mklod/silvia-lever/_status.md

# Status

## Current milestone
**Beta — daily-driver.** `redesign-precision` was **merged to `master` 2026-07-06**; all work now lands on `master`. Live UI = "Precision Instrument" (`main_precision.qml` + `precision/` lib). In and working: Boiler Stage 9 (staged dual-heat, arbitration, OPV tuned), functional **shot replay**, **Settings** (dose/scale-cal/autotune), 10 Hz scale pipeline, pump quiet cap (50%) + pot-zero deadband. Pump = FG304: MG304 4 mm gear head + Fluid-o-Tech/Crouzet 24 V BLDC, 0–5 V speed control, TACHO out available (32 pulses/rev, unwired). Thermoblock PID: 46.94/0.516/3155.89 (TL).
**Pending:** hardware test of functional replay (pull a replayed shot); brew-temp stability/accuracy experiment (HEATING.md §8, the open "!!!"); resonance damping hunt (~650–1000 Hz, user); level probe (Silvia Pro) for auto-fill/dry-fire; optional tacho wiring → volumetric metering.

## Session 2026-08-18 (21:29) — Pump noise diagnosed (gear mesh + resonance), quiet cap, pot-zero fix
- **Pump noise root-caused with data, motor swap ruled out.** FFT/order analysis of a recorded pot sweep (100→66→33→0%): gear-mesh orders (7–16× shaft) dominate by 6–11 dB over BLDC commutation (24×) at every speed. A **structural resonance at ~650–1000 Hz** amplifies whichever order lands in it (same 982 Hz peak at different speeds/orders). So an FOC-servo/motor swap ≈ 1 dB — not worth touching the sole pump. Measured true max ~4200 rpm (not 5000).
- **PUMP_PWM_QUIET**: new cap for the open-loop full-speed states (FLUSH + both PRIME fills); 65% killed the scream + OPV chirp, then dropped to **50% (127)** to put fill/flush mesh below the resonance band. User: "dull hum, acceptable." Next lever if wanted: tap-test the bracket/panels/lines for the 650–1000 Hz ring and damp it (butyl/mass) — user investigating.
- **Manual-mode pot-zero bug fixed**: pump kept running at 0% — (a) EXTRACT pwm = pot + handoverOffset so residual takeover offset kept pumping; (b) small pot/ADC offset put 0.2–0.3 V on SPEED_IN where the driver runs its 300 rpm floor. `POT_ZERO_DEADBAND` (10 counts) forces PWM 0 at/below, all three manual-drive sites. Flashed.
- **Pump identity + specs nailed down** (memory + docs): FG304 = MG304 4 mm head (0.3 ml/rev) + Fluid-o-Tech/Crouzet 24 V BLDC w/ integrated 6-step driver. Manual: 0.3–5 V → 300–5000 rpm; **yellow wire = TACHO OUT, 32 pulses/rev (~9.4 µl/pulse)** → future volumetric metering (needs 5 V→3.3 V divider to a free pin, e.g. D2; declined for now). 4 mm gear set confirmed correct (13 bar headroom, finest low-flow control); 9 mm only viable with a stronger motor and would halve rpm.
- Earlier this session (2026-07-22): scale-latency fully fixed — firmware rolling trimmed-mean @80 SPS, UI Repeater churn removed, ChartCard glow via layered strokes + threaded raster (shadowBlur was janking the GUI thread to ~1 Hz during brews only).

## Session 2026-07-06 — Doc audit + stale-reference cleanup
- **Pump docs corrected everywhere.** `PLUMBING_NOTES.md` mislabelled the pump "Ulka-style vibratory" (topology diagram + a debug note referencing a "pump solenoid" / "cutting AC"). It is a **Fluid-o-Tech FG300 24 V BLDC gear pump**; 24 V is motor supply only, speed control is a separate 0–5 V input (pot → Teensy PWM → 1k/470 nF RC filter, so a 10 V cap on that filter is fine). Fixed. Remaining `solenoid` refs are the real 3-way **valves** (V1/V2); `vibration` refs are lever/load-cell mechanical noise — both legitimate.
- **Repo hygiene:** deleted stray `NDH6SA~M` ping-output junk files; gitignored `archive/` (**8.1 GB** of deprecated OS images that were untracked).
- **Untracked reference material still undecided:** `UI.UX/` (redesign design handoff/spec), `profiles/` (profiling research PDFs/imgs), `RC FILTER … .jpg` (PCB photo). Kept out of git pending a decision to track them or not.
- **CHANGELOG was ~1 month behind** (last build entry 2026-06-02); the entire redesign/replay/settings era wasn't logged. Catching it up.

## Session 2026-06-16 (18:50) — "Precision Instrument" UI redesign LIVE + heaters-off default
- **Heaters OFF by default.** Firmware `heatersEnabled` default → false; UI also pushes `SET_HEATERS_ENABLE 0` on connect (Teensy keeps state across Pi reboots, so the UI must disable each startup). User taps HEAT to enable. Verified `OK:HEATERS_DISABLED` on boot.
- **Full UI redesign implemented and switched live** (branch `redesign-precision`). New root `main_precision.qml` + `precision/` component library (Theme singleton, Overline, PButton, StatusBar, ColumnMeter, ChartCard, StatItem, InstrumentCol, Sparkline, PhaseChart, BackChip), reusing the existing CoffeeController backend. True-black monochrome + single red accent; Archivo + JetBrains Mono bundled (`ui/source/fonts/`, FontLoader). Glow via Canvas `shadowBlur` (renders software + GPU). Five screens: Home, Set-temp modal, Brew (live white-mass/red-pressure charts), Profile picker (firmware-accurate phase data in `precision/profiledata.js` + PhaseChart + table), Shot history/replay.
- **Wiring:** profile-row tap → `controller.setProfile()`; brand "SILVIA·LEVER" tap → history; new backend `requestShots()` + `shotsChanged` reads `brew_logs/` into the history list; REPLAY animates the stored curves (ChartCard `clipT`). Old `main.qml` kept intact as fallback.
- **Live-flip:** `run_silvia.py` + `main.py` now load `main_precision.qml`. Deployed + rebooted; grim grab of the real panel confirms it renders correctly (HEAT OFF, SET 250°/203°, PRIMED, real pot/pump values).
- **Known follow-ups:** brew_recorder doesn't store the active profile name (history shows "—"); replay is visual-only (no physical re-run); could promote a dedicated history entry affordance; merge `redesign-precision` → master after live use. Old screenshot harness `_render_screens.py` (old UI) still present.

## Session 2026-06-16 (13:48) — Default steam temp → 250 °F + startup setpoint restore
- **Default steam boiler temp is now 250 °F (121.11 °C)** (was 130 °C / 266 °F). Changed in `firmware/config.h` `DEFAULT_STEAM_TEMP`, `settings_manager.py` default, `main.qml` initial `steamTargetTemp`, and the live Pi `settings.json` (steam_temp 130→121.11, other keys preserved). Firmware recompiled clean (not reflashed — see below).
- **New: setpoints are pushed to the firmware on startup.** Added `_restore_temperatures()` (mirrors the existing scale-cal / PID restore) sending `SET_TEMP BREW/STEAM` on connect (singleShot 500 ms). Previously temps were the *only* persisted setting NOT restored to the firmware on boot, so the firmware used its own config.h defaults until the user opened the setpoint popup — a latent divergence (UI showed brew 95 °C but firmware brewed at its 93 °C default). Now the UI's saved setpoints are authoritative on every boot, so this change took effect **without a firmware reflash**. Verified on reboot: log shows `Restored setpoints: BREW 95.0 STEAM 121.11` → `OK:STEAM_TEMP_SET`.
- Routed voice-to-code item (id 4e1b9ef5). Deployed + rebooted; UI validated headless.

## Session 2026-06-10 (22:40) — Brew stop hardening: double-tap + timer-reset bug
- **Incident diagnosed (from Pi logs `silvia_20260610_205506.log`):** a ~2 min manual brew "stopped at 46 s on its own." Root cause was NOT a timeout — the brew screen's giant central `MouseArea` (covers most of the screen) calls `stopBrew()` on **any single tap** while BREWING, with no button/label/confirmation. A stray capacitive ghost tap (hand near the screen during the long brew) ended the shot. Confirmed: a lone UI-originated `CMD_SENT: STOP` at 46 s, no auto-stop in code (`max_brew_time`=300 s; comm watchdog fed by 5 s PING/PONG). **A 2-min brew is safe** — the only cap is the 5-min safety timeout.
- **Fix 1 — stop = single tap on the timer clock.** (Double-tap was tried first but felt unreliable on the touchscreen — reverted.) The big central area is now **start-only and disabled while BREWING**, so a stray tap anywhere can't end a shot. Stopping is a single tap on a focused `brewStopArea` MouseArea over the clock (enabled only while BREWING). The clock glows amber while brewing to signal it's the stop target; hint reads "tap clock to stop" / "tap to start".
- **Fix 2 — brew-timer reset / double-log bug.** `stopBrew()` left `_brew_start_time` set ("keep time displayed"), so logged durations grew cumulatively (the log showed 46 s **then** 54 s for one shot) and every back-arrow re-logged a bogus `BREW_COMPLETE`. Added a `_brewing` flag (True only between `beginBrew`→`stopBrew`); duration is logged only when a brew was actually running. STOP is still always sent to firmware (safe/idempotent). Displayed time still freezes at final (intended).
- Deployed to Pi 1 (md5 match), Python+QML validated headless, rebooted → UI relaunched clean. **Needs a hot re-test** (see checklist below).

## Session 2026-06-02 (13:35) — Gauge setpoint tick + overshoot indication
- **Setpoint tick mark on both gauges.** Added `tickValue`/`tickColor`/`tickWidth`/`tickOverhang` properties to `CircularSlider.qml`; draws a radial white dash across the track at the setpoint, positioned with the same orbit transform as the handle so it lands exactly on the arc.
- **Arc leaves overshoot headroom.** Gauge `maxValue` changed from `max(actual, target, 1)` to `target * 1.2`, so at setpoint the fill stops at the tick (~83 % of the arc) and overshoot visibly pushes the arc past the tick. `value` clamped to `maxValue` so a large overshoot pins at the scale top instead of overrunning the track.
- **Overshoot number: orange + pulsing (not red).** When actual > target the gauge number turns **orange #ff9500** and pulses opacity 1.0↔0.35 (450 ms, infinite) — the same "vibratey" nag style as the PRIME glow. Resets to solid white when back at/under setpoint.
- Deployed to Pi 1 (md5 match local), QML validated headless (offscreen+mock, no parse errors), Pi rebooted → UI relaunched clean.

## Session 2026-06-02 (13:14) — UX pass: °F units, cyan/purple gauges, auto-mode + auto-heat defaults
- Steam confirmed working end-to-end by user. Five changes (all on boiler-stage9):
  1. **Temp units °C → °F** — UI displays °F everywhere (gauges, brew-screen readout, steam screen, setpoint popup). Firmware stays °C; UI converts via cToF/fToC helpers; setpoint popup steps in 1 °F and clamps in °F (brew 140–230, steam 230–302), converts back to °C for SET_TEMP. (settingsScreen still °C but is currently unreachable — convert when a re-entry gesture is wired; see TODO.)
  2. **Gauge colors** — thermoblock now **cyan #00bcd4**, boiler **purple #9b59b6** (was blue/orange). Setpoint popup + PRIME button recolored to match.
  3. **Brew mode default AUTO** — firmware `autoBrewMode` defaults true; added as telemetry field 17 so the UI's BREW: AUTO/MAN button reflects firmware on boot (backend parses field 16).
  4. **Removed SCALE cell** from the debug row (weight still on the brew screen). Row now: heat, brew mode, profile, pressure, pump.
  5. **Auto-heat from cold boot without manual prime** — firmware `boilerPrimed` now defaults **true** (was false). Heating proceeds from boot (staged boiler-first preheat) with no PRIME step. Accepted dry-fire risk (user, minimal w/ conscientious use). PRIME button still fills manually. Backstops retained: MAX_STEAM_TEMP + thermal fuse + watchdog; level probe is the real fix.
- Telemetry now 17 fields (added autoBrewMode). Flashed (verified primed=1, auto=1), UI deployed (md5 match), QML validated headless.

## Session 2026-06-01 (14:16) — Steam works: OPV tuned, staged dual-heat verified on hardware
- **OPV adjustment solved the 99 °C dump.** Virgin steam-boiler OPV was set too low (relieved at ~0 bar → boiled off at 99 °C, never made steam). Torqued the OPV screw down to hold steam pressure → **zero steam / zero spitting on the boiler OPV water-return hose**, boiler climbed cleanly to **140 °C**, then the thermoblock reached its setpoint shortly after. Confirms the OPV setpoint caps boiler temp (saturation) per OG_SILVIA_OPERATION.md §5b.
- **Cold-start staging verified:** boiler heats first (thermoblock inhibited) to its target, emits `BOILER_READY`, then the thermoblock is released and reaches setpoint. No 16.6 A parallel warmup.
- **Steam-SSR fix confirmed working:** boiler SSR fires (digitalWrite on pin 16; analogWrite was a silent no-op — pin 16 isn't PWM on Teensy 4.0). Thermoblock stayed cold during boiler preheat.
- **Heater arbitration clarified/validated:** tapping BREW does NOT cut the boiler — it keeps maintaining in the background, throttled by the 1-tick mutex while the thermoblock is busy (coasts a few °C, covered by the +5 °C overshoot, recovers after the shot). STEAM is the only hard-cut: thermoblock → 0, boiler → full duty. Boiler is only fully off when unprimed / heatersEnabled off / over MAX_STEAM_TEMP. (Full state table added to HEATING.md §5.)
- **STEAM button role:** purely a heater-arbitration mode switch — no valve action (steam is the manual wand). It cuts the thermoblock and hands the boiler the full element for strong steam; without it the tick-mutex would split power → weaker steam.
- Still pending hardware: the Silvia Pro **level probe** (part 10701803, 3/8 BSP) for auto-fill + dry-fire safety (LEVEL_SENSING.md). Boiler is steam-only (not refilled by brewing) so this is the one genuine gap vs an OG Silvia.

## Session 2026-05-29 (01:26) — Stage 9 boiler implemented (branch boiler-stage9, pre-hot-test)
- **Fallback locked first:** tag `brew-only-stable` (master HEAD) + fallback hex saved locally and on Pi 1 at `/home/gram/silvia_fw_BREWONLY_FALLBACK.hex`. Boiler work is on branch `boiler-stage9`; master stays brew-only for morning coffee. To restore brew-only: `git checkout brew-only-stable`, or reflash the fallback hex.
- **Boiler enabled, task-switch model (brew XOR steam), firmware only — no current-monitor hardware** (user deferred the CT-clamp idea indefinitely).
  - Dry-fire prime gate: `boilerPrimed` (RAM). `arbitrateHeaters()` blocks all heating until primed. Prime = cold-fill (PRIME_BOILER → overflow → PRIME_DONE).
  - `arbitrateHeaters()`: steaming → thermoblock HARD CUT, boiler active; cold-start → boiler first, thermoblock inhibited until boiler at target; brew/idle → thermoblock active, boiler maintenance only on ticks thermoblock didn't fire (1-tick mutex → ≤8.3 A always).
  - Steam target = steamTemp + 5 °C overshoot. Telemetry +2 fields (boilerPrimed, boilerPreheatComplete). New PRIME_BOILER cmd; BEGIN_STEAM requires primed.
- **UI home reorg:** removed logo + CONNECTED text; two gauges side by side (THERMOBLOCK left w/ BREW+FLUSH, STEAM BOILER right w/ STEAM+PRIME); PRIME glows amber until primed; STEAM disabled until primed.
- **Validated:** firmware compiles (52504 B, hex at L:/tmp-pi-flash/build-boiler/); QML loads headless offscreen+mock, no parse errors, braces balanced.
- **NOT done:** hot test, Teensy flash, Pi deploy — all deferred to a supervised session so morning-coffee fallback stays intact. Next: flash boiler-stage9 + deploy UI + supervised hot test (prime → preheat → steam → brew, clamp-meter ≤8.3 A).

## Session 2026-05-22 (13:19) — light-roast profiles + debug-row cleanup
- Added 3 profiles (5 total): Blooming Allongé (4-seg: fill→bloom→percolate→declining taper — the fruity-light-roast profile), Blooming Espresso (3-seg), Allongé (2-seg). All from PROFILES.md §3.3/§3.4. Compiled, flashed, GET_PROFILES confirms all 5.
- Debug row: removed V1/V2 valve cells (water flow + valves verified working). Row now: heat, brew mode, profile, scale, pressure, pump.
- Gentle & Sweet first brew-test (build 0139): profile engine works — dead-flat 6 bar hold 49 s, zero overshoot. Shot ran slow (~0.59 g/s) — grind too fine for a 6-bar profile (lower pressure needs coarser grind), NOT a profile fault. Channeling visibly improved on bottomless PF.
- Portafilter debug: headspace/channeling root cause = Ascaso group is an E61-*variant*; Silvia PF is Rancilio-pattern → seats wrong. User ordered a couple aftermarket PFs to test. Gasket confirmed preinstalled (non-issue).
- Flash gotcha recurred: backgrounded teensy_loader_cli got SIGHUP'd when the SSH session closed → Teensy left in HalfKay. Re-ran loader directly (already in bootloader) → flashed. Going forward: nohup the loader, or run it foreground.
- Next: brew-test the new profiles, especially Blooming Allongé on a very light roast.

## Session 2026-05-22 (01:39) — Stage 1: brew profile engine + Gentle & Sweet
- Built the segment-table profile engine (PROFILES.md §3.2). A profile = ordered list of `(targetBar, slewRate, gains, exit)` segments; `runBrewSegmentEngine()` plays them through the Stage-0 slew-rate controller. The hardcoded preinfuse/ramp/hold state machine is gone.
- Two profiles: Profile 0 "Standard 9-bar" (faithful Stage-0 re-expression, regression baseline), Profile 1 "Gentle & Sweet" (light-roast starter — flat 6 bar hold).
- `SET_PROFILE`/`GET_PROFILES` serial commands. UI `PROF:` button in the debug row cycles profiles; qml_backend learns the list from firmware (no hardcoded names).
- Compiled clean, flashed, GET_PROFILES verified. **Not yet brew-tested** — Profile 0 regression + Profile 1 6-bar hold need a real shot.
- Flash gotcha: Teensy re-enumeration browned out Pi 1 mid-flash (it had prior "Undervoltage detected!" in dmesg). Power-cycle + re-flash recovered. Pi PSU is marginal — recommend a beefier 5V supply.
- Next light-roast profiles per §3.4: Blooming Allongé, Blooming Espresso, Allongé/Turbo, Adaptive Bloom.

## Session 2026-05-22 (00:36) — Stage 0 brew control finalized (slew-rate), manual takeover, AUTO/MAN toggle
- Brew-overshoot fight resolved. Three control designs tried on the real machine with a fine restrictive grind:
  1. Open-loop PWM ramp → 14 bar.
  2. Closed-loop linear RAMP-sweep + separate HOLD → ~11.5 bar overshoot at RAMP→HOLD boundary. Bumpless transfer / integrator reset / D-term all failed — root cause is pump→pressure transport lag (~200 ms), not tuning.
  3. **Final, working:** single PI(D) loop, one gain set, setpoint *slews* 1.0→9.0 bar at 0.8 bar/sec. Controller always keeps up, integrator self-adapts to puck. Verified zero overshoot, rock-steady 8.9 bar HOLD.
- RAMP + HOLD are now one loop (phase label telemetry-only). Removed `RAMP_MS`, `HOLD_MS`, per-phase `RAMP_*`/`HOLD_*` macros, and `rebaseIntegratorForTransition()`.
- Manual takeover: rotate pot >10% during RAMP/HOLD → bumpless handoff to pot (`handoverOffset` captured, no pressure step).
- AUTO/MANUAL: `autoBrewMode` firmware flag + `SET_AUTO_MODE` serial command + `BREW: AUTO/MAN` UI button (debug row, green/grey). Firmware defaults MANUAL.
- PREINFUSE retuned: 1.0 bar target, exit on 1 g OR 10 s hard cap (`PREINFUSE_MAX_MS`).
- Chart big-numbers freeze on brew stop (final weight/pressure readable after the shot).
- Firmware build/flash workflow established: arduino-cli (bundled w/ Arduino IDE 2.x) → pscp .hex to Pi 1 → teensy_loader_cli + 134-baud reboot. Gotcha: if 134-baud races an in-progress flash, Teensy sticks in HalfKay — just re-run the loader.
- All committed; docs (PROFILES.md §0/§1, CHANGELOG, this file) updated.
- **User flagged more changes coming next.**

## Session 2026-04-24 (20:17) — Pi 2 brought to parity; HDMI artifact narrowed to Silvia hardware

- Pi 2 setup needed several fixes that exposed gaps in `setup_rpi.sh` for Pi OS Lite:
  1. **labwc + kanshi + wlr-randr + seatd not installed by default on Lite** (they ship with the labwc-pi metapackage on Pi OS Full). Added to setup_rpi.sh package list.
  2. **bash_profile `exec /usr/bin/labwc`** caused getty start-rate-limit loop on headless boot (no display → labwc fails → bash exits → getty restarts → fail). Dropped the `exec` so bash falls through to interactive shell when no display is present. With display attached, labwc never returns until shutdown.
  3. **`pscp -r` from Windows strips +x bit** on `run_silvia.sh` and `run_silvia.py` → labwc autostart silently fails. Added defensive `chmod +x` early in setup_rpi.sh.
  4. **`quiet splash plymouth.ignore-serial-consoles` not in Pi OS Lite cmdline.txt** (Pi OS Full had them by default). Without `splash`, plymouth-start runs but draws nothing → kernel/systemd messages flood tty1 visibly. Added to cmdline patch loop.
  5. **`~/.config/kanshi/config` only auto-created by labwc-pi wrapper** (Pi OS Full). On Lite using plain labwc, no kanshi config = panel renders landscape instead of portrait. Bake the rotation profile into setup_rpi.sh.
  6. **`~/.config/labwc/rc.xml` not present on Pi OS Lite** (no labwc-pi installation). Without rc.xml's `<touch deviceName=... mapToOutput=...>`, touch coordinates stay in raw (un-rotated) space while display is rotated 90° → touch appears mirrored. Added `ui/rpi/labwc-rc.xml` to the repo and setup_rpi.sh installs it.
- Pi 2 now boots cleanly to either silvia kiosk (default) or pcmanfm desktop (debug mode), with touch correctly rotated and labwc + kanshi + silvia all autostarting.

### HDMI cold-boot artifact diagnostic

Pi 2 was used as an A/B reference for the pre-firmware HDMI panel artifact that the Silvia hardware shows on cold boot (bright/jarring "garbage" before kernel KMS comes up).

| Setup | Touch FW | Artifact |
|---|---|---|
| Silvia panel + Silvia driver board | yes | **YES** |
| Bench panel + bench driver board | yes (working) | **NO** |

So the artifact is NOT a generic "any touch firmware" issue — both setups have working touch FW now. **Variable causing the artifact is specific to the Silvia hardware combination** (panel, driver board, or board FW version).

Next decisive tests (require physical swap):
- Connect **Silvia panel** to **bench driver board**: if artifact disappears, the driver board is the cause. If it persists, panel is.
- Connect **Silvia driver board** to **bench panel**: if artifact appears there, board is cause. If not, panel is.

Either swap isolates root cause. Until done, GPIO/MOSFET hardware delay fix is on hold — the cause may be firmware-side on the driver board, in which case a FW config bit (e.g. "show test pattern on boot" debug flag) might be the entire fix with no electronics added.

## Session 2026-04-24 (15:55) — Stage 0 brew control, chart freeze, Pi 2 ready, Teensy flashed
- First hot test brew log analysed: PREINFUSE worked (2.53 bar at exit), but open-loop RAMP slammed fine grind to 13.97 bar peak; HOLD's P-only couldn't recover in 3 s; pot-controlled EXTRACT was too weak. Root cause: only PREINFUSE was closed-loop on pressure.
- **Stage 0 firmware shipped**: shared `pumpClosedLoop()` PI helper with anti-windup. RAMP rewritten as closed-loop pressure-target sweep (2.5→9.0 bar over RAMP_MS, no more PWM blast). HOLD made indefinite (removed HOLD_MS gate; user STOPs the brew). EXTRACT now manual-override only. I-term added everywhere.
- **Compiled** with arduino-cli (bundled with Arduino IDE 2.x at C:\Users\mklod\AppData\Local\Programs\Arduino IDE\resources\app\lib\backend\resources\arduino-cli.exe), `--fqbn teensy:avr:teensy40`. Output to L:\tmp-pi-flash\build\silvia_lever_main.ino.hex (191 KB).
- **Flashed** via `teensy_loader_cli` on Pi 1 (already installed). Soft-reboot trick: `python3 -c "import serial; serial.Serial('/dev/ttyACM0', 134); ..."` — Teensy USB Serial special baud 134 enters bootloader without physical button press. Booting confirmed.
- **UI freeze**: main.qml chart big-numbers freeze on BREWING→IDLE transition, clear on next BREWING. Live debug row keeps flowing. Pushed to Pi 1, rebooted, verified.
- **Pi 2 (silvia-pi-2 / 192.168.1.30)** is a complete drop-in replacement card. Setup via WSL-less workflow: dd-stream xz decompression → \\.\PhysicalDrive raw write via PowerShell-launched dd-for-Windows, cloud-init for first boot. Latest local working tree pscp'd, setup_rpi.sh ran clean. bash_profile updated to drop `exec` on labwc so headless boot doesn't trigger getty rate-limit loop. Boot 10.7 s headless. Will run full kiosk with HDMI + Teensy attached.
- Workflow established: edit firmware locally → arduino-cli compile → pscp .hex to Pi 1 → teensy_loader_cli + 134-baud reboot → flash. End-to-end ~30 sec from edit to running on the espresso machine.
- Next: brew test the new firmware. RAMP should sweep cleanly with no overshoot. If still high, drop RAMP_KP / RAMP_BASE_PWM. Then move to Stage 1 (named profile menu).

## Session 2026-04-24 (03:13) — plymouth black splash + invisible cursor, 8.04 s boot
- Plymouth re-enabled with custom all-black theme. Covers ~one of the two terminal text flashes during boot. Attempted to stretch coverage by masking plymouth-quit.service, but that deadlocks boot (plymouth-quit-wait blocks multi-user.target). Reverted. One residual flash remains in the plymouth-quit → getty → labwc window.
- Invisible cursor: `XCURSOR_THEME=empty` pointing at a user-local theme where every cursor file is a 1×1 transparent PNG (xcursorgen from python-generated PNG). Wired via `~/.config/labwc/environment`. Touch+mouseEmulation still works from labwc rc.xml.
- Pre-firmware display artifact is hardware-only: HDMI OLED panel powered off USB 5V which is live from moment-zero. Pi 4B can't cut USB power in software (VL805 hub). Discussed A/B/C options; user considering Pi 5 (2 GB is plenty for this workload — current usage is ~450 MiB on 4 GB Pi 4B).
- Boot best: 8.04 s (2.44 kernel + 5.61 userspace). 1× labwc, 1× kanshi, 1× silvia. Pending visual confirmation of cursor + flash-count from user.
- Next potential work if user cares enough: convert labwc startup from getty/bash_profile path to a systemd service so `plymouth-quit.service` can be ordered `After=labwc.service` — would close the last flash.

## Session 2026-04-24 (02:46) — kill desktop flash (labwc --config-dir isolation)
- Desktop/wallpaper/panel briefly visible before silvia = labwc-pi running `/etc/xdg/labwc/autostart` (pcmanfm-pi + wf-panel-pi + lxsession-xdg-autostart) unconditionally. A user-level `~/.config/labwc/autostart` did NOT override it — both ran, producing duplicate kanshi + duplicate silvia instances.
- Fix: skip `labwc-pi` wrapper entirely, bash_profile now `exec /usr/bin/labwc --config-dir ~/.config/labwc -m`. `--config-dir` pins labwc to one config dir — system autostart is never read.
- Post-reboot: 1× labwc, 1× kanshi, 1× silvia. No pcmanfm-pi, no wf-panel-pi, no lxsession-xdg-autostart. Duplicate silvia eliminated. Boot 9.22 s (2.50 kernel + 6.71 userspace).
- Baked into `setup_rpi.sh`. Pi env still inherited via `. /usr/bin/setup_env` (labwc-pi sourced it too).
- Two terminal flashes may still remain — plymouth black splash is the final option if user wants to fully eliminate them (~0.5 s cost).

## Session 2026-04-24 (02:36) — kill boot terminal flashes
- Cold boot still flashed a couple of terminal-text screens between firmware and labwc. Root cause: kernel + systemd + getty were spraying text onto tty1 — the same VT labwc takes over.
- Three-part fix:
  1. `console=tty1` → `console=tty3` in `/boot/firmware/cmdline.txt` (kernel/systemd output → invisible VT)
  2. agetty `--noissue --nohostname` + `TTYVTDisallocate=no` on the override (kills banner, smoother VT handoff)
  3. `~/.hushlogin` (silences pam_motd + last-login message during autologin)
- Boot 9.94 s (similar to 8.8 s, within noise). labwc + silvia confirmed autostarting via SSH — visual confirmation pending user cold-boot test.
- All baked into `setup_rpi.sh`. Pi backup at `/boot/firmware/cmdline.txt.pre-tty3-bak`.

## Session 2026-04-24 (02:28) — getty autologin race fixed (Type=idle), 8.8 s boot
- First reboot after the L2→L1 revert landed at the bare login prompt: agetty stuck in `(agetty)` state, autologin never fired, labwc/silvia never launched. `After=systemd-user-sessions.service` alone was not sufficient to beat the pam_nologin race.
- Added `Type=idle` to `/etc/systemd/system/getty@tty1.service.d/autologin.conf`. `Type=idle` holds the unit until systemd reports no other units are starting — enough extra slack for pam to clear pam_nologin consistently.
- Next reboot: labwc (pid 735) + silvia (pid 858) both came up automatically. Also boot time dropped: **10.6 s → 8.8 s** (systemd-analyze: 2.856 s kernel + 5.967 s userspace). Total reduction from baseline: 26.3 → 8.8 s (67%).
- Baked into `setup_rpi.sh` so fresh deploys get it. Comment block updated to explain the two-part fix (After= **and** Type=idle — neither alone is reliable).

## Session 2026-04-24 (02:10) — L2 reverted to L1, KIOSK.md created
- L2 (cage) tried — boot was 10.0 s but broke touch (libinput matrix not auto-rotated), showed persistent mouse cursor, and added two extra boot-screen flashes. Reverted to L1 (labwc-pi via getty autologin), boot now 10.6 s — within noise of L2.
- L2 leftover packages (cage, wlr-randr) kept installed; harmless when bash_profile points at labwc-pi.
- All other L2-era changes are orthogonal and stayed: NM→networkd swap, `systemd-networkd-wait-online` disable, static /etc/resolv.conf, getty autologin with `After=systemd-user-sessions`.
- New `KIOSK.md` at project root: boot-time journey (26.3 → 10.6 s, 60% reduction), things-tried-that-didn't-help log, L3 (Qt eglfs) and L4 (Alpine / Buildroot / Yocto / no-systemd) options with realistic estimates, deep dives on Buildroot + Yocto, honest "stop here" recommendation.
- `setup_rpi.sh` updated to write the L1 bash_profile (was L2 cage version) so a fresh deploy reproduces the working end state.

## Session 2026-04-24 (01:53) — L2 kiosk via cage (boot 11.7 s → 10.0 s)
- Replaced lightdm + labwc + pcmanfm-pi + wf-panel-pi with `cage -s -- silvia` directly. tty1 autologin fires `~/.bash_profile` which exec's cage. cage spawns wlr-randr (rotation fix for the portrait-native 1080×1920 panel) then silvia.
- Boot history: **26.3 → 10.0 s** total wall-clock from baseline (62% reduction). Multi-user.target at 6.59 s userspace.
- Two boot-race / DNS gotchas fixed and baked into `setup_rpi.sh`:
  - `getty@tty1.service` needs `After=systemd-user-sessions.service` or pam_nologin rejects the autologin
  - `/etc/resolv.conf` goes blank when NM is disabled (no auto-regen by networkd unless systemd-resolved is running) → write static fallback
- L1 (just removing lightdm) was a near-no-op (~0.3 s). L2 (skip the whole desktop stack) was the real win — pcmanfm-pi + wf-panel-pi spawning was the actual cost.
- Snapshots pre+post-L2: `silvia-rpi-snapshot-2026-04-24-0130.tar.gz` (L1) and `silvia-rpi-snapshot-2026-04-24-0153.tar.gz` (L2 current).
- Rollback: `cp ~/.bash_profile.l1.bak ~/.bash_profile && sudo reboot` reverts to L1 in 30 sec.

## Session 2026-04-24 (01:18) — NM → systemd-networkd swap (boot 15 s → 11.7 s)
- Swapped NetworkManager for `systemd-networkd` + `wpa_supplicant@wlan0`. WiFi association moved off the boot critical path. **graphical.target now at 7.45 s userspace** (was 11.07), total cold-boot to interactive ≈ 11.7 s (was 15.0).
- Done under `silvia-deadman` protection (10-min auto-revert). Confirmed clean within 30 s of reboot.
- NM kept on disk for one-command rollback (see `RPI_RESTORE.md`).
- `setup_rpi.sh` made idempotent for the swap (only fires if `wpa_supplicant-wlan0.conf` exists; protects WiFi creds from being baked into repo).
- Snapshots taken pre+post: `silvia-rpi-snapshot-2026-04-24-0041.tar.gz` (NM) and `silvia-rpi-snapshot-2026-04-24-0118.tar.gz` (networkd).

## Session 2026-04-24 (00:40) — Pi backup/restore + deadman + boot-trim post-mortem
- **Pi state snapshot**: `tools/rpi_snapshot.sh` tarballs every changed config + audit lists. First baseline saved to NAS.
- **`silvia-deadman` installed** on Pi (`/usr/local/bin/`). Generic auto-rollback timer for risky changes — arms a `systemd-run --on-active=Nm` transient that runs a revert command if user can't `confirm` in time. Smoke-tested arm/confirm cycle clean.
- **`RPI_RESTORE.md`** captures: snapshot contents + Path A (from tarball) and Path B (from scratch) restore recipes, per-change reversion commands, deadman usage with NM-swap example.
- **Boot-time post-mortem**: pushed from 26 → 15 s. Hit a structural floor at 15 s; documented in `setup_rpi.sh` header what was tried and abandoned (fastboot, IPv6 disable, BT disable, drop-in After/Before= resets, direct unit edits) so we don't re-explore. Real next steps for sub-15: A2 SD card (drop-in), systemd-networkd swap (config rewrite + deadman armed), USB SSD (hardware).

## Session 2026-04-23 (23:28) — HOLD phase + RPi boot trim + UI autostart
- **HOLD phase added** between RAMP and EXTRACT — closed-loop 9 bar for 3 s lets pump speed settle before user takes manual control. brewPhase enum now 0-3, backend + PROFILES.md updated.
- **RPi boot-time wins**: disabled `NetworkManager-wait-online` (5.9 s), masked entire `cloud-init` chain (~13 s), disabled `cups`/`bluetooth`/`ModemManager`/`rpi-eeprom-update`/`rpi-resize-swap`. Baseline 26 s → expected 13-15 s post-reboot.
- **UI autostart on boot**: `setup_rpi.sh` installs `~/.config/autostart/silvia.desktop`. Exec points to `run_silvia.sh` which always reads live `ui/source/` files, so scp'd updates take effect on next boot with no rebuild step.

## Session 2026-04-23 (21:09) — Auto preinfuse + brew recorder + PROFILES.md
- **Auto preinfuse landed** (firmware sub-state machine in STATE_BREWING): closed-loop P at 2.5 bar until 5 g in cup → 4 s linear PWM ramp to full → manual pot control. Tunables in `config.h`.
- **Per-brew JSON recorder** (`ui/source/brew_recorder.py`): every shot dumps to `brew_logs/brew_YYYY-MM-DD_HH-MM-SS.json` with metadata + 10 Hz samples. Substrate for Stage 8 profile derivation.
- **DATA telemetry** now 14 fields (added `brewPhase`).
- **`PROFILES.md`** created: documents current preinfuse + brew JSON schema + sketches Stage 8 named-profile system (schema, control modes, player loop, profile derivation from recordings).

## Session 2026-04-24 (02:24) — Thermoblock cold-start ramp measured
- **~58 s at 8.3 A continuous** to climb 25 °C → 88 °C (bang-bang handoff to PID). Captured via WiFi plug CSV (85 samples).
- Refines Stage 9 cold-start budget: boiler 6 min sequential + thermoblock ~1 min concurrent with boiler maintenance = **~7 min total cold → ready-to-brew + steam-available**.
- HEATING.md §1 / §5 updated with measurement + budget table; workplan S9.7c marked done.

## Session 2026-04-23 (17:19) — First successful PID autotune
- **Autotune ran end-to-end on hot thermoblock**: `Ku=142.9, Tu=139 s, a=1.14 °C → TL Kp=46.94, Ki=0.516, Kd=3155.89`. Auto-applied; persisted in `settings.json`; backend re-sends on every reconnect.
- **Three autotune bugs fixed:**
  - Asymmetric-period bug — was summing only heating halves ×2, so Tu underestimated ~3× → Kd came out wrong. Now sums every half-period.
  - Sanity bounds mismatch between autotune and `SET_PID` — autotune accepted new Kd, then restore rejected it. Bounds now identical (Kp<500, Ki<50, Kd<5000).
  - Hysteresis + timeout too tight — widened 0.5 → 1.0 °C, 10 → 25 min timeout.
- **Derivative-on-measurement + first-order low-pass filter** (`PID_D_FILTER_TAU = 2 s`) added to PID. Needed because TL's `Ku·Tu/6.3` = 3156 would noise-amplify raw PT1000 jitter. Filter lets real thermal slopes through, kills sensor noise.
- **`HEATING.md` updated** with asymmetric-period handling, widened bounds, derivative filter math, first-autotune result in revision log.

## Session 2026-04-23 (02:34) — PID autotune + bang-bang warmup + HEATING.md
- **Layered thermoblock control**: bang-bang full duty when `error > 5 °C`, PID when within band. Fixes first-hot-test overshoot.
- **Relay-feedback autotune** (`AUTOTUNE_START/STOP`) lands in firmware. UI Settings → PID → AUTOTUNE opens a live-log modal. Auto-applies Tyreus-Luyben gains on success; Python persists to `settings.json` + re-sends `SET_PID` on every reconnect.
- **Runtime PID gains** — `sys.kp/ki/kd` now mutable, seeded from `config.h`. New `SET_PID` command.
- **Test-mode config**: `heatersEnabled` default TRUE, boiler `controlSteamHeater()` calls removed. Flip both back before shipping.
- **New `HEATING.md`** — dedicated reference doc for thermal control, PID tuning procedure, Stage 9 dual-heater staggering design, SSR wiring notes.
- SSR wiring confirmed: L → SSR T1 → T2 → thermal fuse → element → N (SSR on hot side so element is isolated when off).

## Session 2026-04-22 (13:35) — Heater master switch + priming popup rewire

## Session 2026-04-22 (13:35) — Heater master switch + priming popup rewire
- **Firmware**: added `SystemData.heatersEnabled` (default OFF) gating both SSRs; `SET_HEATERS_ENABLE <0|1>` command; 13th field `heatersEnabled` in DATA packet. Compile-verified on Teensy 4.0.
- **Backend**: parses new field, `heatersEnabledChanged` signal + `setHeatersEnabled(bool)` slot. Removed the `_auto_primed_brew` auto-skip.
- **QML**: tap-to-toggle `HEAT: ON/OFF` cell in the persistent debug row (red bold when ON). Priming overlays rewired — window-level `brewPrimingOpen` / `steamPrimingOpen` properties decouple overlay visibility from firmware state; single START/STOP toggle (green↔red, based on `currentState == "PRIMING_*"`); `×` dismisses with optional abort; overlay auto-dismisses on STOP.
- **Flash pending**: user runs `tools/flash_and_run.ps1` when ready. RPi unreachable at push time (192.168.1.33 host unreachable), so QML/backend not yet copied to Pi.

## Session 2026-04-17 (00:52) — Tap-to-launch + disconnected navigation

## Session 2026-04-17 (01:00) — Tap-exit, Teensy hotplug hardening, pcmanfm UX
- **Exit tap zone** (`main.qml`): invisible 144×144 top-right MouseArea fires `Qt.quit()` — mirror of bottom-right E-stop. Lets the user leave fullscreen on the RPi without a keyboard.
- **pcmanfm `quick_exec=1`**: added to `~/.config/libfm/libfm.conf` so tapping a `.desktop` icon executes directly instead of popping the "Execute / Execute in Terminal" dialog. Together with `single_click=1` → true one-tap launch.
- **Teensy udev rule** (`ui/rpi/99-teensy.rules` → `/etc/udev/rules.d/`): `SUBSYSTEM=="tty", ATTRS{idVendor}=="16c0", ENV{ID_MM_DEVICE_IGNORE}="1", GROUP="dialout", MODE="0660"`. Prevents ModemManager from AT-probing the Teensy for ~5 s on hotplug (would block first UI connection). Also pins group/perms.
- **`setup_rpi.sh`** now idempotently: upserts libfm `[config]` keys, installs the udev rule + reloads, renders + trusts the desktop shortcut, runs `gdk-pixbuf-query-loaders --update-cache`.
- Verified: after all fixes, tapping the shortcut single-tap launches fullscreen with 0 dialogs.

## Session 2026-04-17 (00:52) — Tap-to-launch + disconnected navigation
- **UI runs cleanly without Teensy** — `safety_manager.py` now arm-on-first-telemetry (flag stays False until first packet), so no "EMERGENCY STOP: Communication timeout" spam when no hardware connected. Fires exactly once per disconnect event when previously armed.
- **Fixed `--mock` bug**: `qml_backend.py` now picks Mock vs Real SerialManager inside `__init__` via `_get_serial_manager_class()` helper. Previously bound at module load before CLI args parsed.
- **pcmanfm single-click**: `~/.config/libfm/libfm.conf` `single_click=1`. Touchscreen tap now launches instead of selecting/renaming.
- **Verified**: home screen rendered cleanly with RANCILIO logo visible, 0 error dialogs over 15s.

## Session 2026-04-17 (00:43) — Desktop shortcut on RPi
- Added `ui/rpi/silvia.desktop.in` template; `setup_rpi.sh` renders it to `~/Desktop/silvia.desktop` with correct paths, chmods +x, marks trusted via `gio`.
- Installed `qt6-svg-plugins` + `librsvg2-common` + ran `gdk-pixbuf-query-loaders --update-cache` → fixes both Qt's QML SVG rendering (for logo inside the app) AND pcmanfm's desktop-icon SVG rendering. Added to `setup_rpi.sh`.
- Desktop now shows "Silvia Lever" icon with logo; `dex` test confirmed shortcut launches the UI.

## Session 2026-04-17 (00:20) — RPi live deployment
- **Deployed to RPi 4B at 192.168.1.33** (user `gram`, Pi OS Bookworm, aarch64, labwc/Wayland).
- `scp`'d `ui/source/` and `ui/rpi/` to `/home/gram/silvia-lever/ui/`, ran `setup_rpi.sh`.
- **Additional packages discovered needed** (added to `setup_rpi.sh`): `qt6-wayland`, `libxcb-cursor0`, `libqt6svg6`, and the full set of `qml6-module-qtquick-*` runtime modules. `python3-pyqt6` alone is insufficient on Bookworm.
- `run_silvia.sh` updated to export Wayland env vars (XDG_RUNTIME_DIR, WAYLAND_DISPLAY, QT_QPA_PLATFORM) with fallbacks so SSH launches work.
- **Verified fullscreen 1080p rendering**: screenshot via `grim` shows BREW/STEAM/FLUSH buttons, 25°C gauge arc, DISCONNECTED indicator top-right, full debug row (SCALE/PRESS/PUMP/V1/V2) at bottom — all at correct 2× font scale. Platform shim reports `raspberry-pi`, scale 2.0, fullscreen True.
- **Pre-existing bug surfaced**: `--mock` flag ineffective because `qml_backend.py` imports `SerialManager` at module load before argparse runs. Not blocking real deployment (Teensy will be plugged in). Fix deferred.
- **SVG logo**: `libqt6svg6` installed but main.qml:339 still logs "Unsupported image format" on `logo.svg` — deferred (cosmetic only).

## Session 2026-04-16 (late) — RPi port via platform shim
- **Shared source tree**: `ui/windows/source/` → `ui/source/`. Same Python/QML runs on Windows dev and RPi.
- **`platform_shim.py`**: detects RPi via `/proc/device-tree/model`, sets `QT_SCALE_FACTOR=2.00` (1080p target = 2× the 960×540 Windows dev layout) and enables fullscreen by default. Qt renders natively at scaled size so fonts stay crisp — no QML edits required.
- **Wired into both entry points**: `main.py` (flash-and-run) and `run_silvia.py` (CLI with `--mock`/`--port`/`--fullscreen`). `apply_qt_env()` runs before `QGuiApplication` is constructed.
- **RPi launchers**: `ui/rpi/setup_rpi.sh` (apt deps, dialout group) + `ui/rpi/run_silvia.sh`.
- **Serial already cross-platform**: `serialcom/real_serial_manager.py` uses Teensy VID (0x16C0) via `pyserial`; auto-detects `COM*` on Win, `/dev/ttyACM*` on Linux. Zero code change.
- **Stale tree removed**: `ui/rpi/pyqt6/` (diverged pre-alpha), plus old `.txt`/`.rar` build notes.
- **Tooling**: `tools/flash_and_run.ps1` paths updated to `ui/source/`; `.gitignore` updated.
- **Docs**: workplan Stage 7 → DONE (80% total); key file table updated; CHANGELOG entry.
- **Verified on Windows**: `python main.py` loads QML, backend imports, Teensy auto-connects on COM9 — confirmed rename + shim didn't break anything.

## Last session (2026-04-16)
- **Scale subsystem solved end-to-end**:
  - Old load cell had silently failed (replaced with new mechanical assembly)
  - Switched to `getWeight(true, 32)` for 32-sample averaging → ±0.1g stability with cal factor 2050.65
  - Cal factor persists in `settings.json`; restored automatically on UI startup
  - Tare must still be done after each session (not persisted in firmware)
  - Scale stats writeup: `SCALE DRIFT, REPEATABILITY, UNCERTAINTY CALCULATIONS.md`
- **Plumbing finalized**:
  - Inverted V1 polarity so de-energised default = pump→thermoblock (heaviest duty)
  - V2 wiring: portafilter manifold on V2 IN; OUT2=drain (de-energised default → instant pressure relief)
  - Flush state corrected: V2 ON during flush (water through portafilter); V2 OFF on stop (drains pressure)
  - Plumbing notes + safety analysis: `PLUMBING_NOTES.md`
- **UI overhaul**:
  - Black background, white text, white-outline buttons throughout
  - Auto-save settings on each ±°C tap (no SAVE button)
  - Persistent debug row (SCALE / PRESS / PUMP / V1 / V2) at bottom of all screens with monospace, fixed-width values
  - Cal dialog: single modal, auto-tares on open, 1-second cal averaging (was 6.4 s at low SPS)
  - Brew screen: tap-anywhere-in-middle to start/stop brew, no play/pause buttons
  - Flush + Steam buttons converted to single-toggle with active "depressed" state
  - E-stop: invisible 144×144 bottom-right tap area, fires ABORT + red toast banner
- **Firmware cleanup**:
  - SPI hard-reset at top of `setup()` (Teensy 4.0 LPSPI4 stale-state fix)
  - Pump ENA on D3 (optoisolator gate, prevents boot glitch)
  - PUMP_PWM_FULL = 254 (255 outputs constant HIGH on Teensy 4.0)
  - NAU7802 init order: I2C → ADS1115 → pressure cal → PT1000 SPI → NAU7802 last
- **Tooling**:
  - `tools/flash_and_run.ps1` — one-shot compile/upload/launch via arduino-cli with `-NoCompile -NoUpload` flags for UI-only iteration
- **Doc cleanup**: removed stray `.txt` duplicates and root `settings.json`; `.gitignore` updated for `logs/`

## Next immediate task
- Plug Teensy into RPi → verify `/dev/ttyACM0` enumerates, UI flips to CONNECTED, telemetry streams
- Extended brew + steam + flush sessions on real hardware; collect logs for drift / regressions
- Tune PID after warming the thermoblock to setpoint a few times
- Autostart silvia on RPi boot (labwc-pi autostart entry or systemd --user unit)
- Decide on profile system (Stage 8) after a few weeks of real-world use

## Blockers
- None

## Key decisions
- SPI hard-reset at top of `setup()` is mandatory for SPI+I2C on Teensy 4.0
- NAU7802 init must include `setSampleRate` + `calibrateAFE`; init last in setup()
- Use `getWeight(true, 32)` for the scale read — single-call averaging gives ±0.1 g
- Both 3-way valves wired so the de-energised default is the most-used state (saves coil power and heat)
- V2 IN = portafilter manifold (NOT thermoblock outlet) — puts pressure sensor and relief path on the same physical port
- Cal factor lives in UI `settings.json` (not EEPROM); restored via SET_SCALE_CAL on connect
- Zero offset is firmware-RAM only; user re-tares each session (deliberate, simple)
- Pump ENA gate on D3 + PUMP_PWM_FULL = 254 are both required for the FG300 motor driver
- RPi port uses single shared `ui/source/` tree + `platform_shim.py` (not a separate RPi fork). Qt's native `QT_SCALE_FACTOR=2` handles 1080p scaling — no per-widget font edits needed.
- RPi Teensy access: udev rule `/etc/udev/rules.d/99-teensy.rules` is mandatory on Bookworm to stop ModemManager from hijacking the port on hotplug.
- Safety manager watchdog is arm-on-first-telemetry: never fires until a real packet has been received, so navigation-without-hardware is silent.
