mklod/silvia-lever/silvia lever PCB 2026-01.png

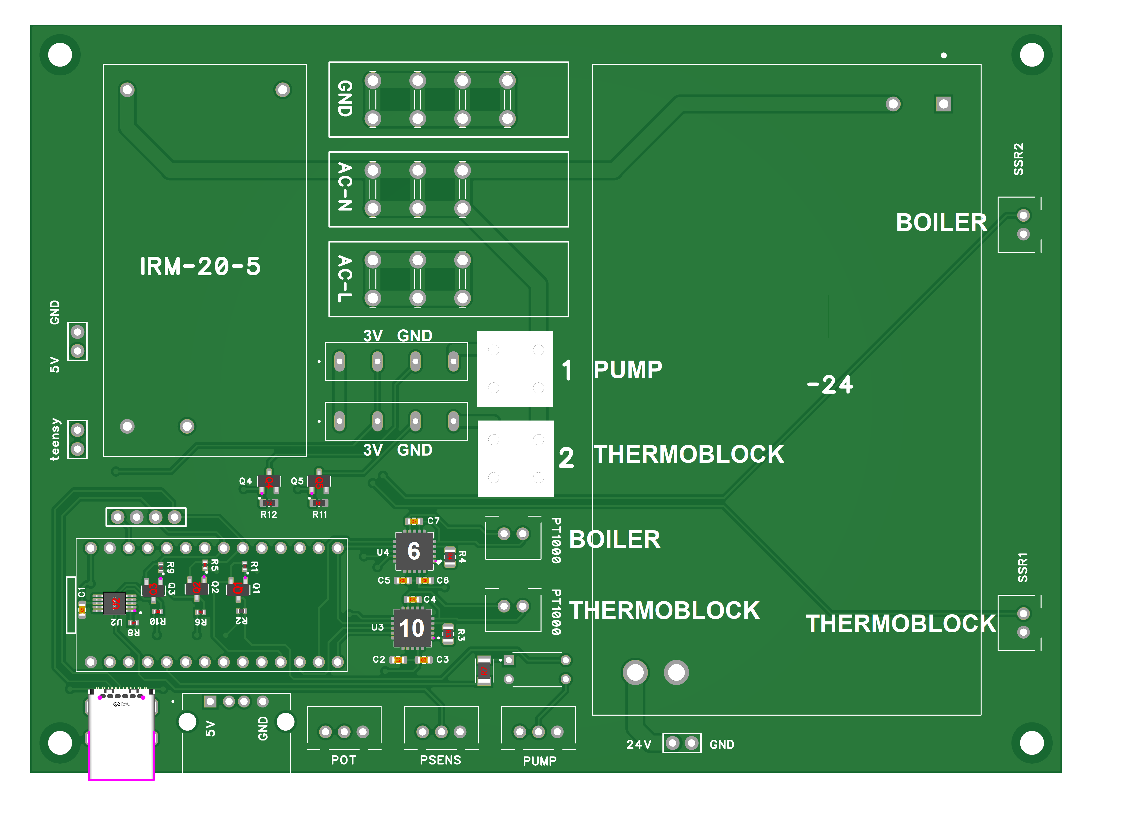
silvia lever PCB 2026-01.png
