mklod/silvia-lever/steam boiler amps.png

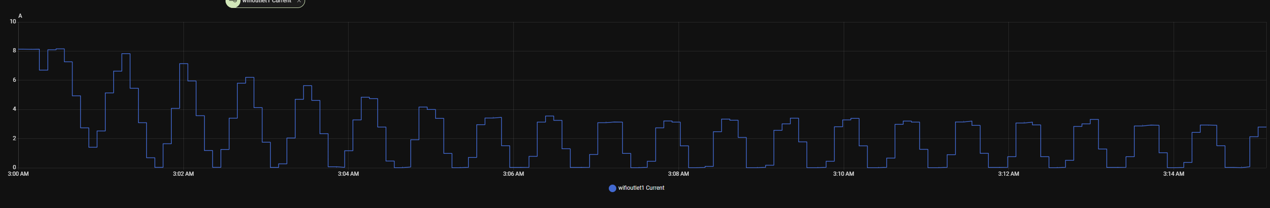
steam boiler amps.png
