mklod/silvia-lever/ui/screens_precision/01_home.png

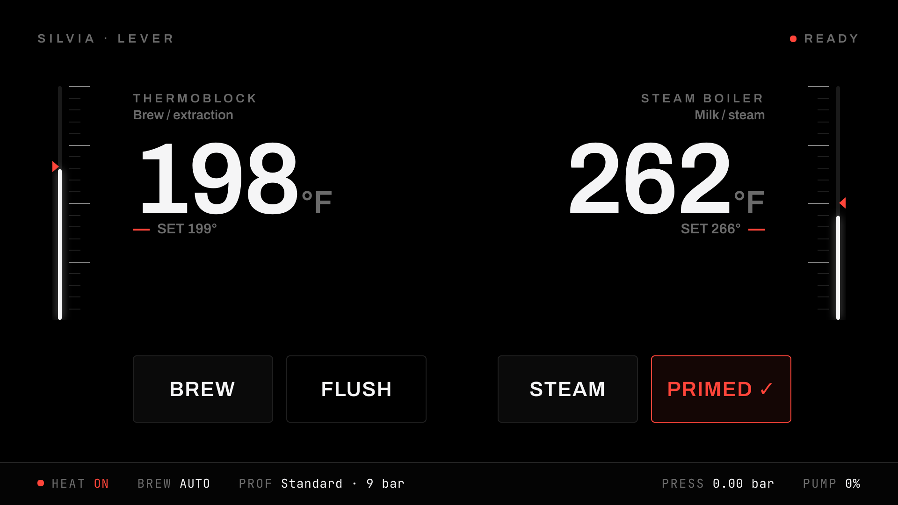
ui/screens_precision/01_home.png
