mklod/silvia-lever/ui/screens_precision/02_settemp.png

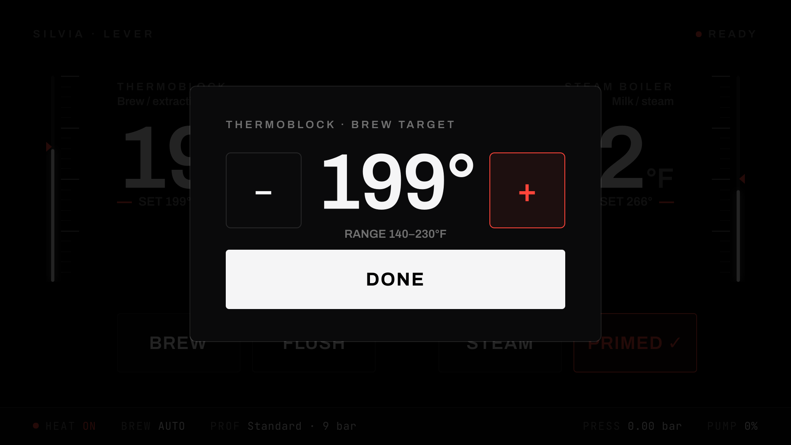
ui/screens_precision/02_settemp.png
