mklod/silvia-lever/ui/screens_precision/03_brew.png

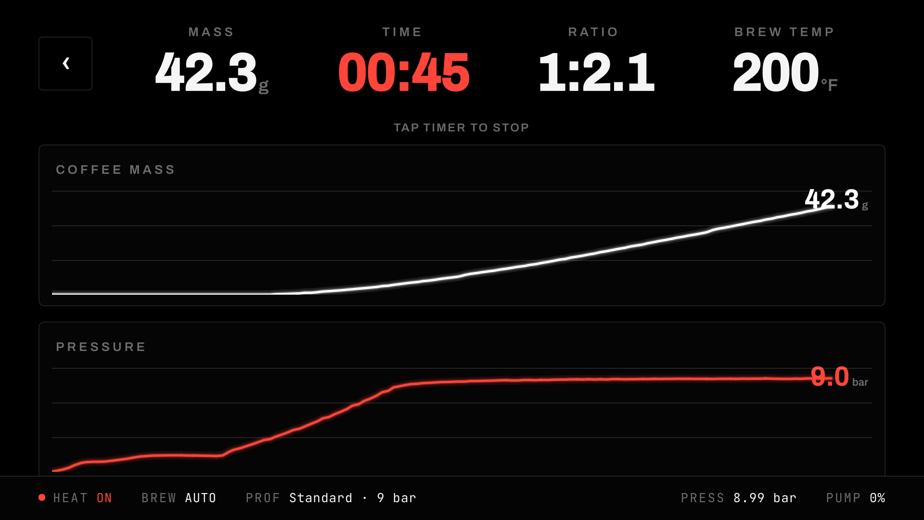
ui/screens_precision/03_brew.png
