mklod/silvia-lever/ui/screens_precision/04_profiles.png

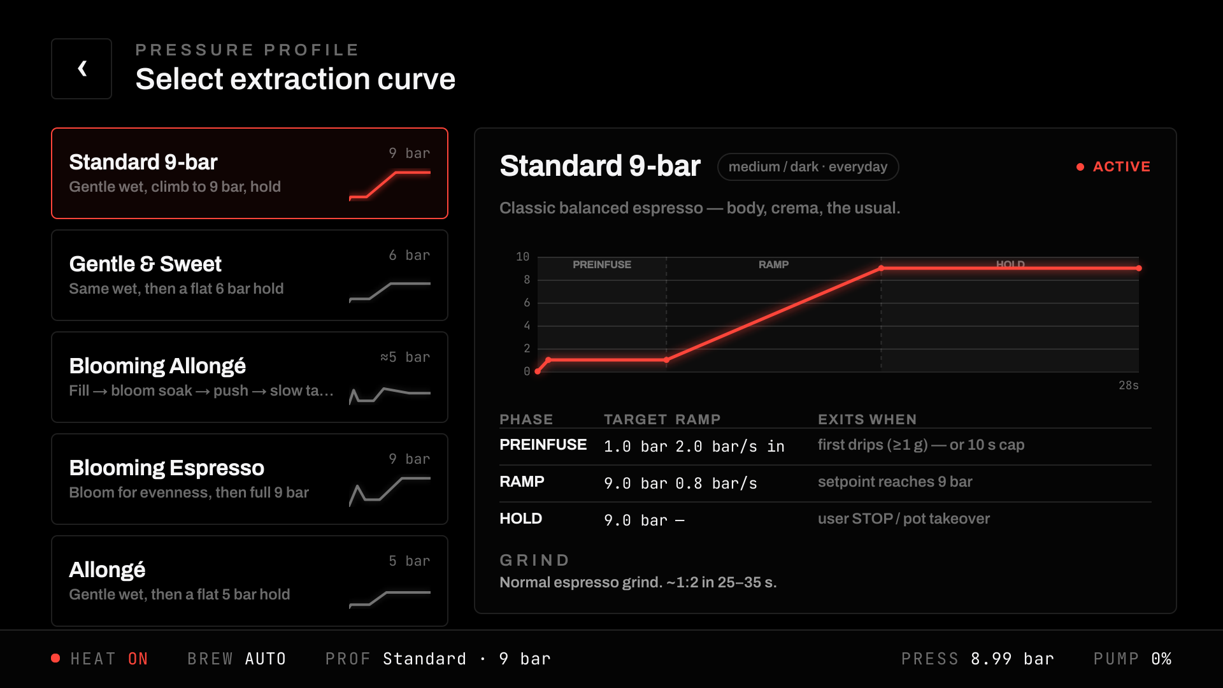
ui/screens_precision/04_profiles.png
