mklod/silvia-lever/ui/screens_precision/06_settings.png

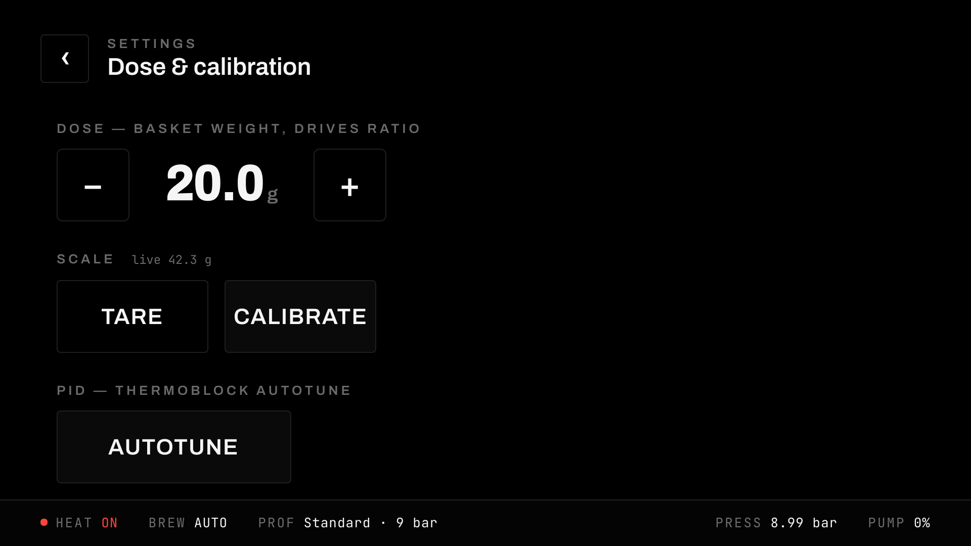
ui/screens_precision/06_settings.png
