mklod/silvia-lever/ui/screenshots/01_home_idle.png

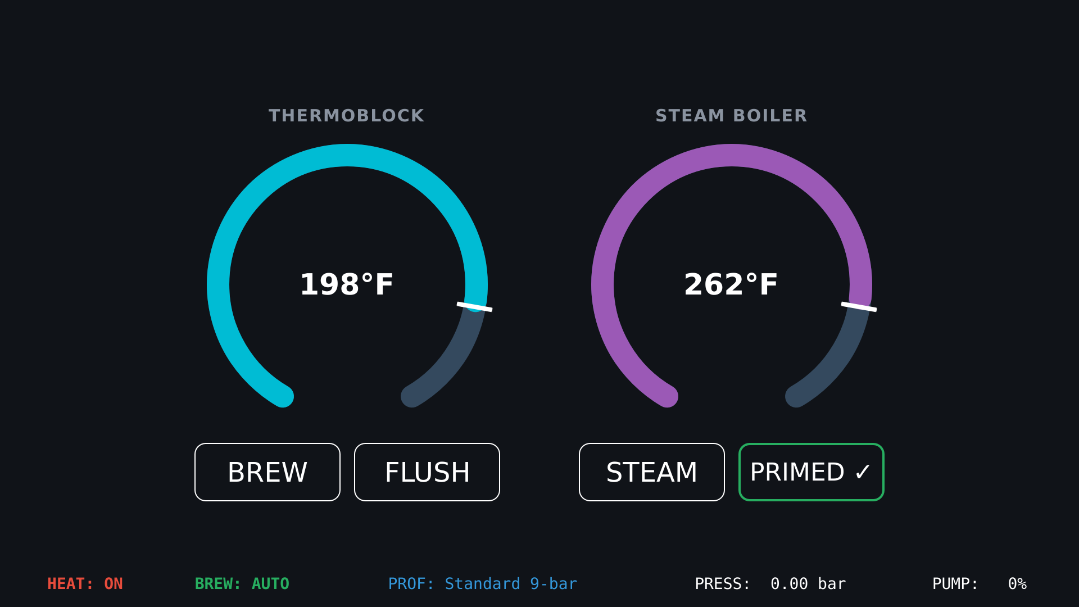
ui/screenshots/01_home_idle.png
