mklod/silvia-lever/ui/screenshots/02_home_setpoint_brew.png

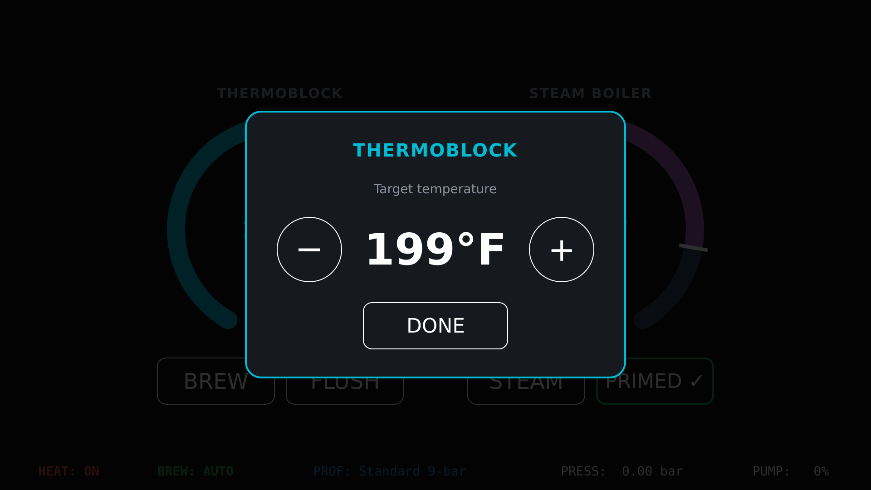
ui/screenshots/02_home_setpoint_brew.png
