mklod/silvia-lever/ui/screenshots/05_brew_ready.png

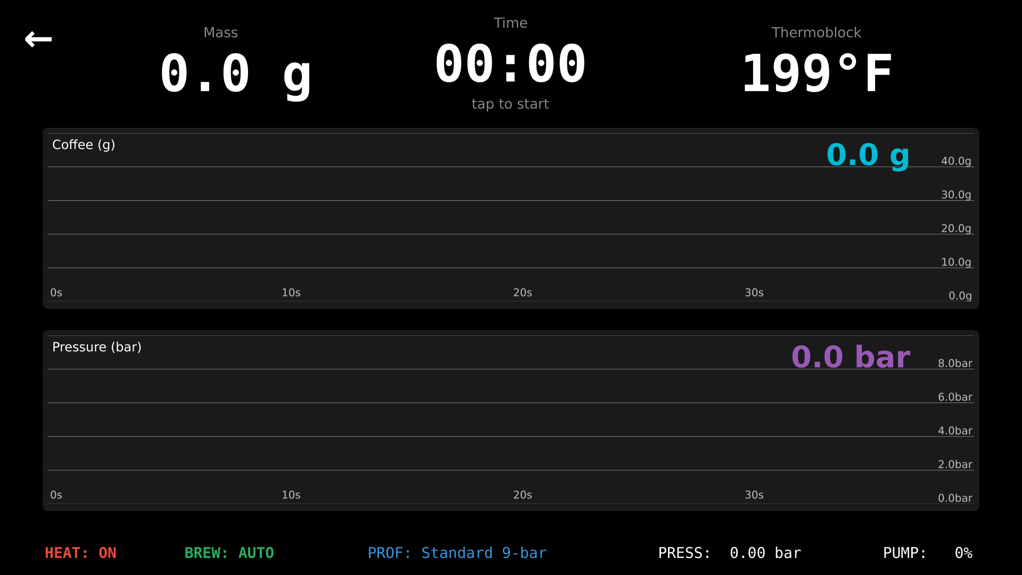
ui/screenshots/05_brew_ready.png
