mklod/silvia-lever/ui/screenshots/06_brew_brewing.png

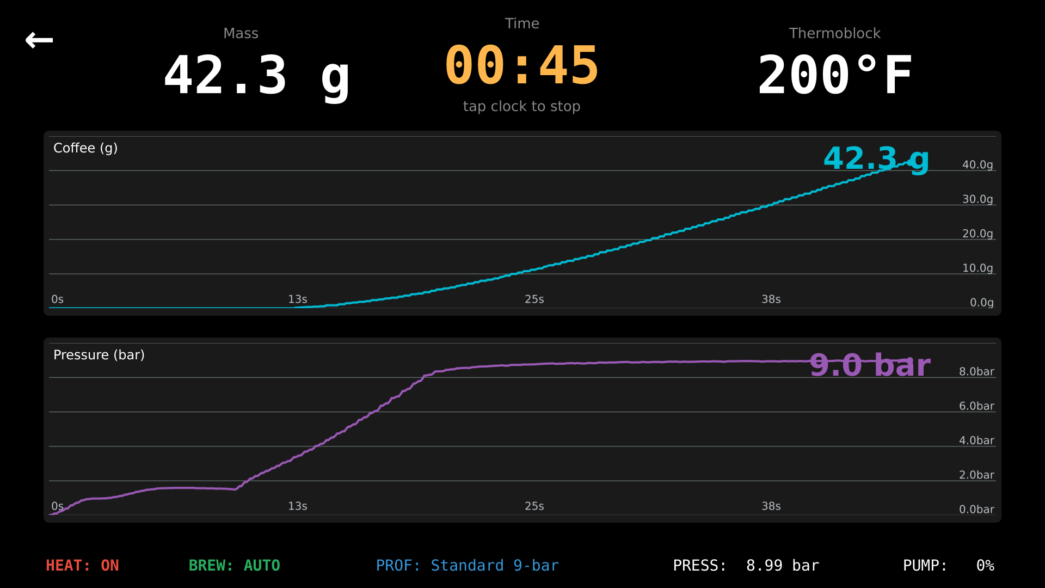
ui/screenshots/06_brew_brewing.png
