mklod/silvia-lever/OG_SILVIA_OPERATION.md

# OG Rancilio Silvia — boiler operation reference

How the **original single-boiler Rancilio Silvia** (with or without PID — PID
changes only temperature *control*, never the plumbing) manages its boiler:
fill, steam, water level, the OPV/expansion valve, reservoir return, and the
classic dry-fire failure. Captured here because our dual-heater build's steam
boiler raises exactly these questions, and the Silvia is the canonical "dumb,
sensorless, three-switch" reference.

Last updated: 2026-05-29. Sources at the end.

---

## 1. The boiler

- Single ~300 ml brass boiler. One chamber, one heating element.
- Ports: **water inlet** (from pump, low), **group-head outlet** (brew path,
  low/side, via the 3-way solenoid), **steam/hot-water takeoff** (top, to the
  wand). Element heats the body.
- **No fill probe, no level sensor, no auto-fill.** Level is managed entirely
  by plumbing physics + user behaviour. (The conductivity **fill probe** people
  mention is on the **Silvia Pro / Pro X** — those are *dual-boiler*. Not the OG.)

## 2. Normal fill — flow-through during brew

The boiler is kept full **by the act of brewing**:

```
reservoir → pump → [OPV tee] → boiler (bottom) → group head → portafilter
```

Cold water pushes in the bottom, hot water leaves the top through the group.
Every shot refreshes and refills the boiler. At idle it simply sits full at
brew temp (~100 °C). There is no separate "fill" step — brewing *is* the fill.

## 3. Steam — the steam space forms itself; you don't have to purge

Water is incompressible, so a 100 %-full boiler can't pressurise as steam until
a vapour space exists. On the Silvia that space **forms on its own**:

- Flip steam → the steam thermostat (or PID steam setpoint) drives the element
  to ~140–150 °C.
- As the water heats and begins to flash, steam collects at the **top** of the
  boiler. The rising pressure pushes the now-excess liquid **back down the inlet
  line → OPV → reservoir**.
- The boiler **self-regulates to a steam headspace**; the displaced water
  returns *quietly to the tank*. This is why, in normal use, you see **no
  gushing dump** and you are **not required to purge the wand** to get steam.

**Purging the wand** (open the steam knob ~5 s, wait for the element, purge
again) is the *official* procedure and it helps — it clears condensate and
speeds steam-space formation — but it is supplementary, not mandatory. The
expansion-return-to-tank happens regardless.

**Steam is a consumable.** While steaming, the water level **drops** (water →
steam → out the wand) and nothing refills it. You get ~30–60 s of steam before
it's getting low.

## 4. Water level + OPV/expansion valve + reservoir return

- **Level:** full after brewing; self-regulates to a steam space when hot;
  drops while steaming. No gauge, no probe — physics + the user.
- **OPV (a.k.a. Expansion / Over-Pressure Valve):** teed on the pump output.
  **Two hoses** — pump-pressurised **in**, overflow **back to the reservoir**
  (the return line literally just sits in the tank). It does *two* jobs:
  1. **Brew over-pressure relief** (~9–10 bar; excess pump pressure → tank).
  2. **Thermal-expansion / steam-space relief** as the boiler heats (excess
     water → tank, leaving the steam headspace).
- So the **return-to-reservoir port is the overfill management.** The boiler
  does *not* stay 100 % full once hot — it sheds the overfill to the tank.
- Note: "a lot of water returning to the tank" is mostly normal, but an
  *excessive* return can also indicate a **worn OPV plunger/spring** letting too
  much through — a known Silvia fault to rule out if it seems extreme.

## 5. The dry-fire failure mode

The classic Silvia kill:

- **Steam too long → boiler empties → element exposed → overheats.**
- Last-resort protection is a **one-shot thermal fuse** taped to the boiler
  under the insulation (small white/clear cylinder, ~1–2"). When it cooks it
  **permanently cuts the heater circuit** — machine won't heat until the fuse is
  replaced (one of the most common Silvia repairs). There's also a high-limit
  safety thermostat.
- **Neither prevents dry-fire** — they only save the element *after* it's gone
  too far. Prevention is entirely on the user: **refill after steaming** (run
  water through, i.e. brew), don't over-steam, and "leave on ≤ 45 min" guidance.

---

## 5b. OPV pressure ↔ steam temp, and headspace sizing (our tuning)

### The OPV setpoint caps the boiler temperature
The boiler can only reach the **saturation temperature of the OPV's relief
pressure**. Set the OPV too low and the boiler boils off through it at ~100 °C
and never makes real steam (exactly the virgin-OPV behavior we saw — dumps at
99 °C). Saturated steam, gauge pressure ↔ temp:

| Boiler temp | OPV must hold ≥ |
|---|---|
| 110 °C | 0.43 bar |
| 120 °C | 1.0 bar |
| **130 °C** | **1.7 bar** |
| 135 °C | 2.1 bar |
| 140 °C | 2.6 bar |

**Tune the OPV to hold the pressure for your target steam temp** (set the relief
a bit above target so it acts as safety, not a routine vent). **Firmware
coupling:** `DEFAULT_STEAM_TEMP` (130 °C) + `STEAM_PREHEAT_OVERSHOOT` (5) = 135 °C
target → needs the OPV to hold ~2.1 bar. If the OPV is tuned lower, lower the
firmware steam setpoint to match its saturation temp — **otherwise the element
runs forever trying to reach a temp the OPV bleeds off.** OPV pressure and steam
setpoint must agree. (A fresh OPV comes mis-set — same tuning the thermoblock
OPV needed, just at lower working pressure.)

### How much headspace a small steam boiler needs — not much
Headspace is **vapour–liquid separation + pressure buffer, not steam storage.**
At ~1.7 bar/130 °C steam density is ~1.5 g/L, so a 75 mL (25 %) headspace holds
only **~0.11 g of steam** — vs ~20–25 g condensed into the milk per latte. All
the steam is made **on demand by boiling**; the headspace just keeps the steam
dry (droplets fall back) and smooths pressure.

For a 0.3 L boiler:

| Headspace | Volume | Verdict |
|---|---|---|
| 25 % (75 % full) | 75 mL | Industry norm (autofill target). Dry steam. |
| 15 % (85 % full) | 45 mL | Fine. |
| 10 % (90 % full) | 30 mL | Workable minimum if the takeoff is well placed. |
| 5 % (95 % full) | 15 mL | Too tight — water carryover/spitting, droopy pressure. |

Our side-port sits **very near the top → ~5–10 % headspace** — borderline but
probably functional for small milk volumes; expect wetter steam / bigger
pressure dip than a 25 % boiler. If steam is spitty, drop the water line a touch.

What sets what: **element power → steam rate; headspace + takeoff → steam
dryness; usable water above the element → drinks per fill.** A 0.3 L boiler with
~⅓ usable ≈ **~100 g steam ≈ 4–5 lattes per fill** before a refill — so
occasional top-ups, not per-drink.

---

## 5c. Vacuum breaker (anti-vacuum valve)

The Silvia **Pro** steam boiler has *two* valves: a **safety valve / OPV
(~2 bar)** and a separate **anti-vacuum valve (vacuum breaker)**. The classic OG
Silvia has **no** vacuum breaker — which is *why* you manually purge the wand.
The vacuum breaker is a one-way valve that **opens to admit air when boiler
pressure falls below atmospheric, and seals once steam pressure builds.** Two
jobs from that one behavior:

1. **Cool-down — prevents vacuum & suck-back.** Off/cooling, the boiler is full
   of steam; condensing steam is a ~1600:1 volume collapse → pressure craters
   *below atmospheric* → vacuum. The breaker admits air to equalize, preventing
   suck-back and seal/boiler stress.
2. **Heat-up — auto-purges air for dry steam.** Cold, the valve is open; as the
   boiler warms, trapped headspace air vents out; once steam pressure builds it
   seals. So the headspace fills with *clean steam*, not a steam/air mix — **the
   automatic version of the manual ~1 s wand purge.**

### For our build
- **Suck-back of reservoir water is largely blocked by our 3-way valves.** V1
  gates the pump→boiler path; de-energised (idle/cool-down) the boiler is valved
  off from the reservoir, so a cool-down vacuum can't siphon tank water back in
  the way an OG Silvia's single-pump/open path could — *unless a valve is left
  in the wrong state.* So suck-back is a lesser concern for us than on a stock
  Silvia.
- **What the vacuum breaker still buys us:** (a) prevents the sealed-boiler
  **vacuum itself** on cool-down (repeated vacuum cycling stresses seals / can
  draw air past gaskets / pull the OPV-return water back), and (b) **automatic
  dry steam** — no manual wand-purge ritual. So it's worth adding even with our
  valves: more a **seal-stress safety + QoL** item than a suck-back fix.
- Priority: the **fill probe** is a nice-to-have future add; the **vacuum
  breaker** is the more clearly-warranted addition for seal longevity + steam
  quality.

## 5d. Steam-boiler safety review (current state)

Ranked, for a custom build with a hot pressurized steam vessel.

**First, the pressure-vessel reality check (this is NOT a "bomb" scenario).**
The boiler is a **repurposed OG Silvia boiler, which routinely sees 9–12 bar on
the brew side** — so its body and seals are validated *far* above any steam
pressure we run (2–3 bar). At these pressures, brass is nowhere near yield;
failure modes are **slow weeps at a seal/joint**, not instantaneous rupture. The
hazard from a failure is a **scald** (hot water/steam leak you'd notice), not an
explosion. So OPV *precision* is not a safety necessity here: a **rough field
adjustment** that gives good steam without needless blow-off at working temp is
fine — no gauge, no one-off plumbing required. (Setting an OPV precisely would
mean teeing in a gauge then removing it, which doesn't fit the assembly — not
worth it for a relief whose exact crack pressure isn't safety-critical given the
9-bar-rated vessel + the firmware/fuse temp caps.) Good practice is only that
the OPV still **relieves** if pushed (isn't torqued fully shut) — and even a
shut OPV wouldn't be catastrophic here, because `MAX_STEAM_TEMP` (160 °C) and the
thermal fuse cap temperature, and the vessel holds 9 bar regardless.

Real residual risks, ranked:

1. **Dry-fire / element burnout — the actual #1.** Steam-only boiler isn't
   refilled by brewing → can run dry → element burnout (a dry glowing element is
   also a fire risk the thermal fuse only *partially* catches — it watches body
   temp, lags the element). Neither fuse nor PT1000 prevents the burnout itself.
   Mitigated today by careful use + watching the level; the **level probe** is
   the real fix (§ LEVEL_SENSING.md). This — not over-pressure — is the genuine
   hazard of the current state.
2. **Firmware hang → runaway heat.** If the Teensy hung with the steam SSR on,
   previously only the mechanical OPV + thermal fuse stopped it. **CLOSED
   2026-06-01:** a hardware watchdog (Teensy 4.0 WDT, 2 s, fed every `loop()`)
   hard-resets the MCU on a hang → SSR pins LOW, `boilerPrimed` clears (no heat
   until re-prime).
3. **Scald / hot-water routing.** Route the OPV/expansion dump safely (not at
   the user). Returning ~100 °C water to a **plastic reservoir** can warp it —
   use a heat-tolerant return or let it cool in the line.
4. **Vacuum on cool-down** — seal stress; addressed by the vacuum breaker (5c).
   (Suck-back largely blocked by our 3-way valves — see 5c.)
5. **Electrical.** Mains element in a water boiler — solid earth bond,
   element-seal integrity, ideally a **GFCI/RCD** on the supply. The boiler body
   is also the conductivity-probe ground when fitted — bond it well.

Backstops in place: rough-set OPV (mechanical relief, relieves if pushed),
hardware thermal fuse (fire), firmware `MAX_STEAM_TEMP` 160 °C cut, **hardware
watchdog** (hang). The one real gap left to close: **level sensing** (#1) to
prevent dry-fire element burnout. Over-pressure is well-covered by the 9-bar
vessel + temp caps; precise OPV setting is unnecessary.

---

## 6. Our build — repurposed OG Silvia boiler, steam-only

**Our steam boiler IS an OG Silvia boiler**, reused, repurposed for steam only.
The OPV sits in the same position as on the OG. So §1–4 above apply *directly*:
the overfill self-management (heat → steam space forms → excess returns to
reservoir via the OPV) is the same mechanism. The bench "massive hot-water dump
at ~99 °C" is most likely that normal expansion/steam-space shedding — **assuming
our OPV return is actually plumbed to the reservoir** (verify; if it dumps to
the tray instead, re-plumb it to the tank like the OG). The abort at 99 °C was
probably premature — it was forming the steam space.

**The one thing that's different and dangerous:** on the OG, the boiler is
**refilled by brewing**. Ours is **steam-only — nothing refills it.** Every
steam depletes it and nothing tops it up. So the dry-fire risk is *higher* than
a stock Silvia, not lower.

### Critical: neither the thermal fuse NOR the thermocouple prevents element burnout

This is the crux, and it's why dry-fire is the real hazard here:

- **Thermal fuse (we have one):** it senses the **boiler body** temp and is
  slow. When the boiler runs dry, the **element surface** temp spikes far faster
  than the body the fuse is taped to. By the time the body heats enough to blow
  the fuse, **the element is often already burned out.** The fuse is a
  *fire/catastrophe backstop, not element protection.* (This is a well-known OG
  Silvia weakness — people burn out elements *with* the fuse intact.)
- **Thermocouple / PT1000 + firmware `MAX_STEAM_TEMP` cut:** same failure. The
  PT1000 reads **body/water** temp, not element-surface temp. Dry, the
  element→body heat transfer collapses, so the PT1000 **lags badly or reads
  plausibly low while the element cooks.** By the time it hits 160 °C the
  element may already be gone. The firmware temp cut is *also* a backstop, not
  burnout prevention.

**Conclusion: the only thing that actually prevents element burnout is not
letting the boiler run dry — i.e., active water-level management.** Temperature
sensing (fuse or PT1000) is structurally too slow/indirect because it watches
the wrong thing (body temp) with the wrong timing (after the element is already
overheating).

> Context: the donor machine *did* burn out an element years ago — almost
> certainly long successive steams with no pump refill (the classic dry-fire).
> It's a characterized, understood risk, not a present blocker: every bench test
> starts with a **full** boiler and we watch the level. The proper fix (a level
> probe) is queued, not gating.

### The fix — water level sensing (full design in `LEVEL_SENSING.md`)

The real solution is a **conductivity level probe** + a hard element interlock
("element only fires when water is confirmed above the probe; dry → cut +
pump-refill"). This is what the Silvia **Pro** added to this same boiler
lineage. Options, circuit, parts list, and the firmware-hook plan live in
**`LEVEL_SENSING.md`**.

**Sensorless interim** (until a probe is fitted): because the OPV returns
overfill to the reservoir, **you can't overfill by pumping** — so proactively
pulse the pump to top up (keyed to steam usage), **err full**, and let the OPV
shed the excess. Trade-off: cold top-ups drop boiler temp (reheat wait). Always
err full — overfill is self-correcting and harmless; underfill burns the
element. Keep `MAX_STEAM_TEMP` + the thermal fuse as backstops, knowing they
won't save the element on their own.

---

## Sources
- Espresso Parts — Silvia Expansion/OPV (two-hose, reservoir overflow):
  <https://www.espressoparts.com/products/rancilio-silvia-expansion-over-pressure-valve-opv-complete>
- Home-Barista — Silvia steam and (a lot of) water returning to tank:
  <https://www.home-barista.com/repairs/rancilio-silvia-steam-and-lot-water-returning-to-water-tank-t86476.html>
- CoffeeSnobs — Silvia steam returned via hose to tank:
  <https://coffeesnobs.com.au/forum/equipment/brewing-equipment-midrange-500-1500/47777-rancilio-silvia-steam-is-returned-via-hose-back-to-tank>
- Clive Coffee — Silvia user manual (steam: purge to make room for steam):
  <https://support.clivecoffee.com/en/rancilio-silvia-user-manual>
- Whole Latte Love — Silvia not heating (thermal fuse / dry-fire):
  <https://support.wholelattelove.com/hc/en-us/articles/4403765105427-Rancilio-Silvia-Not-Heating-or-Powering-On>
- Espresso Planet — reset Silvia thermal fuse:
  <https://www.espressoplanet.com/blogs/articles/how-to-reset-rancilio-silvia-thermal-fuse>
- Clive Coffee — Silvia **Pro X** fill probe (dual-boiler only, for contrast):
  <https://support.clivecoffee.com/en/rancilio-silvia-pro-x-cleaning-the-fill-probe>
