mklod/silvia-lever/silvia cold test.png

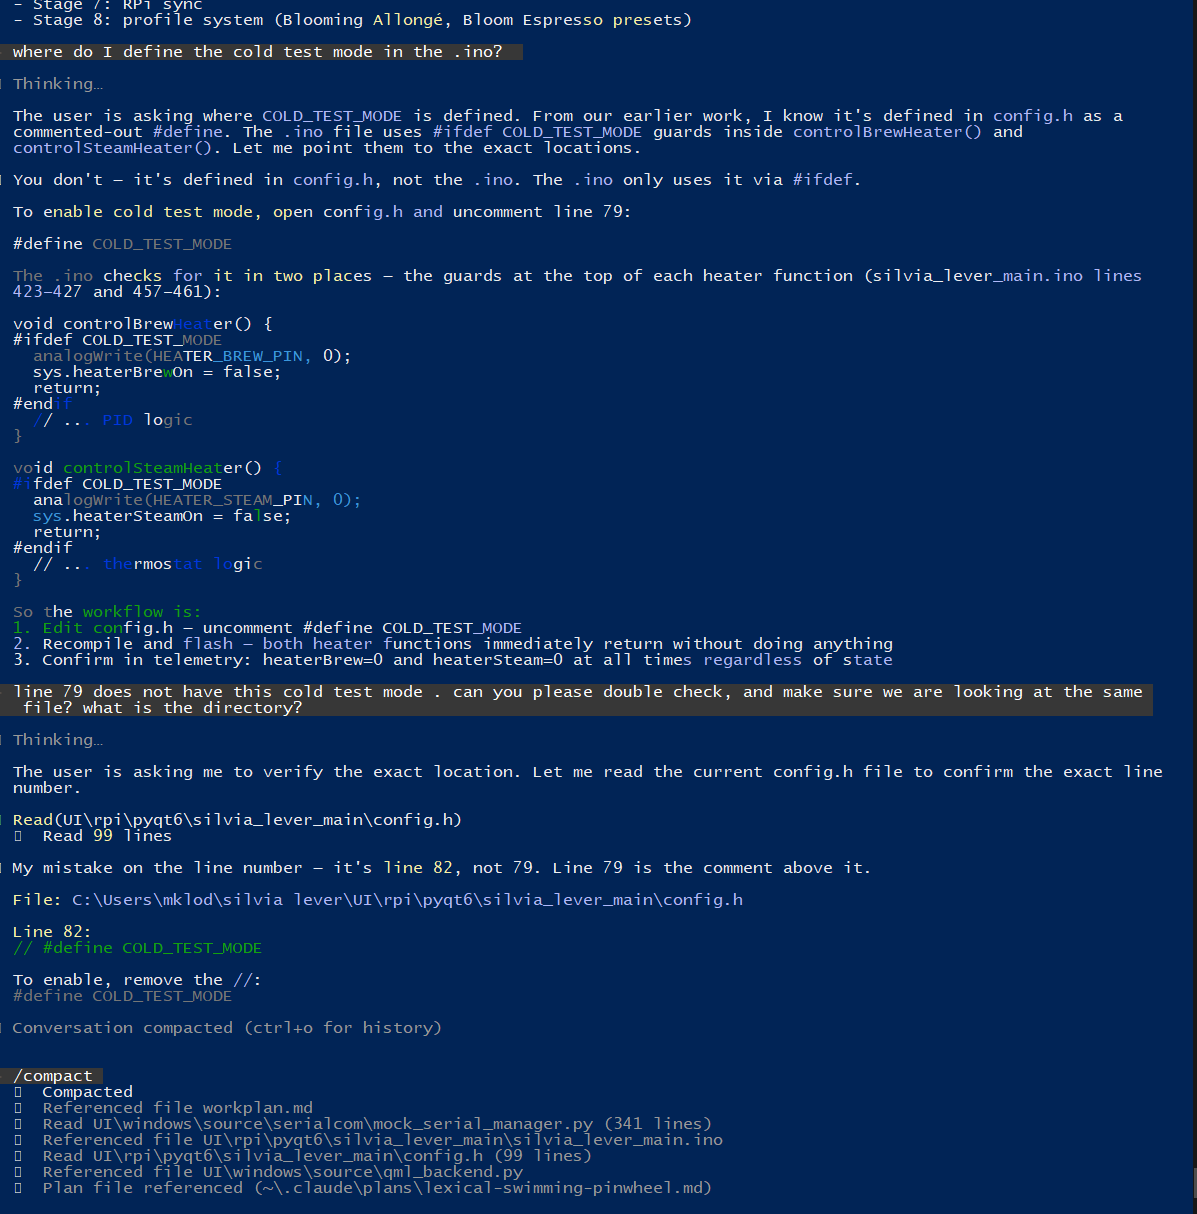
silvia cold test.png
