mklod/silvia-lever/ui/screens_precision/05_history.png

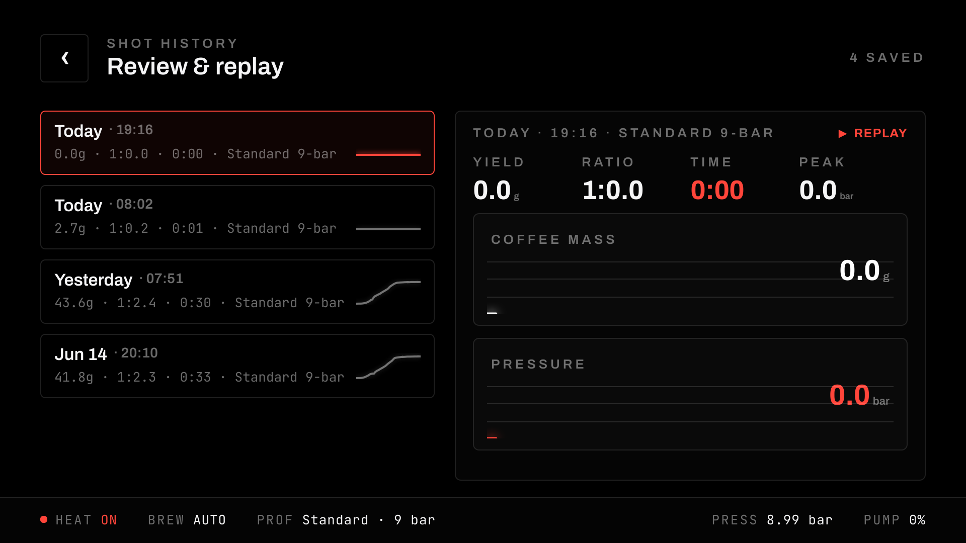
ui/screens_precision/05_history.png
