mklod/silvia-lever/firmware/silvia_lever_main/config.h

#define CONFIG_H
#define POT_PIN         A0   // Potentiometer for manual pump speed control
#define PUMP_PWM_PIN     9   // PWM output to pump motor driver
#define PUMP_ENA_PIN     3   // Optoisolator enable — HIGH to pass PWM to motor driver
#define HEATER_BREW_PIN  15  // Thermoblock SSR (brew / PID) — pin 15 IS PWM-capable
#define HEATER_STEAM_PIN 16  // Steam boiler SSR (on/off thermostat). NOTE: Teensy
#define VALVE_PUMP_PIN         21  // VALVE1 — routes pump to thermoblock (LOW) vs boiler (HIGH)
#define VALVE_THERMOBLOCK_PIN  20  // VALVE2 — routes thermoblock outlet to drain (LOW) vs portafilter (HIGH)
#define PT1000_MOSI     11
#define PT1000_MISO     12
#define PT1000_CLK      13
#define PT1000_BREW_CS  10   // Thermoblock PT1000 chip-select
#define PT1000_STEAM_CS  6   // Steam boiler PT1000 chip-select
#define RREF     4300.0   // Reference resistor (Ω) — adjust to your board
#define RNOMINAL 1000.0   // PT1000 nominal resistance at 0°C
#define I2C_SDA         18
#define I2C_SCL         19
#define ADS1115_ADDRESS 0x48
#define V_ZERO  0.0    // Zero-pressure voltage — overwritten during setup()
#define V_MAX   4.5    // Full-scale voltage (V)
#define P_MIN   0.0    // Minimum pressure (bar)
#define P_MAX   16.0   // Maximum pressure (bar)
#define NAU7802_ADDRESS 0x2A   // Fixed I2C address of NAU7802
#define SCALE_CALIB     420.0  // Placeholder; update after calibration
#define DEFAULT_BREW_TEMP   93.0   // Thermoblock target (°C)
#define DEFAULT_STEAM_TEMP 121.11  // Steam boiler target (°C) = 250 °F
#define PID_KP   8.0   // Proportional gain
#define PID_KI   0.5   // Integral gain
#define PID_KD   5.0   // Derivative gain
#define STEAM_HYSTERESIS  2.0   // Switch off when within 2°C of target; on when 2°C below
#define STEAM_PREHEAT_OVERSHOOT 5.0
#define PRIME_SAFETY_TIMEOUT_MS  120000   // 2 minutes hard abort
#define HEATER_PWM_FULL  255
#define PUMP_PWM_FULL  254
#define PUMP_PWM_QUIET 127
#define POT_ZERO_DEADBAND 10
#define PREINFUSE_TARGET_BAR     1.0f   // bar setpoint — gentle wetting
#define PREINFUSE_END_WEIGHT_G   1.0f   // exit when scale ≥ this (first drips), OR
#define PREINFUSE_MAX_MS         10000  // hard ceiling on PREINFUSE duration. Prevents
#define PREINFUSE_BASE_PWM       60     // feed-forward — ~minimum to start flow
#define PREINFUSE_KP             30.0f
#define PREINFUSE_KI             5.0f
#define PREINFUSE_KD             0.0f
#define PREINFUSE_MIN_PWM        30
#define PREINFUSE_MAX_PWM        180
#define BREW_TARGET_BAR          9.0f   // final OPV-limited line pressure
#define BREW_SLEW_RATE           0.8f   // bar/sec — 1.0→9.0 in ~10 s. Lower
#define MANUAL_TAKEOVER_DELTA    25
#define BREW_BASE_PWM            80     // small feed-forward; integrator does the work
#define BREW_KP                  20.0f
#define BREW_KI                  6.0f
#define BREW_KD                  10.0f  // small D-term — slow setpoint, modest dP/dt
#define BREW_MIN_PWM             30
#define BREW_MAX_PWM             254
#define PUMP_D_FILTER_TAU        0.2f
#define PUMP_PI_INTEGRAL_MAX     50.0f
#define TEMP_READ_INTERVAL      500   // Both PT1000s read every 500 ms
#define PRESSURE_READ_INTERVAL  130   // ADS1115 pressure read interval
#define TELEMETRY_INTERVAL      100   // DATA: packet send interval
#define SERIAL_BAUD 115200
#define MAX_BREW_TEMP   105.0   // Firmware hard-limit for thermoblock
#define MAX_STEAM_TEMP  160.0   // Firmware hard-limit for steam boiler
#define MIN_TEMP         10.0   // Minimum plausible temperature (fault detect)
