mklod/silvia-lever/firmware/silvia_lever_main/silvia_lever_main.ino

// Last modified: 2026-06-01--1730
/*
 * Silvia Lever Coffee Machine Controller
 * Hardware revision: dual PT1000 (MAX31865), dual SSR heaters,
 * dual 3-way valves, NAU7802 scale, ADS1115 pressure sensor, single pump.
 *
 * Serial telemetry (every TELEMETRY_INTERVAL ms):
 *   DATA:state,brewTemp,steamTemp,pressure,weight,pump%,valveThermoblock,valvePump,heaterBrew,heaterSteam,brewTimer,scalesTared,heatersEnabled,brewPhase,boilerPrimed,boilerPreheatComplete,autoBrewMode
 *
 * Commands accepted from PC:
 *   SET_TEMP BREW <°C>     SET_TEMP STEAM <°C>
 *   START_BREW             START_STEAM     START_FLUSH
 *   BEGIN_BREW / BREW_NOW  BEGIN_STEAM
 *   STOP                   ABORT
 *   TARE_SCALES            CAL_SCALE <grams>    SET_SCALE_CAL <factor>
 *   GET_STATUS             PING
 */

#include <SPI.h>
#include <Adafruit_MAX31865.h>
#include <ADS1115_WE.h>
#include <Wire.h>
#include <SparkFun_Qwiic_Scale_NAU7802_Arduino_Library.h>
#include <Watchdog_t4.h>   // tonton81 WDT_T4 — github.com/tonton81/WDT_T4
                           // (install into Arduino/libraries/; not in registry)
#include "config.h"

// Hardware watchdog (Teensy 4.0 WDT). Fed every loop(); if the main loop ever
// stalls (hang, lockup) longer than WDT_TIMEOUT_S it hard-resets the MCU. On
// reset the SSR pins go high-impedance then setup() drives them LOW, and
// boilerPrimed (RAM) clears → no heating resumes until re-primed. This is the
// last-line firmware safety against a runaway-heat hang with the steam SSR on
// (mechanical OPV + thermal fuse remain the non-firmware backstops). See
// OG_SILVIA_OPERATION.md §5d.
WDT_T4<WDT1> wdt;
const uint8_t WDT_TIMEOUT_S = 2;   // generous vs the ms-scale main loop

// ─── Hardware objects ─────────────────────────────────────────────────────────
// Two MAX31865 on shared SPI bus, each with its own CS pin
Adafruit_MAX31865 thermoBrew  = Adafruit_MAX31865(PT1000_BREW_CS);
Adafruit_MAX31865 thermoSteam = Adafruit_MAX31865(PT1000_STEAM_CS);

ADS1115_WE adc = ADS1115_WE(ADS1115_ADDRESS);
NAU7802 scale;

// ─── System state ─────────────────────────────────────────────────────────────
enum SystemState {
  STATE_IDLE,
  STATE_PRIMING_BREW,     // Filling thermoblock before heating
  STATE_HEATING_BREW,
  STATE_PRIMING_STEAM,    // Filling boiler before heating
  STATE_HEATING_STEAM,
  STATE_BREWING,
  STATE_STEAMING,
  STATE_FLUSHING
};

// Telemetry sub-state inside STATE_BREWING. With the profile engine these
// are derived from the active segment (see runBrewSegmentEngine): segment 0
// reports PREINFUSE, a slewing setpoint reports RAMP, a settled setpoint
// reports HOLD, manual pot control reports EXTRACT.
enum BrewPhase {
  BREW_PHASE_PREINFUSE = 0,
  BREW_PHASE_RAMP      = 1,
  BREW_PHASE_HOLD      = 2,
  BREW_PHASE_EXTRACT   = 3     // pot-controlled manual (auto-off, or takeover)
};

// ─── Brew profile engine (Stage 1) ────────────────────────────────────────────
// A profile is an ordered list of segments. Each segment slews the pressure
// setpoint toward targetBar at slewRate, runs the shared PI(D) controller with
// its gain set, and advances to the next segment when any non-zero exit
// criterion fires (first to trigger wins). The final segment ignores its exit
// criteria and runs until the user STOPs. See PROFILES.md §3.
enum PumpGains { GAINS_PREINFUSE = 0, GAINS_BREW = 1 };

struct BrewSegment {
  float     targetBar;        // pressure setpoint this segment slews toward
  float     slewRate;         // bar/sec (magnitude; direction is auto)
  PumpGains gains;            // which PI(D) gain set pumpClosedLoop uses
  float     exitWeightG;      // advance when sys.weight   >= this  (0 = ignore)
  uint32_t  exitDurationMs;   // advance when seg elapsed  >= this  (0 = ignore)
  float     exitPressureBar;  // advance when sys.pressure >= this  (0 = ignore)
};

struct BrewProfile {
  const char*        name;
  uint8_t            nSegments;
  const BrewSegment* segments;
};

// Profile 0 — Standard 9-bar. Faithful re-expression of the Stage-0 auto
// sequence: gentle 1 bar preinfuse (exit on 1 g OR 10 s), then slew to 9 bar
// and hold until STOP.
const BrewSegment SEG_STANDARD[] = {
  { PREINFUSE_TARGET_BAR, 2.0f, GAINS_PREINFUSE,
    PREINFUSE_END_WEIGHT_G, PREINFUSE_MAX_MS, 0.0f },
  { BREW_TARGET_BAR, BREW_SLEW_RATE, GAINS_BREW, 0.0f, 0, 0.0f },
};

// Profile 1 — Gentle & Sweet. Light-roast starter (PROFILES.md §3.4): same
// gentle preinfuse, then a flat 6 bar hold. Lower pressure = less channeling
// on light roasts, which have weaker puck integrity.
const BrewSegment SEG_GENTLE_SWEET[] = {
  { PREINFUSE_TARGET_BAR, 2.0f, GAINS_PREINFUSE,
    PREINFUSE_END_WEIGHT_G, PREINFUSE_MAX_MS, 0.0f },
  { 6.0f, BREW_SLEW_RATE, GAINS_BREW, 0.0f, 0, 0.0f },
};

// Profile 2 — Blooming Allongé (PROFILES.md §3.3). For ultra-light / nordic
// filter roasts — max flavour clarity, surfaces fruit/floral notes. Fast
// fill → bloom (soak at 1 bar) → percolate to 6 bar → slow declining taper
// (mimics the natural taper of a flow-controlled shot on our pressure rig).
// Fields: { targetBar, slewRate, gains, exitWeightG, exitDurationMs, exitPressureBar }
const BrewSegment SEG_BLOOMING_ALLONGE[] = {
  { 4.5f, 2.0f,  GAINS_BREW,      0.0f, 4000,  4.0f },  // FILL
  { 1.0f, 1.5f,  GAINS_PREINFUSE, 4.0f, 10000, 0.0f },  // BLOOM / soak
  { 6.0f, 0.8f,  GAINS_BREW,      0.0f, 5000,  5.5f },  // PERCOLATE
  { 3.5f, 0.12f, GAINS_BREW,      0.0f, 0,     0.0f },  // DECLINE → STOP
};

// Profile 3 — Blooming Espresso (PROFILES.md §3.4). Light-to-medium: fill,
// bloom-drop to 2 bar, ramp to 9 bar and hold. More body/blending than the
// allongé while keeping a bloom for clarity.
const BrewSegment SEG_BLOOMING_ESPRESSO[] = {
  { 6.5f, 2.0f, GAINS_BREW,      0.0f, 4000, 6.0f },    // FILL
  { 2.0f, 1.5f, GAINS_PREINFUSE, 4.0f, 8000, 0.0f },    // BLOOM
  { 9.0f, BREW_SLEW_RATE, GAINS_BREW, 0.0f, 0, 0.0f },  // RAMP → 9 → hold
};

// Profile 4 — Allongé (PROFILES.md §3.4). Simple light-roast profile: gentle
// preinfuse then a flat ~5 bar hold. Coarser grind, longer ratio (1:3-1:5),
// high clarity. The fallback when blooming profiles channel.
const BrewSegment SEG_ALLONGE[] = {
  { PREINFUSE_TARGET_BAR, 2.0f, GAINS_PREINFUSE,
    PREINFUSE_END_WEIGHT_G, PREINFUSE_MAX_MS, 0.0f },
  { 5.0f, BREW_SLEW_RATE, GAINS_BREW, 0.0f, 0, 0.0f },
};

const BrewProfile BREW_PROFILES[] = {
  { "Standard 9-bar",    2, SEG_STANDARD },
  { "Gentle & Sweet",    2, SEG_GENTLE_SWEET },
  { "Blooming Allonge",  4, SEG_BLOOMING_ALLONGE },
  { "Blooming Espresso", 3, SEG_BLOOMING_ESPRESSO },
  { "Allonge",           2, SEG_ALLONGE },
};
const uint8_t N_BREW_PROFILES = sizeof(BREW_PROFILES) / sizeof(BREW_PROFILES[0]);

struct SystemData {
  SystemState state = STATE_IDLE;

  // Setpoints
  float brewTemp  = DEFAULT_BREW_TEMP;
  float steamTemp = DEFAULT_STEAM_TEMP;

  // Actual sensor readings
  float brewTempActual  = 0.0;
  float steamTempActual = 0.0;
  float pressure        = 0.0;
  float weight          = 0.0;

  // Actuator state
  int  pumpPower           = 0;
  bool valveThermoblockOpen = false;  // VALVE2: thermoblock outlet → group head when true
  bool valvePumpOpen        = false;  // VALVE1: pump → thermoblock when true, → boiler when false
  bool heaterBrewOn         = false;
  bool heaterSteamOn        = false;
  // Runtime master switch for both SSRs. Default OFF so power-on never
  // starts heating; UI explicitly enables it before a hot test.
  bool heatersEnabled       = true;   // default ON — machine heats on boot; HEAT toggle kills it
  // Boiler prime flag + Stage-9 staging (HEATING.md §5). preheatComplete
  // latches once the boiler first reaches its target, releasing the
  // thermoblock from cold-start inhibition.
  //
  // 2026-06-01: boilerPrimed now defaults TRUE — auto-heat from cold boot
  // without the manual PRIME step (user request; accepted dry-fire risk —
  // minimal with a conscientious user keeping the boiler watered, normal
  // single-shot/single-steam workflow). The PRIME button still works to fill
  // the boiler manually. Remaining dry-fire backstops: MAX_STEAM_TEMP cut +
  // thermal fuse + watchdog. Real fix pending: level probe (LEVEL_SENSING.md).
  bool boilerPrimed         = true;
  bool boilerPreheatComplete = false;

  // Brew timer (millis() timestamp of brew start; 0 = not brewing)
  unsigned long brewTimer = 0;

  // Auto pre-infuse sub-state
  BrewPhase    brewPhase     = BREW_PHASE_EXTRACT;  // default = pure manual when not actively in a managed brew
  // Stage 0: single PI(D) loop runs the entire post-preinfuse brew. Setpoint
  // slowly slews from PREINFUSE_TARGET_BAR up to BREW_TARGET_BAR at
  // BREW_SLEW_RATE, then holds. Integrator carries from PREINFUSE through
  // the whole brew — naturally adapts to whatever PWM the puck needs.
  float        brewSetpoint  = PREINFUSE_TARGET_BAR;  // current slewed target
  unsigned long brewSlewLastMs = 0;
  // PI controller state — shared by PREINFUSE and the post-preinfuse loop.
  float        pumpIntegral  = 0.0f;
  unsigned long pumpPiLastMs = 0;
  int          lastPumpPwm   = 0;   // last commanded PWM (telemetry / debug)
  // D-term state — derivative-on-measurement of pressure, low-pass filtered.
  float        pumpDLastMeas = 0.0f;
  float        pumpDFiltered = 0.0f;
  // Manual-takeover bumpless handoff: pot value at brew start (defines the
  // "rest" position) and the PWM offset captured at the moment of takeover.
  // In EXTRACT phase, PWM = constrain(potValue + handoverOffset, 0, FULL).
  int          potAtBrewStart = 0;
  int          handoverOffset = 0;
  // Auto vs manual brew mode. true = run the active profile (segment engine)
  // with manual-takeover by pot rotation. false = brew enters EXTRACT
  // immediately, pot drives PWM directly from t=0. Toggled via SET_AUTO_MODE.
  bool         autoBrewMode  = true;    // default AUTO (run active profile) — see SET_AUTO_MODE
  // Brew profile engine state.
  uint8_t       activeProfile  = 0;   // index into BREW_PROFILES[]
  uint8_t       segmentIndex   = 0;   // current segment within the profile
  unsigned long segmentStartMs = 0;   // millis() at current segment entry

  // Scale state
  bool scalesTared = false;

  // PID state for thermoblock heater
  float pidIntegral  = 0.0;
  float pidLastError = 0.0;                // retained for logging; derivative uses measurement now
  float pidLastMeasurement = 0.0;          // previous sensor reading (for derivative-on-measurement)
  float pidDerivativeFiltered = 0.0;       // low-pass filtered dM/dt
  unsigned long pidLastTime = 0;

  // Runtime-mutable PID gains (seeded from config.h #defines). Autotune writes
  // these on completion; UI can override via SET_PID <kp> <ki> <kd>.
  float kp = PID_KP;
  float ki = PID_KI;
  float kd = PID_KD;
} sys;

// PID derivative low-pass filter time constant (seconds). Limits noise
// amplification when Kd is large — τ_f should be several seconds for a thermal
// plant with multi-minute periods. Typical rule: τ_f = Kd / (Kp · N) with N=5-10;
// with Kp~47, Kd~3000, N=10 → ~6 s. 2 s is more responsive but still filters
// out the ±0.1 °C PT1000 jitter that would otherwise dominate the derivative.
const float PID_D_FILTER_TAU = 2.0;

// ─── Timing ───────────────────────────────────────────────────────────────────
unsigned long lastBrewTempRead  = 0;
unsigned long lastSteamTempRead = 0;
unsigned long lastPressureRead  = 0;
unsigned long lastSerialSend    = 0;

// Scale: non-blocking 8-sample accumulator for trimmed-mean averaging.
// At NAU7802_SPS_80 each conversion lands every 12.5 ms, so an 8-sample window
// spans exactly 100 ms = 6 cycles of 60 Hz / 5 cycles of 50 Hz. Mains hum is
// therefore still cancelled by the WINDOW (not by a single conversion's sinc),
// while a fresh weight is published every 100 ms instead of every 300 ms —
// matching TELEMETRY_INTERVAL so mid-brew mass no longer steps in big jumps.
// We drop the high+low of each window and average the remaining 6 to reject
// outliers (relay clicks, motor spikes).
const uint8_t SCALE_BUF_SIZE = 8;
long scaleBuf[SCALE_BUF_SIZE];   // ring buffer of the last N raw readings
uint8_t scaleBufN = 0;           // filled count (caps at SCALE_BUF_SIZE)
uint8_t scaleBufHead = 0;        // ring write index

// ─── Autotune (relay-feedback, Åström-Hägglund) ──────────────────────────────
// Pressing AUTOTUNE in settings runs this in place of the PID. Thermoblock
// swings around setpoint under bang-bang control; we measure period Tu and
// oscillation amplitude a, compute Ku = 4h/(π·a), then emit Ziegler-Nichols
// and Tyreus-Luyben gain suggestions. Target setpoint = sys.brewTemp.
struct Autotune {
  bool active        = false;
  bool relayHigh     = true;   // current output state
  uint8_t cycle      = 0;      // completed full cycles (high→low transitions)
  unsigned long phaseStart   = 0;  // wall time of last relay flip
  unsigned long autotuneStart = 0; // hard safety timeout anchor
  float tempPeak     = -1000;  // max during high half-cycle
  float tempTrough   =  1000;  // min during low half-cycle
  float sumPeak      = 0, sumTrough = 0;  // across measured cycles
  float sumPeriod    = 0;                 // ms; sum of EVERY half-period after warmup
  uint8_t nHalfPeriods = 0;               // number of halfPeriod additions to sumPeriod
  uint8_t nMeasured  = 0;                 // full cycles (peaks) counted in peak/trough averages
  unsigned long lastLog = 0;              // serial progress throttle
} autotune;

// Tuned 2026-04-23: with 0.5 °C hysteresis the thermoblock's thermal period
// was ~2.5 min/cycle → 7 cycles couldn't fit in 10 min. Widened the band to
// 1.0 °C to roughly halve the period (faster climb back across), and bumped
// the timeout to 25 min for headroom. Amplitude measurement is still fine at
// ±1 °C — process oscillation is typically several °C wider than hysteresis.
const float AUTOTUNE_HYST     = 1.0;     // ±°C hysteresis around setpoint
const uint8_t AUTOTUNE_CYCLES = 5;       // full cycles to sample (skip first 2 as warmup)
const uint8_t AUTOTUNE_WARMUP = 2;
const unsigned long AUTOTUNE_TIMEOUT_MS = 1500000UL;  // 25 min hard cap

// Auto-prime timing
unsigned long primeStartTime    = 0;

// Communication watchdog
unsigned long lastCommandTime   = 0;
const unsigned long COMM_TIMEOUT_MS = 10000;

// Pressure zero voltage (auto-calibrated in setup)
float calibratedVZero = V_ZERO;

// ── Shot replay ──────────────────────────────────────────────────────────────
// A recorded shot's pressure-vs-time curve, uploaded by the UI. When a brew is
// started via BEGIN_REPLAY, the pump follows this curve as its setpoint instead
// of a built-in profile — so a saved "god shot" can be repeated. Points are
// [t seconds, bar], strictly increasing in t.
const int   REPLAY_MAX = 64;
float       gReplayT[REPLAY_MAX];
float       gReplayBar[REPLAY_MAX];
int         gReplayN    = 0;       // loaded point count
bool        gReplayMode = false;   // true while a replay brew is running

// Linear-interpolate the replay setpoint at elapsed time t (clamped 0..11 bar).
float interpReplay(float t) {
  if (gReplayN <= 0) return 0.0f;
  if (t <= gReplayT[0]) return gReplayBar[0];
  for (int i = 1; i < gReplayN; i++) {
    if (t <= gReplayT[i]) {
      float t0 = gReplayT[i - 1], t1 = gReplayT[i];
      float b0 = gReplayBar[i - 1], b1 = gReplayBar[i];
      float f = (t1 > t0) ? (t - t0) / (t1 - t0) : 0.0f;
      return constrain(b0 + (b1 - b0) * f, 0.0f, 11.0f);
    }
  }
  return gReplayBar[gReplayN - 1];
}

// ─────────────────────────────────────────────────────────────────────────────
void setup() {
  // ── Hard-reset SPI peripheral before anything else ─────────────────
  // The SPI peripheral retains stale state across reflashing. When I2C
  // libraries initialise alongside SPI, the MAX31865 can read garbage
  // (brew 363°C) unless the bus is explicitly cleaned first.
  // ── Step 0: Hard-reset SPI peripheral (matches working v2 test) ────
  pinMode(PT1000_BREW_CS, OUTPUT);  digitalWrite(PT1000_BREW_CS, HIGH);
  pinMode(PT1000_STEAM_CS, OUTPUT); digitalWrite(PT1000_STEAM_CS, HIGH);
  pinMode(PT1000_MOSI, OUTPUT);     digitalWrite(PT1000_MOSI, LOW);
  pinMode(PT1000_MISO, INPUT);
  pinMode(PT1000_CLK, OUTPUT);      digitalWrite(PT1000_CLK, LOW);
  delay(100);
  SPI.end();
  delay(50);

  // Safe state for actuators
  pinMode(PUMP_ENA_PIN,          OUTPUT); digitalWrite(PUMP_ENA_PIN, LOW);   // Pump gated OFF at boot
  pinMode(PUMP_PWM_PIN,          OUTPUT); analogWrite(PUMP_PWM_PIN, 0);
  pinMode(HEATER_BREW_PIN,       OUTPUT); analogWrite(HEATER_BREW_PIN, 0);
  pinMode(HEATER_STEAM_PIN,      OUTPUT); digitalWrite(HEATER_STEAM_PIN, LOW);
  pinMode(VALVE_PUMP_PIN,        OUTPUT); digitalWrite(VALVE_PUMP_PIN, LOW);
  pinMode(VALVE_THERMOBLOCK_PIN, OUTPUT); digitalWrite(VALVE_THERMOBLOCK_PIN, LOW);
  sys.state = STATE_IDLE;

  Serial.begin(SERIAL_BAUD);

  // ── Step 1: I2C bus ─────────────────────────────────────────────────
  Wire.setSDA(I2C_SDA);
  Wire.setSCL(I2C_SCL);
  Wire.begin();
  Wire.setClock(400000);
  delay(200);

  #ifndef SCALE_ONLY_DEBUG
  // ADS1115 pressure sensor
  if (!adc.init()) {
    Serial.println("ERROR:ADS1115_INIT_FAILED");
  } else {
    adc.setVoltageRange_mV(ADS1115_RANGE_4096);
    adc.setCompareChannels(ADS1115_COMP_0_GND);
    adc.setMeasureMode(ADS1115_SINGLE);
  }

  // ── Pressure zero calibration ────────────────────────────────────────────
  Serial.println("Calibrating pressure zero... keep sensor at rest.");
  float sumV = 0.0;
  for (int i = 0; i < 50; i++) {
    adc.startSingleMeasurement();
    while (adc.isBusy()) { delay(1); }
    sumV += adc.getResult_V();
    delay(50);
  }
  calibratedVZero = sumV / 50.0;
  Serial.print("Pressure zero voltage: ");
  Serial.println(calibratedVZero, 3);
  #endif

  #ifndef SCALE_ONLY_DEBUG
  // ── Step 2: PT1000 sensors (SPI) ─────────────────────────────────────
  thermoBrew.begin(MAX31865_2WIRE);
  delay(200);
  thermoBrew.clearFault();

  thermoSteam.begin(MAX31865_2WIRE);
  delay(200);
  thermoSteam.clearFault();
  #endif

  // ── Step 3: NAU7802 scale — match standalone test init exactly ─────
  if (!scale.begin()) {
    Serial.println("ERROR:NAU7802_INIT_FAILED");
  } else {
    scale.setSampleRate(NAU7802_SPS_80);  // 12.5 ms/conv; 8-sample window = 100 ms
                                          // = 6 cycles 60 Hz (mains-aligned window)
    scale.calibrateAFE();
    Serial.println("NAU7802 OK");
  }

  // Hardware watchdog — start LAST so the (blocking) sensor/bus init above
  // can't trip it. From here, loop() must feed it within WDT_TIMEOUT_S or the
  // MCU hard-resets into the safe boot state (SSRs LOW, boiler unprimed).
  WDT_timings_t wdtCfg;
  wdtCfg.timeout = WDT_TIMEOUT_S;
  wdt.begin(wdtCfg);

  Serial.println("READY");
}

// ─────────────────────────────────────────────────────────────────────────────
void loop() {
  wdt.feed();                 // pet the watchdog every iteration
  processSerialCommands();
  updateSensors();
  updateSystemLogic();
  sendTelemetry();
}

// ─────────────────────────────────────────────────────────────────────────────
// Serial command handler
// ─────────────────────────────────────────────────────────────────────────────
void processSerialCommands() {
  if (!Serial.available()) return;

  lastCommandTime = millis();
  String cmd = Serial.readStringUntil('\n');
  cmd.trim();

  if (cmd.startsWith("SET_TEMP BREW ")) {
    float t = cmd.substring(14).toFloat();
    if (t >= MIN_TEMP && t <= MAX_BREW_TEMP) {
      sys.brewTemp = t;
      Serial.println("OK:BREW_TEMP_SET");
    } else {
      Serial.println("ERROR:BREW_TEMP_OUT_OF_RANGE");
    }
  }
  else if (cmd.startsWith("SET_TEMP STEAM ")) {
    float t = cmd.substring(15).toFloat();
    if (t >= MIN_TEMP && t <= MAX_STEAM_TEMP) {
      sys.steamTemp = t;
      Serial.println("OK:STEAM_TEMP_SET");
    } else {
      Serial.println("ERROR:STEAM_TEMP_OUT_OF_RANGE");
    }
  }
  else if (cmd == "START_BREW") {
    if (sys.state == STATE_IDLE || sys.state == STATE_HEATING_BREW || sys.state == STATE_PRIMING_BREW) {
      startPrimingBrew();
      Serial.println("OK:PRIMING_BREW");
    } else {
      Serial.println("ERROR:NOT_IDLE");
    }
  }
  else if (cmd == "START_STEAM" || cmd == "PRIME_BOILER") {
    // Boiler prime: fill the tank cold (pump → boiler → overflow). Best done
    // at cold startup — cold-fill = filled, no steam purge needed. Sets
    // boilerPrimed on PRIME_DONE, which unlocks all heating.
    if (sys.state == STATE_IDLE) {
      startPrimingSteam();
      Serial.println("OK:PRIMING_STEAM");
    } else {
      Serial.println("ERROR:NOT_IDLE");
    }
  }
  else if (cmd == "START_FLUSH") {
    if (sys.state == STATE_IDLE) {
      sys.state = STATE_FLUSHING;
      setValve(VALVE_PUMP_PIN, false);         // V1 LOW = pump → thermoblock
      setValve(VALVE_THERMOBLOCK_PIN, false);  // V2 LOW = thermoblock → drain
      Serial.println("OK:FLUSH_STARTED");
    } else {
      Serial.println("ERROR:NOT_IDLE");
    }
  }
  else if (cmd == "PRIME_DONE") {
    // User confirmed overflow — stop pump, advance to heating
    digitalWrite(PUMP_ENA_PIN, LOW);
    analogWrite(PUMP_PWM_PIN, 0);
    if (sys.state == STATE_PRIMING_BREW) {
      // V1 stays LOW (pump→thermoblock default) — nothing to change
      sys.state = STATE_HEATING_BREW;
      Serial.println("OK:BREW_PRIMED_HEATING");
    } else if (sys.state == STATE_PRIMING_STEAM) {
      // Boiler tank confirmed full → unlock heating. Return to IDLE; the
      // boiler then auto-preheats in the background via arbitrateHeaters
      // (cold-start staging: boiler first, thermoblock inhibited until the
      // boiler reaches its target). V1 drops LOW (pump idle routing).
      setValve(VALVE_PUMP_PIN, false);
      sys.boilerPrimed = true;
      sys.state = STATE_IDLE;
      Serial.println("OK:BOILER_PRIMED");
    } else {
      Serial.println("ERROR:NOT_PRIMING");
    }
  }
  else if (cmd == "BEGIN_BREW" || cmd == "BREW_NOW") {
    if (sys.state == STATE_HEATING_BREW) {
      sys.state = STATE_BREWING;
      tareScales();
      sys.brewTimer = millis();
      sys.pidIntegral   = 0.0;
      sys.pidLastError  = 0.0;
      sys.pidLastTime   = millis();
      // Reset pump pressure controller state for a fresh brew.
      sys.pumpIntegral   = 0.0f;
      sys.pumpPiLastMs   = millis();
      sys.pumpDLastMeas  = 0.0f;
      sys.pumpDFiltered  = 0.0f;
      sys.brewSetpoint   = 0.0f;           // segment 0 slews it up from 0
      sys.brewSlewLastMs = millis();
      // Profile engine: start at segment 0 of the active profile.
      sys.segmentIndex   = 0;
      sys.segmentStartMs = millis();
      // Snapshot pot position so manual takeover detection can compare
      // against it. handoverOffset stays at 0 until takeover fires.
      sys.potAtBrewStart = sys.pumpPower;
      sys.handoverOffset = 0;
      setValve(VALVE_PUMP_PIN, false);        // V1 LOW = pump → thermoblock
      setValve(VALVE_THERMOBLOCK_PIN, true);  // V2 HIGH = thermoblock → portafilter (pressure builds)
      // autoBrewMode true → run the active profile via the segment engine
      // (PROFILES.md §3). false → enter EXTRACT immediately = full manual
      // pot control from t=0. Manual pot-rotation takeover works mid-brew.
      sys.brewPhase = sys.autoBrewMode ? BREW_PHASE_PREINFUSE
                                        : BREW_PHASE_EXTRACT;
      Serial.println("OK:BREWING_STARTED");
    } else {
      Serial.println("ERROR:INVALID_STATE_FOR_BREW_NOW");
    }
  }
  else if (cmd.startsWith("REPLAY_LOAD")) {
    // Begin loading a replay curve. Clears any prior curve. Points follow as
    // REPLAY_PT commands. (Argument, if any, is an expected-count hint.)
    gReplayN = 0;
    gReplayMode = false;
    Serial.println("OK:REPLAY_CLEARED");
  }
  else if (cmd.startsWith("REPLAY_PT ")) {
    // REPLAY_PT <t_seconds> <bar> — append one curve vertex (silent ack to
    // avoid flooding the link while ~50 points stream in).
    String rest = cmd.substring(10); rest.trim();
    int sp = rest.indexOf(' ');
    if (sp > 0 && gReplayN < REPLAY_MAX) {
      float t = rest.substring(0, sp).toFloat();
      float b = rest.substring(sp + 1).toFloat();
      gReplayT[gReplayN]   = t;
      gReplayBar[gReplayN] = b;
      gReplayN++;
    }
  }
  else if (cmd == "BEGIN_REPLAY") {
    // Start a brew that follows the loaded replay curve (god-shot repeat).
    if (sys.state == STATE_HEATING_BREW && gReplayN >= 2) {
      sys.state = STATE_BREWING;
      tareScales();
      sys.brewTimer      = millis();
      sys.pidIntegral    = 0.0;  sys.pidLastError = 0.0;  sys.pidLastTime = millis();
      sys.pumpIntegral   = 0.0f; sys.pumpPiLastMs = millis();
      sys.pumpDLastMeas  = 0.0f; sys.pumpDFiltered = 0.0f;
      sys.brewSetpoint   = 0.0f; sys.brewSlewLastMs = millis();
      sys.segmentIndex   = 0;    sys.segmentStartMs = millis();
      sys.potAtBrewStart = sys.pumpPower;
      sys.handoverOffset = 0;
      setValve(VALVE_PUMP_PIN, false);
      setValve(VALVE_THERMOBLOCK_PIN, true);
      gReplayMode        = true;
      sys.brewPhase      = BREW_PHASE_HOLD;
      Serial.println("OK:REPLAY_STARTED");
    } else {
      Serial.println("ERROR:REPLAY_NOT_READY");
    }
  }
  else if (cmd == "BEGIN_STEAM") {
    // Enter active steaming from idle/heating. Boiler must be primed (dry-fire
    // guard). Boiler has been preheating in the background; STEAMING gives it
    // the full circuit and hard-cuts the thermoblock (arbitrateHeaters).
    if (!sys.boilerPrimed) {
      Serial.println("ERROR:BOILER_NOT_PRIMED");
    } else if (sys.state == STATE_IDLE || sys.state == STATE_HEATING_STEAM
               || sys.state == STATE_HEATING_BREW) {
      sys.state = STATE_STEAMING;
      Serial.println("OK:STEAMING_STARTED");
    } else {
      Serial.println("ERROR:INVALID_STATE_FOR_BEGIN_STEAM");
    }
  }
  else if (cmd.startsWith("SET_PID ")) {
    // SET_PID <kp> <ki> <kd> — overwrite runtime PID gains. Backend calls this
    // after autotune to persist gains, and on reconnect to restore saved gains.
    // Space-delimited manual parse to avoid pulling sscanf's float formatter
    // (≈20 KB) into flash.
    String rest = cmd.substring(8);
    rest.trim();
    int sp1 = rest.indexOf(' ');
    int sp2 = sp1 > 0 ? rest.indexOf(' ', sp1 + 1) : -1;
    float kp = (sp1 > 0) ? rest.substring(0, sp1).toFloat() : 0;
    float ki = (sp2 > 0) ? rest.substring(sp1 + 1, sp2).toFloat() : 0;
    float kd = (sp2 > 0) ? rest.substring(sp2 + 1).toFloat() : 0;
    // Bounds match the autotune sanity ranges — thermal plants with long Tu
    // legitimately produce large Kd via TL's Ku·Tu/6.3. Reject only garbage.
    bool sane = (sp2 > 0 && kp > 0 && kp < 500 && ki >= 0 && ki < 50 && kd >= 0 && kd < 5000);
    if (sane) {
      sys.kp = kp;
      sys.ki = ki;
      sys.kd = kd;
      sys.pidIntegral  = 0;
      sys.pidLastError = 0;
      Serial.print("OK:PID_SET:"); Serial.print(kp, 3);
      Serial.print(","); Serial.print(ki, 3);
      Serial.print(","); Serial.println(kd, 3);
    } else {
      Serial.println("ERROR:PID_GAINS_OUT_OF_RANGE");
    }
  }
  else if (cmd == "AUTOTUNE_START") {
    // Reset autotune state and kick relay cycling.
    autotune = Autotune{};  // reset to defaults
    autotune.active = true;
    autotune.autotuneStart = millis();
    autotune.phaseStart = millis();
    autotune.relayHigh = (sys.brewTempActual < sys.brewTemp);
    autotune.lastLog = 0;
    Serial.println("AUTOTUNE:STARTED");
  }
  else if (cmd == "AUTOTUNE_STOP") {
    if (autotune.active) {
      autotune.active = false;
      analogWrite(HEATER_BREW_PIN, 0);
      sys.heaterBrewOn = false;
      Serial.println("AUTOTUNE:CANCELLED");
    }
  }
  else if (cmd == "HEAT_BREW") {
    // Enter thermoblock heating without pumping water. UI calls this when the
    // user opens the brew screen; priming is optional (pump → START in overlay).
    if (sys.state == STATE_IDLE || sys.state == STATE_HEATING_BREW
        || sys.state == STATE_PRIMING_BREW) {
      sys.state = STATE_HEATING_BREW;
      Serial.println("OK:HEATING_BREW");
    } else {
      Serial.println("ERROR:BAD_STATE_FOR_HEAT_BREW");
    }
  }
  else if (cmd == "HEAT_STEAM") {
    // Enter boiler heating without pumping water.
    if (sys.state == STATE_IDLE || sys.state == STATE_HEATING_STEAM
        || sys.state == STATE_PRIMING_STEAM) {
      sys.state = STATE_HEATING_STEAM;
      Serial.println("OK:HEATING_STEAM");
    } else {
      Serial.println("ERROR:BAD_STATE_FOR_HEAT_STEAM");
    }
  }
  else if (cmd == "STOP" || cmd == "ABORT") {
    stopCurrentOperation();
    Serial.println("OK:STOPPED");
  }
  else if (cmd == "TARE_SCALES") {
    tareScales();
    Serial.println("OK:SCALES_TARED");
  }
  else if (cmd.startsWith("CAL_SCALE ")) {
    float knownWeight = cmd.substring(10).toFloat();
    if (knownWeight > 0) {
      calibrateScale(knownWeight);
      Serial.println("OK:SCALES_CALIBRATED");
    } else {
      Serial.println("ERROR:INVALID_WEIGHT");
    }
  }
  else if (cmd.startsWith("SET_SCALE_CAL ")) {
    float cal = cmd.substring(14).toFloat();
    if (cal != 0.0) {
      scale.setCalibrationFactor(cal);
      Serial.println("OK:SCALE_CAL_SET");
    } else {
      Serial.println("ERROR:INVALID_CAL_FORMAT");
    }
  }
  else if (cmd == "GET_STATUS") {
    sendStatus();
  }
  else if (cmd == "PING") {
    Serial.println("PONG");
  }
  else if (cmd.startsWith("SET_HEATERS_ENABLE ")) {
    int v = cmd.substring(19).toInt();
    sys.heatersEnabled = (v != 0);
    if (!sys.heatersEnabled) {
      // Kill both SSRs immediately — don't wait for next PID tick
      analogWrite(HEATER_BREW_PIN,  0);
      digitalWrite(HEATER_STEAM_PIN, LOW);
      sys.heaterBrewOn  = false;
      sys.heaterSteamOn = false;
    }
    Serial.print("OK:HEATERS_"); Serial.println(sys.heatersEnabled ? "ENABLED" : "DISABLED");
  }
  else if (cmd.startsWith("SET_AUTO_MODE ")) {
    // SET_AUTO_MODE 1 = run the active profile (segment engine) on next
    // BEGIN_BREW. SET_AUTO_MODE 0 = brew enters EXTRACT immediately (full
    // manual / pot). Takes effect on the NEXT brew.
    int v = cmd.substring(14).toInt();
    sys.autoBrewMode = (v != 0);
    Serial.print("OK:AUTO_MODE_"); Serial.println(sys.autoBrewMode ? "ON" : "OFF");
  }
  else if (cmd.startsWith("SET_PROFILE ")) {
    // SET_PROFILE <n> — select the active brew profile by index. Takes
    // effect on the next BEGIN_BREW. Reply carries the name so the UI can
    // display it without hardcoding the profile list.
    int n = cmd.substring(12).toInt();
    if (n >= 0 && n < N_BREW_PROFILES) {
      sys.activeProfile = (uint8_t)n;
      Serial.print("OK:PROFILE:"); Serial.print(n);
      Serial.print(":"); Serial.println(BREW_PROFILES[n].name);
    } else {
      Serial.println("ERROR:BAD_PROFILE_INDEX");
    }
  }
  else if (cmd == "GET_PROFILES") {
    // List all profiles so the UI can build its picker. One line per profile.
    for (uint8_t i = 0; i < N_BREW_PROFILES; i++) {
      Serial.print("PROFILE:"); Serial.print(i);
      Serial.print(":"); Serial.println(BREW_PROFILES[i].name);
    }
    Serial.print("OK:PROFILE_COUNT:"); Serial.println(N_BREW_PROFILES);
  }
  else if (cmd.length() > 0) {
    Serial.print("ERROR:UNKNOWN_COMMAND:\"");
    Serial.print(cmd);
    Serial.println("\"");
  }
}

// ─────────────────────────────────────────────────────────────────────────────
// Sensor reads (non-blocking)
// ─────────────────────────────────────────────────────────────────────────────
void updateSensors() {
  unsigned long now = millis();

  // ── SCALE_ONLY_DEBUG ─ all other sensors disabled to isolate scale noise
  #ifndef SCALE_ONLY_DEBUG
  // ── Thermoblock PT1000 ───────────────────────────────────────────────────
  if (now - lastBrewTempRead >= TEMP_READ_INTERVAL) {
    sys.brewTempActual = thermoBrew.temperature(RNOMINAL, RREF);
    uint8_t fault = thermoBrew.readFault();
    if (fault) {
      Serial.print("ERROR:PT1000_BREW_FAULT:0x"); Serial.println(fault, HEX);
      thermoBrew.clearFault();
    }
    lastBrewTempRead = millis();
  }

  // ── Steam boiler PT1000 ──────────────────────────────────────────────────
  now = millis();
  if (now - lastSteamTempRead >= TEMP_READ_INTERVAL) {
    sys.steamTempActual = thermoSteam.temperature(RNOMINAL, RREF);
    uint8_t fault = thermoSteam.readFault();
    if (fault) {
      Serial.print("ERROR:PT1000_STEAM_FAULT:0x"); Serial.println(fault, HEX);
      thermoSteam.clearFault();
    }
    lastSteamTempRead = millis();
  }

  // ── Pressure (ADS1115) ───────────────────────────────────────────────────
  now = millis();
  if (now - lastPressureRead >= PRESSURE_READ_INTERVAL) {
    adc.startSingleMeasurement();
    while (adc.isBusy()) {}
    float v = adc.getResult_V();
    sys.pressure = mapPressure(v);
    lastPressureRead = millis();
  }
  #endif

  // ── Scale (NAU7802) ─────────────────────────────────────────────────────
  // Non-blocking trimmed-mean: pull a raw reading whenever the chip flags one
  // ready, accumulate 8, then drop high+low and average the middle 6. With
  // SPS=80 each output is a fresh 8×12.5 ms = 100 ms window — mains-aligned
  // (6 cycles of 60 Hz) and outlier-trimmed, published at the telemetry rate.
  // Empty-tray deadband suppresses last-digit twitch.
  if (scale.available()) {
    // Push into the ring buffer, then recompute the trimmed mean on EVERY new
    // sample — so sys.weight refreshes at the sample/loop rate, not once per
    // full 8-sample window. (The old "fill 8 then emit" made weight update only
    // ~2–5 Hz because the loop pulls one sample per iteration.)
    scaleBuf[scaleBufHead] = scale.getReading();
    scaleBufHead = (scaleBufHead + 1) % SCALE_BUF_SIZE;
    if (scaleBufN < SCALE_BUF_SIZE) scaleBufN++;

    if (scaleBufN >= 3) {
      long tmp[SCALE_BUF_SIZE];
      for (uint8_t i = 0; i < scaleBufN; i++) tmp[i] = scaleBuf[i];
      // insertion sort tmp[0..scaleBufN-1]
      for (uint8_t i = 1; i < scaleBufN; i++) {
        long key = tmp[i];
        int8_t j = i - 1;
        while (j >= 0 && tmp[j] > key) { tmp[j + 1] = tmp[j]; j--; }
        tmp[j + 1] = key;
      }
      long sum = 0;
      for (uint8_t i = 1; i < scaleBufN - 1; i++) sum += tmp[i];   // drop hi + lo
      long avg = sum / (scaleBufN - 2);
      float w = (float)(avg - scale.getZeroOffset()) / scale.getCalibrationFactor();
      if (fabsf(w) < 0.15f) w = 0.0f;
      sys.weight = w;
    }
  }

  #ifndef SCALE_ONLY_DEBUG
  // ── Potentiometer for manual pump speed ─────────────────────────────────
  int potValue = analogRead(POT_PIN);
  sys.pumpPower = potValue / 4;  // 0–1023 → 0–255
  #endif
}

// ─────────────────────────────────────────────────────────────────────────────
// System logic (state machine)
// ─────────────────────────────────────────────────────────────────────────────
void updateSystemLogic() {
  // Hold everything off until PC connects
  if (lastCommandTime == 0) {
    safeOff();
    return;
  }
  // Communication watchdog
  if (millis() - lastCommandTime > COMM_TIMEOUT_MS) {
    stopCurrentOperation();
    return;
  }

  switch (sys.state) {

    case STATE_PRIMING_BREW:
      // V1 LOW (de-energised default) → pump → thermoblock
      // V2 LOW → thermoblock → drain
      // Water flows pump→thermoblock→drain; user watches for overflow, sends PRIME_DONE.
      setValve(VALVE_PUMP_PIN, false);
      setValve(VALVE_THERMOBLOCK_PIN, false);
      digitalWrite(PUMP_ENA_PIN, HIGH);
      analogWrite(PUMP_PWM_PIN, PUMP_PWM_QUIET);   // 65% — noise cap
      // Safety watchdog: abort if confirmation never arrives
      if (millis() - primeStartTime >= PRIME_SAFETY_TIMEOUT_MS) {
        digitalWrite(PUMP_ENA_PIN, LOW);
        analogWrite(PUMP_PWM_PIN, 0);
        sys.state = STATE_IDLE;
        Serial.println("ERROR:PRIME_BREW_TIMEOUT");
      }
      break;

    case STATE_PRIMING_STEAM:
      // V1 HIGH (energised) → pump → boiler
      // Water flows pump→boiler; user watches for overflow at boiler OPV, then PRIME_DONE.
      setValve(VALVE_PUMP_PIN, true);
      setValve(VALVE_THERMOBLOCK_PIN, false);
      digitalWrite(PUMP_ENA_PIN, HIGH);
      analogWrite(PUMP_PWM_PIN, PUMP_PWM_QUIET);   // 65% — noise cap
      // Safety watchdog
      if (millis() - primeStartTime >= PRIME_SAFETY_TIMEOUT_MS) {
        digitalWrite(PUMP_ENA_PIN, LOW);
        analogWrite(PUMP_PWM_PIN, 0);
        setValve(VALVE_PUMP_PIN, false);
        sys.state = STATE_IDLE;
        Serial.println("ERROR:PRIME_STEAM_TIMEOUT");
      }
      break;

    case STATE_HEATING_BREW:
      // Heater handled continuously below; this case just parks the pump.
      digitalWrite(PUMP_ENA_PIN, LOW);
      analogWrite(PUMP_PWM_PIN, 0);
      break;

    case STATE_HEATING_STEAM:
      // Boiler heating handled by arbitrateHeaters() below. Pump parked.
      digitalWrite(PUMP_ENA_PIN, LOW);
      analogWrite(PUMP_PWM_PIN, 0);
      break;

    case STATE_BREWING:
      // Stage 1: the brew profile engine. autoBrewMode runs the active
      // profile's segment list (runBrewSegmentEngine). EXTRACT = manual pot
      // control — entered at brew start when autoBrewMode is off, or via a
      // mid-brew pot-rotation takeover. See PROFILES.md §3.
      digitalWrite(PUMP_ENA_PIN, HIGH);
      if (sys.brewPhase == BREW_PHASE_EXTRACT) {
        // Manual: pot drives PWM with the bumpless offset captured at takeover
        // (0 if the brew started in manual). pot down → PWM down (taper).
        // Pot at/near zero = user wants OFF: force 0, overriding the offset
        // (and staying below the driver's 300 rpm floor region).
        int pwm = (sys.pumpPower <= POT_ZERO_DEADBAND) ? 0
                  : constrain(sys.pumpPower + sys.handoverOffset,
                              0, PUMP_PWM_FULL);
        analogWrite(PUMP_PWM_PIN, pwm);
        sys.lastPumpPwm = pwm;
      } else if (gReplayMode) {
        runReplayEngine();
      } else {
        runBrewSegmentEngine();
      }
      break;

    case STATE_STEAMING:
      // Active steam: boiler full-duty (arbitrateHeaters), thermoblock cut.
      // Steam is drawn through the wand — pump stays off.
      digitalWrite(PUMP_ENA_PIN, LOW);
      analogWrite(PUMP_PWM_PIN, 0);
      break;

    case STATE_FLUSHING:
      // V1 LOW → pump → thermoblock; V2 HIGH → thermoblock → portafilter.
      // Flushes hot water through the group head for warm-up or backflushing.
      // On STOP/ABORT, safeOff() drops V2 LOW → portafilter pressure to drain.
      setValve(VALVE_PUMP_PIN, false);
      setValve(VALVE_THERMOBLOCK_PIN, true);
      digitalWrite(PUMP_ENA_PIN, HIGH);
      // 65% noise cap. Backflush still works: against a blind basket flow → 0,
      // so the pump still builds to OPV-crack pressure (4 mm gears reach 12+
      // bar at low flow even at ~2 V control) — it just builds a bit slower.
      analogWrite(PUMP_PWM_PIN, PUMP_PWM_QUIET);
      break;

    case STATE_IDLE:
    default:
      safeOff();
      break;
  }

  // Single-circuit heater arbitration (Stage 9 / HEATING.md §5). Decides which
  // element(s) may heat this tick so total instantaneous draw never exceeds
  // one element (8.3 A). Replaces the old unconditional controlBrewHeater().
  arbitrateHeaters();
}

// Heater arbitration for the shared 15 A / 120 V circuit. Task-switch model:
// user brews OR steams, never both. Rules:
//   • Nothing heats until the boiler is primed (dry-fire guard, user rule).
//   • Steaming → boiler active, thermoblock HARD CUT (breaker + task switch).
//   • Cold start → boiler preheats first, thermoblock inhibited, until the
//     boiler first reaches its target (avoids 16.6 A parallel warmup).
//   • Normal brew/idle → thermoblock active; boiler maintains in background
//     only on ticks the thermoblock doesn't fire (1-tick mutex → SSRs never
//     both on the same tick → ≤ 8.3 A instantaneous, always).
void arbitrateHeaters() {
  // Prime gate — no heating of any kind until the boiler tank is confirmed full.
  if (!sys.boilerPrimed) {
    analogWrite(HEATER_BREW_PIN, 0);  sys.heaterBrewOn  = false;
    digitalWrite(HEATER_STEAM_PIN, LOW); sys.heaterSteamOn = false;
    return;
  }

  bool steaming = (sys.state == STATE_STEAMING || sys.state == STATE_HEATING_STEAM);

  if (steaming) {
    // Boiler is the active task. Thermoblock off; reset its PID so it resumes
    // cleanly once steaming ends.
    analogWrite(HEATER_BREW_PIN, 0);
    sys.heaterBrewOn = false;
    sys.pidIntegral  = 0;
    sys.pidLastError = 0;
    controlSteamHeater();
    return;
  }

  // Cold-start staging: boiler to target first, thermoblock inhibited.
  if (!sys.boilerPreheatComplete) {
    analogWrite(HEATER_BREW_PIN, 0);
    sys.heaterBrewOn = false;
    controlSteamHeater();
    if (sys.steamTempActual >= sys.steamTemp + STEAM_PREHEAT_OVERSHOOT) {
      sys.boilerPreheatComplete = true;
      Serial.println("INFO:BOILER_READY_HEATING_BREW");
    }
    return;
  }

  // Normal: thermoblock active, boiler maintenance in background via mutex.
  if (autotune.active) autotuneStep();
  else                 controlBrewHeater();   // sets sys.heaterBrewOn

  if (!sys.heaterBrewOn) {
    controlSteamHeater();              // boiler free to heat this tick
  } else {
    digitalWrite(HEATER_STEAM_PIN, LOW);  // thermoblock won the tick — hold boiler off
    sys.heaterSteamOn = false;
  }
}

// ─────────────────────────────────────────────────────────────────────────────
// Heater control
// ─────────────────────────────────────────────────────────────────────────────

// Relay-feedback autotune step. Runs at main-loop rate; bypasses PID and drives
// HEATER_BREW_PIN directly based on temp-vs-setpoint with hysteresis. Emits
// AUTOTUNE:... progress lines (throttled 1 Hz) and a final AUTOTUNE_RESULT:...
// on success or AUTOTUNE:FAIL:<reason> on timeout / out-of-range.
void autotuneStep() {
  float temp = sys.brewTempActual;
  float setpoint = sys.brewTemp;
  unsigned long now = millis();

  // Safety: hard timeout
  if (now - autotune.autotuneStart > AUTOTUNE_TIMEOUT_MS) {
    analogWrite(HEATER_BREW_PIN, 0);
    sys.heaterBrewOn = false;
    autotune.active = false;
    Serial.println("AUTOTUNE:FAIL:TIMEOUT");
    return;
  }
  // Safety: over-temp (>MAX_BREW_TEMP during autotune is same as normal)
  if (temp >= MAX_BREW_TEMP) {
    analogWrite(HEATER_BREW_PIN, 0);
    sys.heaterBrewOn = false;
    autotune.active = false;
    Serial.print("AUTOTUNE:FAIL:OVERTEMP,"); Serial.println(temp, 1);
    return;
  }

  // Track peak/trough within current half-cycle
  if (autotune.relayHigh) {
    if (temp > autotune.tempPeak) autotune.tempPeak = temp;
  } else {
    if (temp < autotune.tempTrough) autotune.tempTrough = temp;
  }

  // Relay switching logic (Schmitt trigger around setpoint)
  bool switched = false;
  if (autotune.relayHigh && temp >= setpoint + AUTOTUNE_HYST) {
    autotune.relayHigh = false;
    switched = true;
  } else if (!autotune.relayHigh && temp <= setpoint - AUTOTUNE_HYST) {
    autotune.relayHigh = true;
    switched = true;
  }

  if (switched) {
    unsigned long halfPeriod = now - autotune.phaseStart;
    autotune.phaseStart = now;

    // Count a cycle on each high→low transition (peak detected).
    if (!autotune.relayHigh) autotune.cycle++;

    // After warmup, accumulate EVERY half-period so Tu correctly sums both
    // heating and cooling halves (they're asymmetric on a thermal plant —
    // heating is fast under full 8.3 A, cooling is slow via ambient losses).
    if (autotune.cycle > AUTOTUNE_WARMUP) {
      autotune.sumPeriod += halfPeriod;
      autotune.nHalfPeriods++;

      // Snapshot peak/trough only at peak transitions (once per full cycle).
      if (!autotune.relayHigh) {
        autotune.sumPeak   += autotune.tempPeak;
        autotune.sumTrough += autotune.tempTrough;
        autotune.nMeasured++;
      }
    }

    if (!autotune.relayHigh) autotune.tempTrough = 1000;
    else                     autotune.tempPeak   = -1000;
  }

  // Drive heater
  analogWrite(HEATER_BREW_PIN, autotune.relayHigh ? HEATER_PWM_FULL : 0);
  sys.heaterBrewOn = autotune.relayHigh;

  // Progress log (1 Hz)
  if (now - autotune.lastLog >= 1000) {
    autotune.lastLog = now;
    Serial.print("AUTOTUNE:RUNNING,cycle=");
    Serial.print(autotune.cycle); Serial.print("/");
    Serial.print(AUTOTUNE_WARMUP + AUTOTUNE_CYCLES);
    Serial.print(",temp="); Serial.print(temp, 1);
    Serial.print(",relay="); Serial.println(autotune.relayHigh ? "HIGH" : "LOW");
  }

  // Completion
  if (autotune.nMeasured >= AUTOTUNE_CYCLES) {
    analogWrite(HEATER_BREW_PIN, 0);
    sys.heaterBrewOn = false;
    autotune.active = false;

    float avgPeak    = autotune.sumPeak   / autotune.nMeasured;
    float avgTrough  = autotune.sumTrough / autotune.nMeasured;
    float a          = (avgPeak - avgTrough) / 2.0f;         // °C
    // Tu = full period = sum of BOTH half-periods / number of full cycles.
    // sumPeriod holds nHalfPeriods half-periods; each full cycle has 2 halves.
    float Tu         = autotune.nHalfPeriods > 0
                         ? (autotune.sumPeriod / (autotune.nHalfPeriods / 2.0f)) / 1000.0f
                         : 0.0f;
    float h          = (float)HEATER_PWM_FULL / 2.0f;        // relay half-amplitude
    float Ku         = (4.0f * h) / (3.14159265f * a);

    // Classic Ziegler-Nichols (more aggressive)
    float kpZN = 0.6f * Ku;
    float kiZN = 1.2f * Ku / Tu;
    float kdZN = 0.075f * Ku * Tu;
    // Tyreus-Luyben (gentler — recommended for thermal plants)
    float kpTL = Ku / 3.2f;
    float kiTL = Ku / (2.2f * Tu);
    float kdTL = Ku * Tu / 6.3f;

    // Sanity-check Tyreus-Luyben gains before auto-applying. Bounds are loose
    // — thermal plants with long Tu legitimately produce large Kd via TL's
    // Ku·Tu/6.3 formula. Reject only actual garbage (NaN, sub-zero, etc.).
    bool sane = (isfinite(Ku) && isfinite(Tu) && isfinite(a)
                 && Ku > 0.1 && Ku < 5000
                 && Tu > 0.5 && Tu < 600
                 && a > 0.2
                 && kpTL > 0 && kpTL < 500
                 && kiTL > 0 && kiTL < 50
                 && kdTL > 0 && kdTL < 5000);

    Serial.print("AUTOTUNE_RESULT:");
    Serial.print("Ku="); Serial.print(Ku, 3);
    Serial.print(",Tu="); Serial.print(Tu, 2);
    Serial.print(",a="); Serial.print(a, 2);
    Serial.print(",ZN="); Serial.print(kpZN, 2); Serial.print("/");
    Serial.print(kiZN, 3); Serial.print("/"); Serial.print(kdZN, 2);
    Serial.print(",TL="); Serial.print(kpTL, 2); Serial.print("/");
    Serial.print(kiTL, 3); Serial.print("/"); Serial.print(kdTL, 2);
    Serial.print(",applied="); Serial.println(sane ? "TL" : "NONE");

    if (sane) {
      sys.kp = kpTL;
      sys.ki = kiTL;
      sys.kd = kdTL;
      sys.pidIntegral  = 0;
      sys.pidLastError = 0;
    }
  }
}

// PID controller for the thermoblock (brew) heater, with bang-bang warmup layer.
// Control strategy:
//   error > WARMUP_BAND → full PWM, integrator reset (no wind-up during climb)
//   error ≤ WARMUP_BAND → standard PID (gains from sys.kp/ki/kd, auto-tunable)
// This matches commercial espresso-controller practice: avoid PID saturation
// during the cold-start climb, then let PID handle the last 5 °C + disturbance
// rejection during brews.
const float WARMUP_BAND_C = 5.0;

// Stage 0: shared closed-loop PI controller for pump pressure. Used by all
// three managed brew phases (PREINFUSE / RAMP / HOLD) — only the target,
// gains, and clamps differ. Anti-windup: integrator only accumulates when
// the output is unsaturated, which prevents wind-up after a pressure spike
// that causes the loop to floor at minPwm for a few hundred ms.
int pumpClosedLoop(float targetBar, int basePwm, float kp, float ki, float kd,
                   int minPwm, int maxPwm) {
  unsigned long now = millis();
  float dt = (now - sys.pumpPiLastMs) * 0.001f;
  if (dt <= 0.0f || dt > 0.5f) dt = 0.0f;  // ignore first call / huge gaps
  sys.pumpPiLastMs = now;

  // D-on-measurement: derivative of pressure, low-pass filtered. Negative
  // contribution when pressure is rising → brakes pump preemptively, fights
  // pump→pressure transport lag that otherwise causes post-RAMP overshoot.
  // (D-on-measurement avoids a derivative kick on setpoint changes.)
  float dCorrection = 0.0f;
  if (kd != 0.0f && dt > 0.0f) {
    float dMeas = (sys.pressure - sys.pumpDLastMeas) / dt;
    // First-order low-pass: y += (alpha) * (x - y), alpha = dt / (tau + dt)
    float alpha = dt / (PUMP_D_FILTER_TAU + dt);
    sys.pumpDFiltered += alpha * (dMeas - sys.pumpDFiltered);
    dCorrection = -kd * sys.pumpDFiltered;  // rising pressure → negative ΔPWM
  }
  sys.pumpDLastMeas = sys.pressure;

  float err = targetBar - sys.pressure;
  float pCorrection = kp * err;
  float iCorrection = ki * sys.pumpIntegral;
  int pwm = basePwm + (int)(pCorrection + iCorrection + dCorrection);

  // Anti-windup: only integrate when output isn't saturated, OR when the
  // error would push the output back into the linear range.
  bool saturatedHigh = (pwm >= maxPwm) && (err > 0.0f);
  bool saturatedLow  = (pwm <= minPwm) && (err < 0.0f);
  if (!saturatedHigh && !saturatedLow) {
    sys.pumpIntegral += err * dt;
    sys.pumpIntegral = constrain(sys.pumpIntegral,
                                 -PUMP_PI_INTEGRAL_MAX, PUMP_PI_INTEGRAL_MAX);
  }

  int output = constrain(pwm, minPwm, maxPwm);
  sys.lastPumpPwm = output;  // for bumpless phase transitions
  return output;
}

// Stage 1 brew profile engine. Plays the active profile's segment list:
// slews the pressure setpoint toward each segment's target, runs the shared
// PI(D) controller with that segment's gain set, and advances when an exit
// criterion fires. The final segment runs until the user STOPs. A manual
// pot-rotation takeover hands control to the pot at any point. PROFILES.md §3.
// Replay engine — drive the pump to follow the uploaded recorded pressure
// curve (gReplayT/gReplayBar) as a time-indexed setpoint. Pot rotation still
// takes over (same as the profile engine); the shot auto-stops at curve end.
void runReplayEngine() {
  unsigned long now = millis();

  // Manual takeover — pot rotated past threshold since brew start.
  if (abs(sys.pumpPower - sys.potAtBrewStart) > MANUAL_TAKEOVER_DELTA) {
    sys.handoverOffset = sys.lastPumpPwm - sys.pumpPower;
    sys.brewPhase = BREW_PHASE_EXTRACT;
    Serial.println("INFO:BREW_MANUAL_TAKEOVER");
    int pwm = (sys.pumpPower <= POT_ZERO_DEADBAND) ? 0
              : constrain(sys.pumpPower + sys.handoverOffset, 0, PUMP_PWM_FULL);
    analogWrite(PUMP_PWM_PIN, pwm);
    sys.lastPumpPwm = pwm;
    return;
  }

  float elapsed = (now - sys.brewTimer) * 0.001f;

  // End of the recorded curve → the shot is complete. Stop cleanly.
  if (gReplayN < 2 || elapsed >= gReplayT[gReplayN - 1]) {
    analogWrite(PUMP_PWM_PIN, 0);
    digitalWrite(PUMP_ENA_PIN, LOW);
    stopCurrentOperation();
    Serial.println("INFO:REPLAY_DONE");
    return;
  }

  // Follow the recorded pressure as the setpoint. Use the gentle preinfuse gain
  // set at low pressure (the wetting phase), the stiffer brew set above it.
  sys.brewSetpoint = interpReplay(elapsed);
  sys.brewPhase = BREW_PHASE_HOLD;   // telemetry only
  int pwm;
  if (sys.brewSetpoint < 3.0f)
    pwm = pumpClosedLoop(sys.brewSetpoint, PREINFUSE_BASE_PWM,
                         PREINFUSE_KP, PREINFUSE_KI, PREINFUSE_KD,
                         PREINFUSE_MIN_PWM, PREINFUSE_MAX_PWM);
  else
    pwm = pumpClosedLoop(sys.brewSetpoint, BREW_BASE_PWM,
                         BREW_KP, BREW_KI, BREW_KD,
                         BREW_MIN_PWM, BREW_MAX_PWM);
  analogWrite(PUMP_PWM_PIN, pwm);
}

void runBrewSegmentEngine() {
  const BrewProfile& prof = BREW_PROFILES[sys.activeProfile];
  uint8_t idx = sys.segmentIndex;
  if (idx >= prof.nSegments) idx = prof.nSegments - 1;   // safety clamp
  const BrewSegment& seg = prof.segments[idx];
  unsigned long now = millis();

  // Manual takeover — pot rotated past threshold since brew start. Capture a
  // bumpless PWM offset so pressure doesn't step, then hand to the pot.
  if (abs(sys.pumpPower - sys.potAtBrewStart) > MANUAL_TAKEOVER_DELTA) {
    sys.handoverOffset = sys.lastPumpPwm - sys.pumpPower;
    sys.brewPhase = BREW_PHASE_EXTRACT;
    Serial.println("INFO:BREW_MANUAL_TAKEOVER");
    int pwm = (sys.pumpPower <= POT_ZERO_DEADBAND) ? 0
              : constrain(sys.pumpPower + sys.handoverOffset, 0, PUMP_PWM_FULL);
    analogWrite(PUMP_PWM_PIN, pwm);
    sys.lastPumpPwm = pwm;
    return;
  }

  // Slew the setpoint toward the segment target at the segment's slew rate.
  float dt = (now - sys.brewSlewLastMs) * 0.001f;
  sys.brewSlewLastMs = now;
  if (dt > 0.0f && dt < 0.5f) {
    float step = seg.slewRate * dt;
    if (sys.brewSetpoint < seg.targetBar)
      sys.brewSetpoint = min(seg.targetBar, sys.brewSetpoint + step);
    else if (sys.brewSetpoint > seg.targetBar)
      sys.brewSetpoint = max(seg.targetBar, sys.brewSetpoint - step);
  }

  // Telemetry phase: segment 0 = preinfuse; otherwise ramp while the setpoint
  // is still moving, hold once it has settled at the segment target.
  if (idx == 0)
    sys.brewPhase = BREW_PHASE_PREINFUSE;
  else if (fabs(sys.brewSetpoint - seg.targetBar) > 0.05f)
    sys.brewPhase = BREW_PHASE_RAMP;
  else
    sys.brewPhase = BREW_PHASE_HOLD;

  // Run the shared PI(D) controller with the segment's gain set.
  int pwm;
  if (seg.gains == GAINS_PREINFUSE)
    pwm = pumpClosedLoop(sys.brewSetpoint, PREINFUSE_BASE_PWM,
                         PREINFUSE_KP, PREINFUSE_KI, PREINFUSE_KD,
                         PREINFUSE_MIN_PWM, PREINFUSE_MAX_PWM);
  else
    pwm = pumpClosedLoop(sys.brewSetpoint, BREW_BASE_PWM,
                         BREW_KP, BREW_KI, BREW_KD,
                         BREW_MIN_PWM, BREW_MAX_PWM);
  analogWrite(PUMP_PWM_PIN, pwm);

  // Exit criteria — first non-zero criterion to fire advances the segment.
  // The final segment ignores exit criteria (runs until user STOP).
  if (idx + 1 < prof.nSegments) {
    unsigned long elapsed = now - sys.segmentStartMs;
    bool advance = false;
    if (seg.exitWeightG     > 0.0f && sys.weight   >= seg.exitWeightG)     advance = true;
    if (seg.exitDurationMs  > 0    && elapsed      >= seg.exitDurationMs)  advance = true;
    if (seg.exitPressureBar > 0.0f && sys.pressure >= seg.exitPressureBar) advance = true;
    if (advance) {
      sys.segmentIndex   = idx + 1;
      sys.segmentStartMs = now;
      Serial.print("INFO:BREW_SEGMENT:"); Serial.println(sys.segmentIndex);
    }
  }
}

void controlBrewHeater() {
#ifdef COLD_TEST_MODE
  analogWrite(HEATER_BREW_PIN, 0);
  sys.heaterBrewOn = false;
  return;
#endif

  float target = sys.brewTemp;
  float actual = sys.brewTempActual;

  if (actual >= MAX_BREW_TEMP) {
    analogWrite(HEATER_BREW_PIN, 0);
    sys.heaterBrewOn = false;
    return;
  }

  float error = target - actual;
  unsigned long now = millis();

  // Warmup: bang-bang full on until within WARMUP_BAND of setpoint.
  if (error > WARMUP_BAND_C) {
    int pwm = sys.heatersEnabled ? HEATER_PWM_FULL : 0;
    analogWrite(HEATER_BREW_PIN, pwm);
    sys.heaterBrewOn = (pwm > 0);
    sys.pidIntegral           = 0;       // no wind-up
    sys.pidLastError          = error;
    sys.pidLastMeasurement    = actual;  // so first derivative after handoff is 0
    sys.pidDerivativeFiltered = 0;
    sys.pidLastTime           = now;
    return;
  }

  // PID zone: within ±WARMUP_BAND of setpoint.
  float dt = (now - sys.pidLastTime) / 1000.0;
  if (dt <= 0.0 || dt > 5.0) dt = 0.5;
  sys.pidLastTime = now;

  sys.pidIntegral += error * dt;
  sys.pidIntegral = constrain(sys.pidIntegral, -100.0, 100.0);

  // Derivative on measurement (not error) — avoids setpoint-step kick — and
  // low-passed to suppress PT1000 noise. Sign: rising measurement should
  // reduce output (we're approaching setpoint), so the PID output term is
  // -Kd * dM/dt (equivalent to +Kd · d(error)/dt in steady-state because
  // d(error) = d(setpoint - measurement) = -dM when setpoint is constant).
  float dMeasRaw = (actual - sys.pidLastMeasurement) / dt;
  sys.pidLastMeasurement = actual;
  float alpha = dt / (PID_D_FILTER_TAU + dt);
  sys.pidDerivativeFiltered = alpha * dMeasRaw
                            + (1.0f - alpha) * sys.pidDerivativeFiltered;
  sys.pidLastError = error;

  float output = sys.kp * error
               + sys.ki * sys.pidIntegral
               - sys.kd * sys.pidDerivativeFiltered;
  int pwm = (int)constrain(output, 0, 255);
  if (!sys.heatersEnabled) pwm = 0;
  analogWrite(HEATER_BREW_PIN, pwm);
  sys.heaterBrewOn = (pwm > 0);
}

// Simple thermostat for the steam boiler
void controlSteamHeater() {
#ifdef COLD_TEST_MODE
  digitalWrite(HEATER_STEAM_PIN, LOW);
  sys.heaterSteamOn = false;
  return;
#endif

  float actual = sys.steamTempActual;
  // Hold steamTemp + overshoot so the boiler stays at usable steam temp after
  // coasting through a shot (thermoblock-priority ticks). HEATING.md §5.
  float target = sys.steamTemp + STEAM_PREHEAT_OVERSHOOT;

  if (actual >= MAX_STEAM_TEMP) {
    digitalWrite(HEATER_STEAM_PIN, LOW);
    sys.heaterSteamOn = false;
    return;
  }

  bool shouldHeat = sys.heaterSteamOn
    ? (actual < target)
    : (actual < target - STEAM_HYSTERESIS);

  if (!sys.heatersEnabled) shouldHeat = false;
  digitalWrite(HEATER_STEAM_PIN, shouldHeat ? HIGH : LOW);
  sys.heaterSteamOn = shouldHeat;
}

// ─────────────────────────────────────────────────────────────────────────────
// Valve control
// ─────────────────────────────────────────────────────────────────────────────
void setValve(int pin, bool open) {
  digitalWrite(pin, open ? HIGH : LOW);
  if (pin == VALVE_THERMOBLOCK_PIN) sys.valveThermoblockOpen = open;
  if (pin == VALVE_PUMP_PIN)        sys.valvePumpOpen        = open;
}

// ─────────────────────────────────────────────────────────────────────────────
// Scale operations
// ─────────────────────────────────────────────────────────────────────────────
void tareScales() {
  // 16 samples at 20 SPS ≈ 800 ms of averaging for a clean zero.
  scale.calculateZeroOffset(16);
  sys.weight = 0.0f;  // reset state to match new zero immediately
  sys.scalesTared = true;
  scaleBufN = 0;      // discard partial window captured before tare
}

void calibrateScale(float knownWeight) {
  // 32 samples at 20 SPS ≈ 1.6 s averaging — enough to suppress noise.
  scale.calculateCalibrationFactor(knownWeight, 32);
  float newCal = scale.getCalibrationFactor();
  Serial.print("NEW_CAL:"); Serial.println(newCal, 4);
  scaleBufN = 0;
}

// ─────────────────────────────────────────────────────────────────────────────
// Auto-prime helpers
// ─────────────────────────────────────────────────────────────────────────────
void startPrimingBrew() {
  sys.state      = STATE_PRIMING_BREW;
  primeStartTime = millis();
}

void startPrimingSteam() {
  sys.state      = STATE_PRIMING_STEAM;
  primeStartTime = millis();
}

// ─────────────────────────────────────────────────────────────────────────────
// Stop / safe-off helpers
// ─────────────────────────────────────────────────────────────────────────────
void stopCurrentOperation() {
  sys.state = STATE_IDLE;
  safeOff();
  sys.scalesTared = false;
  sys.brewTimer   = 0;
  sys.pidIntegral  = 0.0;
  sys.pidLastError = 0.0;
  gReplayMode = false;            // exit replay mode (curve stays loaded)
}

void safeOff() {
  digitalWrite(PUMP_ENA_PIN,    LOW);   // Gate pump OFF first
  analogWrite(PUMP_PWM_PIN,     0);
  analogWrite(HEATER_BREW_PIN,  0);
  digitalWrite(HEATER_STEAM_PIN, LOW);
  setValve(VALVE_THERMOBLOCK_PIN, false);  // thermoblock → drain
  setValve(VALVE_PUMP_PIN,        false);  // V1 LOW (de-energised); pump is off so routing doesn't matter
  sys.heaterBrewOn  = false;
  sys.heaterSteamOn = false;
}

// ─────────────────────────────────────────────────────────────────────────────
// Pressure mapping
// ─────────────────────────────────────────────────────────────────────────────
float mapPressure(float voltage) {
  if (voltage < calibratedVZero) voltage = calibratedVZero;
  return ((voltage - calibratedVZero) / (V_MAX - calibratedVZero)) * (P_MAX - P_MIN) + P_MIN;
}

// ─────────────────────────────────────────────────────────────────────────────
// Telemetry output
// Fields: state,brewTemp,steamTemp,pressure,weight,pump%,valveThermoblock,
//         valvePump,heaterBrew,heaterSteam,brewTimer,scalesTared,heatersEnabled
// ─────────────────────────────────────────────────────────────────────────────
void sendTelemetry() {
  unsigned long now = millis();
  if (now - lastSerialSend < TELEMETRY_INTERVAL) return;
  lastSerialSend = now;

  Serial.print("DATA:");
  Serial.print(sys.state);                                       Serial.print(",");
  Serial.print(sys.brewTempActual,  1);                          Serial.print(",");
  Serial.print(sys.steamTempActual, 1);                          Serial.print(",");
  Serial.print(sys.pressure,        2);                          Serial.print(",");
  Serial.print(sys.weight,          1);                          Serial.print(",");
  Serial.print(map(sys.pumpPower, 0, 255, 0, 100));              Serial.print(",");
  Serial.print(sys.valveThermoblockOpen ? 1 : 0);                Serial.print(",");  // VALVE2
  Serial.print(sys.valvePumpOpen        ? 1 : 0);                Serial.print(",");  // VALVE1
  Serial.print(sys.heaterBrewOn         ? 1 : 0);                Serial.print(",");
  Serial.print(sys.heaterSteamOn        ? 1 : 0);                Serial.print(",");

  if (sys.state == STATE_BREWING && sys.brewTimer > 0) {
    Serial.print((now - sys.brewTimer) / 1000);
  } else {
    Serial.print(0);
  }
  Serial.print(",");
  Serial.print(sys.scalesTared ? 1 : 0);
  Serial.print(",");
  Serial.print(sys.heatersEnabled ? 1 : 0);
  Serial.print(",");
  Serial.print((int)sys.brewPhase);  // 0=preinfuse, 1=ramp, 2=hold, 3=extract
  Serial.print(",");
  Serial.print(sys.boilerPrimed ? 1 : 0);          // field 15
  Serial.print(",");
  Serial.print(sys.boilerPreheatComplete ? 1 : 0); // field 16
  Serial.print(",");
  Serial.print(sys.autoBrewMode ? 1 : 0);          // field 17
  Serial.println();
}

// ─────────────────────────────────────────────────────────────────────────────
// Status response
// ─────────────────────────────────────────────────────────────────────────────
void sendStatus() {
  Serial.print("STATUS:");
  Serial.print("state=");      Serial.print(sys.state);               Serial.print(",");
  Serial.print("brewTemp=");   Serial.print(sys.brewTempActual,  1);  Serial.print(",");
  Serial.print("steamTemp=");  Serial.print(sys.steamTempActual, 1);  Serial.print(",");
  Serial.print("brewSP=");     Serial.print(sys.brewTemp,        1);  Serial.print(",");
  Serial.print("steamSP=");    Serial.print(sys.steamTemp,       1);  Serial.print(",");
  Serial.print("pressure=");   Serial.print(sys.pressure,        2);  Serial.print(",");
  Serial.print("weight=");     Serial.print(sys.weight,          1);  Serial.print(",");
  Serial.print("pump=");       Serial.print(map(sys.pumpPower, 0, 255, 0, 100)); Serial.print(",");
  Serial.print("valveTB=");    Serial.print(sys.valveThermoblockOpen ? 1 : 0);   Serial.print(",");
  Serial.print("valvePump=");  Serial.print(sys.valvePumpOpen        ? 1 : 0);   Serial.print(",");
  Serial.print("heaterBrew="); Serial.print(sys.heaterBrewOn   ? 1 : 0);         Serial.print(",");
  Serial.print("heaterSteam=");Serial.print(sys.heaterSteamOn  ? 1 : 0);
  Serial.println();
}
