mklod/silvia-lever/ui/source/qml_backend.py

# Last modified: 2026-06-16--1348
from PyQt6.QtCore import QObject, pyqtSignal, pyqtSlot, QTimer
import config
from safety_manager import SafetyManager
from data_logger import DataLogger
from temperature_controller import TemperatureController
from settings_manager import SettingsManager
from brew_recorder import BrewRecorder
import atexit
import os


def _get_serial_manager_class():
    """Pick real vs mock at call time so --mock set after imports works."""
    if config.USE_MOCK_SERIAL:
        from serialcom.mock_serial_manager import SerialManager
    else:
        from serialcom.real_serial_manager import SerialManager
    return SerialManager

class CoffeeController(QObject):
    # Signals to QML
    brewTempChanged = pyqtSignal(float)    # Thermoblock actual temperature
    steamTempChanged = pyqtSignal(float)   # Steam boiler actual temperature
    pressureChanged = pyqtSignal(float)
    weightChanged = pyqtSignal(float)
    pumpPowerChanged = pyqtSignal(float)
    valvePumpChanged = pyqtSignal(bool)         # V1: false=thermoblock, true=boiler
    valveThermoblockChanged = pyqtSignal(bool)  # V2: false=drain, true=portafilter
    stateChanged = pyqtSignal(str)
    brewTimeChanged = pyqtSignal(str)
    errorOccurred = pyqtSignal(str)
    warningIssued = pyqtSignal(str)
    connectionStatusChanged = pyqtSignal(bool)
    heatingStatusChanged = pyqtSignal(bool)
    scalesSettledChanged = pyqtSignal(bool)
    scalesTaredChanged = pyqtSignal(bool)
    targetTemperaturesChanged = pyqtSignal(float, float)
    heatersEnabledChanged = pyqtSignal(bool)
    autoBrewModeChanged = pyqtSignal(bool)
    profilesChanged = pyqtSignal(list)         # full list of profile names
    activeProfileChanged = pyqtSignal(int, str)  # (index, name)
    shotsChanged = pyqtSignal(list)            # saved shots for history/replay
    doseChanged = pyqtSignal(float)            # basket dose (g) — drives RATIO
    boilerPrimedChanged = pyqtSignal(bool)     # boiler tank filled / dry-fire gate
    boilerPreheatedChanged = pyqtSignal(bool)  # boiler first reached steam temp
    autotuneLineReceived = pyqtSignal(str)  # raw firmware line: AUTOTUNE:... or AUTOTUNE_RESULT:...
    
    def __init__(self, parent=None):
        super().__init__(parent)
        
        # Initialize components
        self.logger = DataLogger()
        self.safety = SafetyManager()
        self.temp_controller = TemperatureController()
        
        # Serial communication
        SerialManager = _get_serial_manager_class()
        if config.USE_MOCK_SERIAL:
            self.serial = SerialManager()
        else:
            self.serial = SerialManager(port=config.SERIAL_PORT, baud_rate=config.SERIAL_BAUD)
        self.serial.line_received.connect(self._handle_serial_data)
        self.connected = False
        self._current_state = "IDLE"
        self._heaters_enabled = False  # mirrors firmware; UI-controlled master switch
        self._brew_phase = "extract"   # mirrors firmware sub-state during BREWING
        self._auto_brew_mode = False   # mirrors firmware autoBrewMode flag
        self._profiles = []            # brew-profile names, learned from firmware
        self._profile_index = 0        # active profile index
        self._boiler_primed = False    # mirrors firmware boilerPrimed
        self._boiler_preheated = False # mirrors firmware boilerPreheatComplete
        
        # Connect safety signals
        self.safety.emergencyStop.connect(self._emergency_stop)
        self.safety.warningIssued.connect(self._handle_warning)
        
        # Connect temperature controller
        self.temp_controller.heaterStateChanged.connect(self._handle_heater_change)
        self.temp_controller.targetReached.connect(self._handle_target_reached)
        
        # Brew timer
        self._brew_start_time = None
        self._brewing = False  # True only between beginBrew and stopBrew; gates
                               # duration logging so a stop after the brew already
                               # ended doesn't log a bogus cumulative session.
        self._timer = QTimer()
        self._timer.timeout.connect(self._update_brew_time)
        
        # Scales settling detection
        self._weight_history = []
        self._scales_settled = False
        
        # Load saved settings
        self.settings_manager = SettingsManager()
        saved_settings = self.settings_manager.load_settings()
        self._brew_target_temp = saved_settings["brew_temp"]
        self._steam_target_temp = saved_settings["steam_temp"]
        self._dose_g = saved_settings.get("dose", 20.0)
        self._scale_cal = saved_settings.get("scale_cal", 420.0)
        # Guard: cal must be positive and in a plausible range.
        # Negative → raw/weight polarity inverted (library bug or bad cal).
        # <1 or >100000 → not a real cal factor for this load cell.
        if not self._scale_cal or self._scale_cal <= 0 or self._scale_cal > 100000:
            self._scale_cal = 420.0

        # PID gains (optional; default None → firmware keeps its config.h defaults).
        kp = saved_settings.get("pid_kp")
        ki = saved_settings.get("pid_ki")
        kd = saved_settings.get("pid_kd")
        self._pid_gains = (kp, ki, kd) if (kp is not None) else None

        # Per-brew JSON recorder (substrate for upcoming auto-profile system).
        # Each brew lands in ui/source/brew_logs/brew_YYYY-MM-DD_HH-MM-SS.json.
        brew_logs_dir = os.path.join(os.path.dirname(__file__), "brew_logs")
        self.brew_recorder = BrewRecorder(brew_logs_dir)
        
        # Connection watchdog
        self._connection_timer = QTimer()
        self._connection_timer.timeout.connect(self._check_connection)
        self._connection_timer.start(5000)  # Check every 5 seconds
        
        # Register shutdown handler
        atexit.register(self._shutdown)
        
        try:
            self.serial.start()
            self.connected = True
            self.logger.log_command("System started")
            
            # Delay signal emission to ensure QML is ready
            QTimer.singleShot(100, lambda: self.connectionStatusChanged.emit(True))
            QTimer.singleShot(200, lambda: self.targetTemperaturesChanged.emit(self._brew_target_temp, self._steam_target_temp))
            QTimer.singleShot(250, lambda: self.doseChanged.emit(self._dose_g))
            
            # Priming is triggered from QML when user enters brew screen

            # Restore scale calibration
            QTimer.singleShot(400, self._restore_scale_calibration)
            # Push persisted brew/steam setpoints so saved defaults take effect on boot
            QTimer.singleShot(500, self._restore_temperatures)
            # Restore persisted PID gains (if any), after firmware's had time to boot
            QTimer.singleShot(600, self._restore_pid_gains)
            # Ask firmware for its brew-profile list (populates the UI picker)
            QTimer.singleShot(800, self._request_profiles)
        except Exception as e:
            self.logger.log_error(f"Failed to start serial: {e}")
            self.connected = False
            QTimer.singleShot(100, lambda: self.connectionStatusChanged.emit(False))
        
    @pyqtSlot(float, float)
    def setTemperatures(self, brew_temp, steam_temp):
        # Apply safety limits
        brew_temp = max(60, min(110, brew_temp))
        steam_temp = max(110, min(150, steam_temp))
        
        self._brew_target_temp = brew_temp
        self._steam_target_temp = steam_temp
        
        self.temp_controller.set_brew_target(brew_temp)
        self.temp_controller.set_steam_target(steam_temp)
        
        # Save settings to file
        self.settings_manager.save_settings(brew_temp, steam_temp)
        
        self.targetTemperaturesChanged.emit(brew_temp, steam_temp)
        
        if self.connected:
            self.serial.send_command(f"SET_TEMP BREW {brew_temp}")
            self.serial.send_command(f"SET_TEMP STEAM {steam_temp}")
            self.logger.log_command(f"SET_TEMP BREW {brew_temp} STEAM {steam_temp}")
        else:
            self.logger.log_error("Cannot set temperature - not connected")
        
    @pyqtSlot()
    def startBrew(self):
        if not self.connected:
            self.errorOccurred.emit("Cannot start brew - not connected")
            return
            
        # Stop current operation first
        if hasattr(self, '_current_state') and self._current_state != "IDLE":
            self.serial.send_command("STOP")
            self.logger.log_command("Stopping current operation for brew")
            # Delay to allow Arduino state transition
            QTimer.singleShot(100, self._delayed_start_brew)
        else:
            self._delayed_start_brew()
            
    def _delayed_start_brew(self):
        self.temp_controller.set_mode("BREW")
        self.safety.start_brew_timer()
        
        self.serial.send_command("START_BREW")
        self.logger.log_command("START_BREW")
        
    @pyqtSlot()
    def beginBrew(self):
        """Called when user presses BREW NOW - implements exact sequence"""
        if not self.connected:
            self.errorOccurred.emit("Cannot begin brew - not connected")
            return
            
        self.logger.log_command("BREW NOW Button pressed - starting sequence")
        
        self._tare_and_start_brewing()
        
    def _tare_and_start_brewing(self):
        """Step 2: TARE scales, then begin brewing with all simultaneous actions"""
        
        # Step 3: Begin brewing (valve opens, pump starts)
        self.serial.send_command("BEGIN_BREW")
        
        # Step 4: Timer begins counting
        import time
        self._brew_start_time = time.time()
        self._brewing = True
        self._timer.start(500)
        
        # # Step 5: Live data reporting begins (charts already updating via telemetry)
        # self.logger.log_command("Brewing started - timer running, valve open, pump active, live data reporting")
        
    @pyqtSlot()
    def stopBrew(self):
        # Always send STOP to the firmware (idempotent + safe — covers leaving
        # the screen via the back arrow regardless of UI state).
        if self.connected:
            self.serial.send_command("STOP")
            self.logger.log_command("STOP")

        self.temp_controller.set_mode("IDLE")
        self.safety.stop_brew_timer()
        self._timer.stop()

        # Log the session ONLY if a brew was actually running. Without this
        # guard, a second stopBrew (e.g. back arrow after the brew already
        # ended) re-logged a bogus BREW_COMPLETE whose duration kept growing
        # because _brew_start_time is never reset (46s then 54s for one shot —
        # incident 2026-06-10).
        if self._brewing and self._brew_start_time:
            import time
            duration = int(time.time() - self._brew_start_time)
            self.logger.log_brew_session(duration, 0, 0)  # TODO: Add actual weight/pressure
        self._brewing = False

        # Keep brew time displayed (frozen at final), don't reset to 00:00.
        # self._brew_start_time = None
        # self.brewTimeChanged.emit("00:00")
        
    @pyqtSlot()
    def startSteam(self):
        if not self.connected:
            self.errorOccurred.emit("Cannot start steam - not connected")
            return
            
        # Stop current operation first
        if hasattr(self, '_current_state') and self._current_state != "IDLE":
            self.serial.send_command("STOP")
            self.logger.log_command("Stopping current operation for steam")
            # Delay to allow Arduino state transition
            QTimer.singleShot(100, self._delayed_start_steam)
        else:
            self._delayed_start_steam()
            
    def _delayed_start_steam(self):
        self.temp_controller.set_mode("STEAM")
        self.safety.start_steam_timer()
        
        self.serial.send_command("START_STEAM")
        self.logger.log_command("START_STEAM")
        
    @pyqtSlot()
    def stopSteam(self):
        if self.connected:
            self.serial.send_command("STOP")
            self.logger.log_command("STOP")
            
        self.temp_controller.set_mode("IDLE")
        self.safety.stop_steam_timer()
        
    @pyqtSlot()
    def startFlush(self):
        if not self.connected:
            self.errorOccurred.emit("Cannot start flush - not connected")
            return
            
        # Stop current operation first
        if hasattr(self, '_current_state') and self._current_state != "IDLE":
            self.serial.send_command("STOP")
            self.logger.log_command("Stopping current operation for flush")
            # Delay to allow Arduino state transition
            QTimer.singleShot(100, self._delayed_start_flush)
        else:
            self._delayed_start_flush()
            
    def _delayed_start_flush(self):
        self.serial.send_command("START_FLUSH")
        self.logger.log_command("START_FLUSH")
        
    @pyqtSlot()
    def stopFlush(self):
        if self.connected:
            self.serial.send_command("STOP")
            self.logger.log_command("STOP")
            
    @pyqtSlot()
    def primeBoiler(self):
        """Start filling the boiler tank (pump → boiler). User watches for
        overflow, then calls primeDone(). Dry-fire gate: the boiler element
        will not energize until this completes. Best done cold at startup."""
        if not self.connected:
            self.errorOccurred.emit("Cannot prime boiler - not connected")
            return
        if hasattr(self, '_current_state') and self._current_state != "IDLE":
            self.serial.send_command("STOP")
            QTimer.singleShot(100, lambda: self.serial.send_command("PRIME_BOILER"))
        else:
            self.serial.send_command("PRIME_BOILER")
        self.logger.log_command("PRIME_BOILER")

    @pyqtSlot()
    def beginSteam(self):
        """Called when steam temperature is ready and user presses BEGIN STEAM"""
        if not self.connected:
            self.errorOccurred.emit("Cannot begin steam - not connected")
            return

        self.serial.send_command("BEGIN_STEAM")
        self.logger.log_command("BEGIN_STEAM")
        
    def _handle_serial_data(self, line):
        self.safety.update_data_timestamp()
        self.logger.log_response(line)
        
        if line.startswith("DATA:"):
            # New packet format (12 fields):
            # DATA:state,brewTemp,steamTemp,pressure,weight,pump%,valveTB,valveBoiler,heaterBrew,heaterSteam,brewTimer,scalesTared
            try:
                parts = line[5:].split(',')
                if len(parts) < 10:
                    return

                state_num    = int(parts[0])
                brew_temp    = float(parts[1])
                steam_temp   = float(parts[2])
                pressure     = float(parts[3])
                weight       = float(parts[4])
                pump_percent = int(parts[5])
                valve_tb     = bool(int(parts[6])) if len(parts) > 6 else False
                valve_pump   = bool(int(parts[7])) if len(parts) > 7 else False
                brew_time    = int(parts[10]) if len(parts) > 10 else 0
                scales_tared = bool(int(parts[11])) if len(parts) > 11 else False

                state_names = [
                    "IDLE",
                    "PRIMING_BREW", "HEATING_BREW",
                    "PRIMING_STEAM", "HEATING_STEAM",
                    "BREWING", "STEAMING", "FLUSHING"
                ]
                state = state_names[state_num] if state_num < len(state_names) else "UNKNOWN"
                prev_state = self._current_state
                self._current_state = state

                # Per-brew JSON recorder: detect IDLE↔BREWING transitions
                # and stream samples while brewing. Substrate for upcoming
                # auto-profile system (profiles will be derived from / replayed
                # against these recordings).
                if state == "BREWING" and prev_state != "BREWING":
                    self.brew_recorder.start(
                        brew_temp_setpoint=self._brew_target_temp,
                        steam_temp_setpoint=self._steam_target_temp,
                        pid_gains=self._pid_gains,
                        scale_cal=self._scale_cal,
                    )
                    self.logger.log_command("Brew recording started")
                elif prev_state == "BREWING" and state != "BREWING":
                    completed = (state == "IDLE")
                    saved = self.brew_recorder.finish(completed_normally=completed)
                    if saved:
                        self.logger.log_command(f"Brew recording saved: {saved}")
                if state == "BREWING":
                    self.brew_recorder.add_sample(
                        weight_g=weight,
                        pressure_bar=pressure,
                        brew_temp_c=brew_temp,
                        pump_percent=pump_percent,
                        valve_pump=valve_pump,
                        valve_thermoblock=valve_tb,
                        phase=self._brew_phase,
                    )

                # Heaters enable flag (field 12 — new since 2026-04-22).
                # Older firmware won't send it; default to False if missing.
                heaters_enabled = bool(int(parts[12])) if len(parts) > 12 else False
                if heaters_enabled != self._heaters_enabled:
                    self._heaters_enabled = heaters_enabled
                    self.heatersEnabledChanged.emit(heaters_enabled)

                # Brew phase (field 13). 0=preinfuse, 1=ramp, 2=hold, 3=extract.
                brew_phase = int(parts[13]) if len(parts) > 13 else 3
                phase_names = ("preinfuse", "ramp", "hold", "extract")
                phase_name = phase_names[brew_phase] if 0 <= brew_phase < len(phase_names) else "?"
                self._brew_phase = phase_name

                # Boiler prime / preheat (fields 15, 16 — new for Stage 9).
                # Older firmware won't send them; default False if missing.
                boiler_primed = bool(int(parts[14])) if len(parts) > 14 else False
                if boiler_primed != self._boiler_primed:
                    self._boiler_primed = boiler_primed
                    self.boilerPrimedChanged.emit(boiler_primed)
                boiler_preheated = bool(int(parts[15])) if len(parts) > 15 else False
                if boiler_preheated != self._boiler_preheated:
                    self._boiler_preheated = boiler_preheated
                    self.boilerPreheatedChanged.emit(boiler_preheated)

                # Auto-brew mode (field 17 — firmware default now AUTO). Keeps
                # the UI's BREW: AUTO/MAN button in sync with firmware truth.
                auto_mode = bool(int(parts[16])) if len(parts) > 16 else False
                if auto_mode != self._auto_brew_mode:
                    self._auto_brew_mode = auto_mode
                    self.autoBrewModeChanged.emit(auto_mode)

                # Safety checks on both temperatures
                if not self.safety.check_temperature(brew_temp):
                    return
                if not self.safety.check_temperature(steam_temp):
                    return

                # Update temperature controller with both readings
                self.temp_controller.update_brew_temperature(brew_temp)
                self.temp_controller.update_steam_temperature(steam_temp)

                # Log sensor data (use brew temp as primary for logging)
                self.logger.log_sensor_data(brew_temp, pressure, weight, state, pump_percent)

                # Check scales settling
                self._check_scales_settling(weight)

                # Emit to QML
                self.stateChanged.emit(state)
                self.brewTempChanged.emit(brew_temp)
                self.steamTempChanged.emit(steam_temp)
                self.pressureChanged.emit(pressure)
                self.weightChanged.emit(weight)
                self.pumpPowerChanged.emit(float(pump_percent))
                self.valvePumpChanged.emit(valve_pump)
                self.valveThermoblockChanged.emit(valve_tb)
                self.scalesTaredChanged.emit(scales_tared)

            except Exception as e:
                self.logger.log_error(f"Failed to parse DATA: {line} - {e}")
        elif line.startswith("NEW_CAL:"):
            # Handle NAU7802 calibration response: NEW_CAL:<factor>
            # Valid range: positive, ≥1, ≤100000.
            try:
                new_cal = float(line[8:])
                if new_cal <= 0 or new_cal < 1.0 or new_cal > 100000:
                    reason = ("negative" if new_cal < 0
                              else "too small" if abs(new_cal) < 1.0
                              else "too large")
                    self.logger.log_error(f"Cal result invalid ({new_cal}, {reason}) — rejected, restoring {self._scale_cal}")
                    self.serial.send_command(f"SET_SCALE_CAL {self._scale_cal}")
                    self.errorOccurred.emit(f"Cal failed: factor {new_cal:.3f} {reason}. Previous cal {self._scale_cal:.1f} restored.")
                else:
                    self._scale_cal = new_cal
                    self.settings_manager.save_settings(self._brew_target_temp, self._steam_target_temp, self._scale_cal)
                    self.logger.log_command(f"Scale calibration updated: {self._scale_cal}")
            except Exception as e:
                self.logger.log_error(f"Failed to parse calibration: {line} - {e}")
        elif line.startswith("STATUS:"):
            # STATUS: key=value,... response — parse for logging only
            try:
                self.logger.log_response(line)
            except Exception as e:
                self.logger.log_error(f"Failed to parse STATUS: {line} - {e}")
        elif line.startswith("ERROR"):
            self.logger.log_error(line)
            # Benign at startup: the serial RX buffer often carries partial /
            # stale bytes across a flash; firmware parses them as unknown
            # commands. Log, don't pester the user with a dialog.
            if "UNKNOWN_COMMAND" not in line:
                self.errorOccurred.emit(line)
        elif line.startswith("AUTOTUNE"):
            self.logger.log_response(line)
            self.autotuneLineReceived.emit(line)
            # On successful completion, persist the auto-applied TL gains so
            # they survive reconnect (firmware resets gains to config.h defaults
            # on every boot).
            if line.startswith("AUTOTUNE_RESULT:") and "applied=TL" in line:
                try:
                    tl_segment = line.split("TL=", 1)[1].split(",", 1)[0]
                    parts = tl_segment.split("/")
                    kp = float(parts[0]); ki = float(parts[1]); kd = float(parts[2])
                    self._pid_gains = (kp, ki, kd)
                    self.settings_manager.save_settings(
                        self._brew_target_temp, self._steam_target_temp,
                        self._scale_cal, pid=self._pid_gains)
                    self.logger.log_command(f"Autotune applied + persisted: Kp={kp} Ki={ki} Kd={kd}")
                except Exception as e:
                    self.logger.log_error(f"Failed to parse AUTOTUNE_RESULT: {line} - {e}")
        elif line.startswith("OK:PROFILE_COUNT:"):
            # End of the GET_PROFILES listing — publish the list, and the
            # currently-active profile name so the UI picker shows something.
            self.profilesChanged.emit(list(self._profiles))
            if 0 <= self._profile_index < len(self._profiles):
                self.activeProfileChanged.emit(
                    self._profile_index, self._profiles[self._profile_index])
        elif line.startswith("OK:PROFILE:"):
            # SET_PROFILE confirmation: OK:PROFILE:<idx>:<name>
            try:
                parts = line.split(":", 3)
                idx, name = int(parts[2]), parts[3]
                self._profile_index = idx
                self.activeProfileChanged.emit(idx, name)
            except Exception as e:
                self.logger.log_error(f"bad OK:PROFILE line: {line} - {e}")
        elif line.startswith("PROFILE:"):
            # GET_PROFILES listing line: PROFILE:<idx>:<name>
            try:
                _, idx_s, name = line.split(":", 2)
                idx = int(idx_s)
                while len(self._profiles) <= idx:
                    self._profiles.append("")
                self._profiles[idx] = name
            except Exception as e:
                self.logger.log_error(f"bad PROFILE line: {line} - {e}")
        elif line.startswith("READY") or line.startswith("PONG"):
            self.logger.log_command(f"Received: {line}")
                    
    def _update_brew_time(self):
        if self._brew_start_time:
            import time
            elapsed_ms = int((time.time() - self._brew_start_time) * 1000)
            total_seconds = elapsed_ms // 1000
            minutes = total_seconds // 60
            seconds = total_seconds % 60
            self.brewTimeChanged.emit(f"{minutes:02}:{seconds:02}")
            
    def _emergency_stop(self, reason):
        """Handle emergency stop from safety manager"""
        self.logger.log_safety_event(f"EMERGENCY STOP: {reason}")
        self.errorOccurred.emit(f"EMERGENCY STOP: {reason}")
        
        # Stop all operations
        if self.connected:
            self.serial.send_command("ABORT")
            
        self.temp_controller.set_mode("IDLE")
        self.safety.stop_brew_timer()
        self.safety.stop_steam_timer()
        self._timer.stop()
        
    def _handle_warning(self, warning):
        self.logger.log_warning(warning)
        self.warningIssued.emit(warning)
        
    def _handle_heater_change(self, heating):
        self.heatingStatusChanged.emit(heating)
        # Arduino controls heater internally based on temperature
            
    def _handle_target_reached(self, mode):
        self.logger.log_command(f"Target temperature reached for {mode}")
        
    def _check_connection(self):
        if self.connected and self.serial:
            try:
                self.serial.send_command("PING")
                # Should wait for PONG response or implement timeout
            except Exception as e:
                self.connected = False
                self.connectionStatusChanged.emit(False)
                self.logger.log_error(f"Connection lost: {e}")
                self._attempt_reconnection()
                
    def _attempt_reconnection(self):
        """Try to reconnect after connection loss"""
        try:
            self.logger.log_command("Attempting reconnection...")
            if self.serial:
                self.serial.stop()
            SerialManager = _get_serial_manager_class()
            if config.USE_MOCK_SERIAL:
                self.serial = SerialManager()
            else:
                self.serial = SerialManager(port=config.SERIAL_PORT, baud_rate=config.SERIAL_BAUD)
            self.serial.line_received.connect(self._handle_serial_data)
            if self.serial.start():
                self.connected = True
                self.connectionStatusChanged.emit(True)
                self.logger.log_command("Reconnection successful")
            else:
                self.logger.log_error("Reconnection failed")
        except Exception as e:
            self.logger.log_error(f"Reconnection error: {e}")

    def _shutdown(self):
        """Clean shutdown procedure"""
        try:
            if hasattr(self, 'logger') and self.logger:
                self.logger.log_command("Initiating shutdown")

            # Stop all operations
            if hasattr(self, 'connected') and self.connected and hasattr(self, 'serial') and self.serial:
                self.serial.send_command("ABORT")
                self.serial.stop()
                
            if hasattr(self, 'temp_controller') and self.temp_controller:
                self.temp_controller.set_mode("IDLE")
            if hasattr(self, '_timer') and self._timer:
                self._timer.stop()
            if hasattr(self, '_connection_timer') and self._connection_timer:
                self._connection_timer.stop()
            
            if hasattr(self, 'logger') and self.logger:
                self.logger.shutdown()
        except RuntimeError:
            # Qt objects already deleted, ignore
            pass
    def _check_scales_settling(self, weight):
        """Check if scales have settled to a stable reading"""
        self._weight_history.append(weight)
        
        # Keep only last 10 readings
        if len(self._weight_history) > 10:
            self._weight_history.pop(0)
            
        # Check if we have enough readings
        if len(self._weight_history) < 5:
            return
            
        # Check if weight is stable (within 0.2g for last 5 readings)
        recent_weights = self._weight_history[-5:]
        weight_range = max(recent_weights) - min(recent_weights)
        settled = weight_range <= 5
        
        if settled != self._scales_settled:
            self._scales_settled = settled
            self.scalesSettledChanged.emit(settled)
        
    @pyqtSlot()
    def primeDone(self):
        """User confirmed overflow — tell firmware to stop pump and start heating."""
        if self.connected:
            self.serial.send_command("PRIME_DONE")
            self.logger.log_command("PRIME_DONE")
        else:
            self.errorOccurred.emit("Cannot confirm prime - not connected")

    @pyqtSlot(bool)
    def setHeatersEnabled(self, enabled):
        """Master runtime switch for both SSRs. Firmware defaults OFF at boot."""
        if self.connected:
            self.serial.send_command(f"SET_HEATERS_ENABLE {1 if enabled else 0}")
            self.logger.log_command(f"SET_HEATERS_ENABLE {1 if enabled else 0}")
        else:
            self.errorOccurred.emit("Cannot toggle heaters - not connected")

    def _request_profiles(self):
        """Ask firmware to list its brew profiles (populates the UI picker)."""
        if self.connected:
            self._profiles = []
            self.serial.send_command("GET_PROFILES")

    @pyqtSlot(int)
    def setProfile(self, index):
        """Select the active brew profile by index. Firmware echoes
        OK:PROFILE:<idx>:<name>, which updates the UI via activeProfileChanged."""
        if self.connected:
            self.serial.send_command(f"SET_PROFILE {index}")
            self.logger.log_command(f"SET_PROFILE {index}")
        else:
            self.errorOccurred.emit("Cannot set profile - not connected")

    @pyqtSlot()
    def cycleProfile(self):
        """Advance to the next brew profile, wrapping. No-op until the
        profile list has been received from firmware."""
        if not self._profiles:
            return
        nxt = (self._profile_index + 1) % len(self._profiles)
        self.setProfile(nxt)

    @pyqtSlot(bool)
    def setAutoBrewMode(self, auto):
        """Toggle the firmware's auto-preinfuse sequence on/off.
        AUTO  = full PREINFUSE → RAMP → HOLD with manual takeover via pot.
        MANUAL = brew enters EXTRACT immediately, pot drives PWM from t=0.
        Firmware defaults to MANUAL at boot."""
        if self.connected:
            self.serial.send_command(f"SET_AUTO_MODE {1 if auto else 0}")
            self.logger.log_command(f"SET_AUTO_MODE {1 if auto else 0}")
            self._auto_brew_mode = auto
            self.autoBrewModeChanged.emit(auto)
        else:
            self.errorOccurred.emit("Cannot toggle auto mode - not connected")

    @pyqtSlot()
    def heatBrew(self):
        """Kick firmware into HEATING_BREW without pumping. Called on brew screen enter."""
        if self.connected:
            self.serial.send_command("HEAT_BREW")
            self.logger.log_command("HEAT_BREW")

    @pyqtSlot()
    def heatSteam(self):
        """Kick firmware into HEATING_STEAM without pumping. Called on steam overlay open."""
        if self.connected:
            self.serial.send_command("HEAT_STEAM")
            self.logger.log_command("HEAT_STEAM")

    @pyqtSlot()
    def startAutotune(self):
        """Kick off relay-feedback autotune. Progress + result come back via autotuneLineReceived."""
        if self.connected:
            self.serial.send_command("AUTOTUNE_START")
            self.logger.log_command("AUTOTUNE_START")

    @pyqtSlot()
    def stopAutotune(self):
        """Abort a running autotune."""
        if self.connected:
            self.serial.send_command("AUTOTUNE_STOP")
            self.logger.log_command("AUTOTUNE_STOP")

    @pyqtSlot(result=bool)
    def heatersEnabled(self):
        return self._heaters_enabled

    @pyqtSlot()
    def tareScales(self):
        """Tare the scales"""
        if self.connected:
            self.serial.send_command("TARE_SCALES")
            self.logger.log_command("TARE_SCALES")
        else:
            self.errorOccurred.emit("Cannot tare scales - not connected")
            
    @pyqtSlot(float)
    def calibrateScales(self, knownWeight):
        """Calibrate scales with known weight"""
        if self.connected:
            self.serial.send_command(f"CAL_SCALE {knownWeight}")
            self.logger.log_command(f"CAL_SCALE {knownWeight}")
        else:
            self.errorOccurred.emit("Cannot calibrate scales - not connected")
            
    def _restore_scale_calibration(self):
        """Restore saved NAU7802 calibration on startup"""
        if self.connected:
            self.serial.send_command(f"SET_SCALE_CAL {self._scale_cal}")
            self.logger.log_command(f"Restored scale calibration: {self._scale_cal}")

    def _restore_pid_gains(self):
        """Re-apply persisted PID gains (from prior autotune) on reconnect."""
        if self.connected and self._pid_gains and self._pid_gains[0] is not None:
            kp, ki, kd = self._pid_gains
            self.serial.send_command(f"SET_PID {kp} {ki} {kd}")
            self.logger.log_command(f"Restored PID gains: kp={kp} ki={ki} kd={kd}")

    def _restore_temperatures(self):
        """Push persisted brew/steam setpoints to the firmware on connect, so the
        saved defaults actually take effect on startup (the firmware otherwise
        keeps its own config.h defaults until the user opens the setpoint popup).
        Mirrors the scale-cal / PID restore above."""
        if self.connected:
            self.serial.send_command(f"SET_TEMP BREW {self._brew_target_temp}")
            self.serial.send_command(f"SET_TEMP STEAM {self._steam_target_temp}")
            self.logger.log_command(
                f"Restored setpoints: BREW {self._brew_target_temp} "
                f"STEAM {self._steam_target_temp}")

    def _apply_heaters_off(self):
        """DEV: force heaters OFF on startup (unattended-reboot safety)."""
        if self.connected:
            self.serial.send_command("SET_HEATERS_ENABLE 0")
            self.logger.log_command("Startup: heaters OFF (dev default)")

    @pyqtSlot()
    def requestShots(self):
        """Scan brew_logs/ and emit the saved shots (newest first) for the
        history/replay screen. Each shot carries summary stats + the recorded
        mass/pressure curves so the detail charts and replay can render."""
        import glob, json, datetime
        DOSE = 18.0
        shots = []
        try:
            files = sorted(glob.glob(os.path.join(self.brew_recorder.output_dir, "*.json")),
                           reverse=True)
        except Exception:
            files = []
        today = datetime.date.today()
        for f in files[:40]:
            try:
                rec = json.load(open(f))
            except Exception:
                continue
            s = rec.get("samples", [])
            if not s:
                continue
            finw = rec.get("final_weight_g", 0) or 0
            maxp = rec.get("max_pressure_bar", 0) or 0
            dur = rec.get("duration_s", s[-1]["t_s"])
            mm, sec = int(dur) // 60, int(dur) % 60
            ratio = "1:%.1f" % (finw / DOSE) if finw else "—"
            # date / time from started_at (UTC ISO) → local
            date_s, time_s = "Shot", ""
            try:
                local = datetime.datetime.fromisoformat(rec["started_at"]).astimezone()
                d = local.date()
                if d == today:
                    date_s = "Today"
                elif d == today - datetime.timedelta(days=1):
                    date_s = "Yesterday"
                else:
                    date_s = local.strftime("%b %-d")
                time_s = local.strftime("%H:%M")
            except Exception:
                pass
            stepc = max(1, len(s) // 120)
            stepk = max(1, len(s) // 40)
            mass = [{"t": x["t_s"], "v": x["weight_g"]} for x in s[::stepc]]
            press = [{"t": x["t_s"], "v": x["pressure_bar"]} for x in s[::stepc]]
            spark = [[x["t_s"], x["pressure_bar"]] for x in s[::stepk]]
            shots.append({
                "date": date_s, "time": time_s, "profile": "—",
                "meta": "%.1fg · %s · %d:%02d" % (finw, ratio, mm, sec),
                "yield": "%.1f" % finw, "ratio": ratio, "timeStr": "%d:%02d" % (mm, sec),
                "peak": "%.1f" % maxp, "spark": spark, "mass": mass, "press": press,
                "maxT": max(40.0, dur * 1.05), "maxMass": max(50.0, finw * 1.1),
            })
        self._shots = shots
        self.shotsChanged.emit(shots)

    @pyqtSlot(int)
    def loadReplay(self, index):
        """Upload a saved shot's recorded pressure curve to the firmware and put
        the machine into heating, ready to repeat it. The UI then calls
        beginReplay() (tap-to-start) to actually run the curve."""
        if not self.connected:
            return
        shots = getattr(self, "_shots", [])
        if not (0 <= index < len(shots)):
            return
        press = shots[index].get("press") or []
        if len(press) < 2:
            self.errorOccurred.emit("This shot has no pressure curve to replay")
            return
        # Downsample to ≤60 vertices (firmware holds 64); always keep the last.
        step = max(1, len(press) // 60)
        pts = press[::step]
        if pts[-1] is not press[-1]:
            pts.append(press[-1])
        self.serial.send_command("STOP")
        self.serial.send_command("REPLAY_LOAD %d" % len(pts))
        for p in pts:
            self.serial.send_command("REPLAY_PT %.2f %.2f" % (float(p["t"]), float(p["v"])))
        self.serial.send_command("START_BREW")
        self.temp_controller.set_mode("BREW")
        self.safety.start_brew_timer()
        self.logger.log_command("Replay loaded (%d pts) shot=%d; heating" % (len(pts), index))

    @pyqtSlot(float)
    def setDose(self, grams):
        """Set the basket dose (g) used to compute the brew RATIO. Persisted."""
        grams = max(5.0, min(40.0, grams))
        self._dose_g = grams
        self.settings_manager.save_settings(self._brew_target_temp,
                                            self._steam_target_temp, dose=grams)
        self.doseChanged.emit(grams)
        self.logger.log_command("Set dose: %.1f g" % grams)

    @pyqtSlot()
    def beginReplay(self):
        """Start the brew that follows the loaded replay curve."""
        if not self.connected:
            return
        self.serial.send_command("BEGIN_REPLAY")
        import time
        self._brew_start_time = time.time()
        self._brewing = True
        self._timer.start(500)
        self.logger.log_command("BEGIN_REPLAY")

    @pyqtSlot()
    def emergencyStop(self):
        """Manual emergency stop from UI"""
        self.logger.log_safety_event("Manual emergency stop")
        
        # Stop all operations without showing error dialog
        if self.connected:
            self.serial.send_command("ABORT")
            
        self.temp_controller.set_mode("IDLE")
        self.safety.stop_brew_timer()
        self.safety.stop_steam_timer()
        self._timer.stop()
