mklod/silvia-lever/(commit log)

2026-03-21 Initial commit — Silvia Lever espresso machine controller
    Teensy 4.0 firmware, PyQt6 UI (Windows + RPi), hardware docs,
    test sketches, and project configuration.
2026-04-17 Alpha release — full hardware integration verified
    Scale: ±0.1 g stability achieved with 32-sample averaging via getWeight(true, 32).
    Cal factor 2050.65 persists in settings.json, restored on UI connect with guards
    against invalid values. Old load cell had silently failed and was replaced with
    new mechanical assembly.
    Plumbing: V1 polarity inverted so de-energised default routes pump→thermoblock
    (heaviest duty). V2 wired with portafilter manifold on IN, OUT2=drain — instant
    pressure relief on de-energise. Flush state corrected to send water through
    portafilter while active and dump pressure to drain on stop.
    Firmware: SPI hard-reset at top of setup() resolves Teensy 4.0 LPSPI4 stale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
    [config.h, config.py, data_logger.py, dual_max31865_pt1000_C.ino, flow_test.ino, flow_test_v3.ino, pump_enable_test.ino, qml_backend.py]
2026-04-17 RPi cross-platform deployment + touchscreen UX
    - Single shared `ui/source/` tree (was `ui/windows/source/`), runs on both
    Windows dev and Raspberry Pi via `platform_shim.py` — detects RPi via
    `/proc/device-tree/model`, applies `QT_SCALE_FACTOR=2` for the 1080p
    touchscreen target, enables fullscreen. Stale `ui/rpi/pyqt6/` tree removed.
    - `ui/rpi/setup_rpi.sh` one-shot Pi OS Bookworm setup: full Qt6/QML runtime,
    qt6-wayland + qt6-svg-plugins, Teensy udev rule (`99-teensy.rules`) that
    tells ModemManager to ignore VID 0x16C0 and pins dialout:0660 perms,
    pcmanfm `single_click=1` + `quick_exec=1` for true one-tap launch, renders
    desktop shortcut from template with rendered logo ic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
    [config.py, data_logger.py, debug_log.py, main.py, mock_serial_manager.py, platform_shim.py, qml_backend.py, real_serial_manager.py]
2026-05-22 Stage 0 brew control, RPi deployment hardening, profile docs
    Brew control (firmware):
    - Slew-rate-limited single-loop pressure control replaces the old
    open-loop PWM ramp. One PI(D) loop, setpoint slews 1.0->9.0 bar at
    0.8 bar/sec; integrator self-adapts to puck restriction. Zero overshoot
    on a fine restrictive grind (earlier designs hit 14 / 11.5 bar).
    - Manual takeover: rotate pot >10% mid-brew -> bumpless handoff to pot.
    - AUTO/MANUAL toggle: autoBrewMode flag, SET_AUTO_MODE command,
    BREW: AUTO/MAN button in UI debug row.
    - PREINFUSE retuned to 1.0 bar, exit on 1 g or 10 s hard cap.
    - Thermoblock PID autotune, bang-bang warmup, derivative-on-measurement.
    UI:
    - Chart big-numbers f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
    [steam boiler amps.csv, thermoblock amps.csv]
2026-05-22 PROFILES.md §3: light-roast profile plan + Ascaso headspace diagnostic
    Adds the actionable Stage 1 plan: minimal segment-table profile engine
    design, Blooming Allonge spec adapted to our pressure-controlled hardware,
    five light-roast profiles, and a build order.
    §3.5 documents the Ascaso-group headspace mismatch: 20 g in a stock Silvia
    double basket gives a near-witness-mark on the old Silvia group but massive
    headspace + channeling on the Ascaso thermoblock group with every other
    variable static -> vertical geometry mismatch (screen-to-bayonet distance).
    Fix path: Ascaso-matched / taller basket, then puck screen.
    Old JSON-profile-system section renumbered to §4.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
2026-05-22 Stage 1: brew profile engine + Gentle & Sweet profile
    Firmware: a profile is an ordered segment list; runBrewSegmentEngine()
    slews the pressure setpoint per segment through the shared PI(D) loop and
    advances on weight/duration/pressure exit criteria. Replaces the hardcoded
    preinfuse/ramp/hold state machine. Two built-in profiles — Profile 0
    "Standard 9-bar" (Stage-0 regression baseline) and Profile 1 "Gentle &
    Sweet" (light-roast, flat 6 bar hold). New SET_PROFILE / GET_PROFILES
    serial commands. Manual pot takeover preserved.
    UI: PROF: picker button in the debug row cycles profiles; qml_backend
    learns the profile list from firmware via GET_PROFILES (no hardcoded
    names).
    Compiled + flashe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
    [qml_backend.py, silvia_lever_main.ino]
2026-05-22 PROFILES.md §3.5: correct basket-depth physics for Ascaso headspace
    Earlier text said a "tall" basket "seats the puck higher" — backwards.
    The portafilter holds the basket rim at a fixed height; the puck sits on
    the basket bottom, so a deeper basket parks the puck LOWER (more
    headspace). The Ascaso Steel UNO ships matched 58mm baskets (7/14/18g);
    the deep Rancilio Silvia basket is the mismatch. Fix: try an Ascaso 18g
    basket first (free — shipped with the machine).
2026-05-22 PROFILES.md §3.5: headspace root cause = E61-vs-Rancilio bayonet mismatch
    The Ascaso 58mm group is an E61-bayonet group (all aftermarket 58mm E61
    portafilters list Ascaso compatibility). The Rancilio Silvia portafilter
    is Rancilio-pattern, not E61 — it locks into the Ascaso group but seats at
    the wrong height, hence the massive headspace and channeling. Fix is a
    ~$30 aftermarket 58mm E61 bottomless portafilter plus the correct Ascaso
    group gasket (7.8mm for Steel/Dream PID), not the $300 Ascaso OEM.
    Revision-log history of the earlier (wrong) basket-depth theories
    consolidated into one accurate entry.
2026-05-22 Light-roast profiles (Blooming Allonge/Espresso/Allonge) + debug-row cleanup
    Firmware: three new brew profiles via the segment engine — Blooming
    Allonge (4-seg fill/bloom/percolate/declining-taper, the fruity ultra-
    light-roast profile), Blooming Espresso (3-seg), Allonge (2-seg flat
    5 bar). PROF picker now cycles 5 profiles.
    UI: removed the V1/V2 valve-state cells from the debug row — water flow
    and valve switching are verified working; row now shows heat, brew mode,
    profile, scale, pressure, pump.
    Compiled clean, flashed, GET_PROFILES confirms all 5. Brew-test pending.
2026-05-29 Remove always-on prime popup on brew tap
    The thermoblock is effectively always primed in normal use, so the prime
    overlay that appeared every time BREW was tapped was pure friction. Removed
    the overlay and the brewPrimingOpen=true trigger; the home BREW button still
    kicks thermoblock heating directly (heatBrew) and the tap-to-brew area gates
    on HEATING_BREW + scalesSettled, independent of priming. Prime manually with
    FLUSH if the machine has been sitting dry. brewPrimingOpen property retained
    (never set true) to avoid touching the steam-priming overlay.
2026-05-29 Add PROFILES_CHEATSHEET.md — plain-language profile guide
    User-facing cheat sheet for the 5 brew profiles: what each aims for
    (bloom/ramp/hold/taper in plain words), grind tips, a quick-picker table,
    and troubleshooting. No firmware internals — that lives in PROFILES.md.
2026-05-29 CHANGELOG TODO: pot RC filter + Pi undervoltage, both low priority
    RC filter deprioritized — manual takeover under the profile engine already
    feels responsive/smooth, better than plain manual mode. Pi undervoltage
    during flash noted as low priority; 5V cable+supply good, stable at runtime,
    likely USB re-enumeration inrush not the rail.
2026-05-29 Add PROFILES_REFERENCE.html — annotated profile curves + step tables
    Self-contained HTML reference sheet for verifying brew accuracy. Renders an
    SVG pressure-setpoint curve per profile (phase-shaded, annotated exits) plus
    a step table (phase, target bar, ramp rate, timing, exit criteria) and grind
    note. Numbers mirror the firmware segment arrays in silvia_lever_main.ino.
    Markdown can't draw graphs; this is the visual ref. PROFILES.md stays the
    engineering doc, PROFILES_CHEATSHEET.md the plain-language picker.
2026-05-29 Stage 9 boiler: dry-fire prime gate, heater arbitration, 2-gauge home
    Firmware (task-switch model, no extra hardware):
    - boilerPrimed dry-fire gate — no heating until boiler cold-primed
    (PRIME_BOILER fill -> overflow -> PRIME_DONE). RAM flag, re-required each
    cold boot.
    - arbitrateHeaters() replaces the unconditional thermoblock call: steaming
    hard-cuts the thermoblock + runs boiler; cold-start preheats boiler first
    (thermoblock inhibited until boiler at target, latches preheatComplete);
    brew/idle runs thermoblock with boiler maintenance only on ticks the
    thermoblock didn't fire (1-tick mutex -> SSRs never both on -> <=8.3 A).
    - Steam target = steamTemp + STEAM_PREHEAT_OVERSHOO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
    [config.h, qml_backend.py, silvia_lever_main.ino]
2026-05-29 Per-gauge setpoint popup; tap gauge adjusts only that loop's temp
    Tapping the thermoblock gauge opens a focused popup to adjust ONLY the brew
    setpoint (60-110C); tapping the boiler gauge adjusts ONLY the steam setpoint
    (110-150C). Large -/+ controls, applies immediately via setTemperatures,
    tap-outside or DONE to dismiss. Scale calibration and PID tuning stay out of
    this popup (still on settingsScreen). Replaces the old gauge-tap -> full
    settings screen.
2026-05-29 CHANGELOG TODO: future UI access to scale-cal + PID autotune
    Gauge tap now opens a per-loop setpoint popup only; scale calibration and
    PID autotune need a deferred re-entry gesture (long-press / hidden tap /
    gear icon -> settingsScreen).
2026-05-29 Fix: steam SSR on pin 16 needs digitalWrite (Teensy 4.0 pin 16 has no PWM)
    Steam-test phase 2 found the boiler SSR never energized despite firmware
    reporting heaterSteam=1. Root cause: HEATER_STEAM_PIN is pin 16, which is
    NOT PWM-capable on Teensy 4.0 (PWM pins: 0-15, 18-19, 22-25, 28-29, 33-39).
    analogWrite() on pin 16 is a silent no-op, so the pin never drove the SSR.
    The brew heater on pin 15 (PWM-capable) was unaffected.
    The boiler SSR is on/off only, so swap all 8 analogWrite(HEATER_STEAM_PIN,..)
    to digitalWrite high/low — works on any pin, correct for a zero-cross SSR,
    no rewiring. config.h documents the pin-16 PWM limitation.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
    [config.h, silvia_lever_main.ino]
2026-05-30 Add OG_SILVIA_OPERATION.md — boiler fill/steam/OPV/dry-fire reference
    Researched writeup of how the OG single-boiler Silvia manages fill (flow-
    through brew), steam (self-forming headspace via OPV expansion-return to
    reservoir — purge optional), water level, the two-hose OPV, and the dry-fire
    failure. §6 ties it to our build: our steam boiler is a repurposed OG Silvia
    boiler (steam-only, never refilled by brewing), and crucially neither the
    thermal fuse nor the PT1000 prevents element burnout (both watch body temp,
    too slow/indirect vs element-surface spike on dry-fire). Real fix = water
    level sensing (conductivity probe); interim = proactive pump top-up erring
    full (OPV returns overfil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
2026-05-30 Add LEVEL_SENSING.md; cross-ref from OG Silvia doc
    Steam-boiler water-level sensing design: why fuse+PT1000 can't prevent
    element burnout (both watch body temp, too slow/indirect vs element-surface
    spike on dry-fire), the hard interlock principle (element fires only when
    water confirmed above probe), conductivity-probe options (off-the-shelf
    Gicar/CEME module vs DIY AC-excitation), firmware-hook plan (boilerWaterOk
    gate in arbitrateHeaters, auto-refill, telemetry), and a parts list.
    OG_SILVIA_OPERATION.md §6 trimmed to a summary + link, plus a note that the
    historical burnout is a characterized risk, not a present blocker.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
2026-05-30 OG Silvia doc §5b: OPV pressure↔steam-temp tuning + headspace sizing
    Adds the steam-test findings: (1) the OPV relief pressure caps boiler temp
    (saturation table) — virgin OPV set too low dumps at ~99C before steam forms;
    tune it to hold the pressure for the target steam temp (130C->1.7bar,
    135C->2.1bar), and keep firmware steam setpoint consistent with the OPV or the
    element runs forever. (2) Headspace is separation+buffer, not storage (75mL
    holds ~0.11g steam vs ~20g/latte); ~10-25% is the range, our near-top side
    port gives ~5-10% (borderline but workable); a 0.3L boiler does ~4-5 lattes
    per fill.
2026-05-30 LEVEL_SENSING: lock in Silvia Pro probe + auto-fill-to-probe model
    Decision: do as the Silvia Pro does. Probe = Rancilio Silvia Pro water-level
    probe (part 10701803, 3/8 BSP, ~$15). Model = maintain level at the probe
    (dry -> pump refill to wet -> stop), which (1) keeps the level above the
    element so burnout protection is implicit, and (2) replaces the manual prime
    with automatic fill. Teensy owns the fill (pump+V1 shared with brewing) so we
    use sense-only from the probe, not a Gicar pump-driving box. MAX_STEAM_TEMP +
    thermal fuse stay as fault backstops.
2026-06-01 Steam verified on hardware: OPV tuned, staged dual-heat + arbitration confirmed
    OPV adjustment solved the 99C dump (was relieving at ~0 bar → boiled off
    before steam; torqued to hold steam pressure → boiler to 140C, no spitting on
    return hose). Cold-start staging confirmed (boiler first → BOILER_READY →
    thermoblock to setpoint). Steam-SSR digitalWrite fix working. HEATING.md §5
    gets a verified heater-state-by-mode table (BREW throttles boiler via tick-
    mutex, doesn't cut it; STEAM hard-cuts thermoblock). _status milestone bumped
    to Alpha+ (boiler live). Level probe still pending for auto-fill/dry-fire.
2026-06-01 OG Silvia doc §5c vacuum breaker + §5d steam-boiler safety review
    §5c: anti-vacuum valve function (cool-down vacuum/suck-back prevention +
    heat-up air purge = auto dry steam). Notes our 3-way valves block reservoir
    suck-back, so for us the breaker is mainly seal-stress safety + steam-quality
    QoL; warranted ahead of the (nice-to-have) fill probe.
    §5d: ranked steam-boiler safety review. #1 = verify the torqued-down OPV still
    RELIEVES at a safe pressure (not bottomed shut → unprotected pressure vessel);
    #2 dry-fire/burnout (level probe is the fix); #3 firmware-hang runaway (only
    mechanical OPV+fuse catch it → consider hardware watchdog); plus vacuum,
    scald/hot-water routing, electrical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
2026-06-01 Add hardware watchdog (Teensy 4.0 WDT) — runaway-heat hang safety
    2 s WDT_T4 watchdog, started after the blocking sensor/bus init, fed every
    loop(). If the main loop stalls (hang/lockup) it hard-resets the MCU: SSR pins
    go LOW and boilerPrimed (RAM) clears, so no heat resumes until re-primed. This
    closes the OG_SILVIA_OPERATION.md §5d #3 gap (firmware-hang runaway with the
    steam SSR on — previously only the mechanical OPV + thermal fuse caught it).
    New build dep: tonton81 WDT_T4 (github, not in registry) -> Arduino/libraries.
    [silvia_lever_main.ino]
2026-06-01 OG Silvia §5d: correct safety framing — not a bomb, dry-fire is the real risk
    The boiler is a repurposed OG Silvia boiler that routinely sees 9-12 bar on
    the brew side, so its body/seals are validated far above any steam pressure
    (2-3 bar). At these pressures failure = slow seal/joint weep (scald), not
    instantaneous rupture — not a "bomb." So OPV precision isn't safety-critical;
    a rough field adjustment (good steam, no needless blow-off, still relieves if
    pushed) is fine — no gauge/one-off plumbing needed. Re-ranked: dry-fire/element
    burnout is the actual #1 residual risk (level probe is the fix); firmware-hang
    now closed by the watchdog; over-pressure well-covered by 9-bar vessel + t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
2026-06-02 UX pass: degF units, cyan/purple gauges, AUTO + auto-heat defaults
    - UI displays degF everywhere (gauges, brew/steam screens, setpoint popup);
    firmware stays degC, UI converts (cToF/fToC); popup steps 1degF, clamps in
    degF, converts back for SET_TEMP.
    - Gauge colors: thermoblock cyan #00bcd4, boiler purple #9b59b6 (was
    blue/orange); popup + PRIME button recolored.
    - Brew mode defaults AUTO (firmware autoBrewMode=true), surfaced via new
    telemetry field 17 so the UI button reflects it on boot.
    - Removed SCALE cell from the debug row.
    - Auto-heat from cold boot without manual prime: boilerPrimed defaults true
    (accepted dry-fire risk; backstops MAX_STEAM_TEMP/fuse/watchdog stay; level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
2026-06-11 Brew stop: require double-tap; fix cumulative timer/double-log
    Diagnosed the "brew stopped at 46s on its own" report: the brew screen's
    full-screen tap area stopped the shot on ANY single tap (stray capacitive
    ghost tap during a long manual brew). Not a timeout — no auto-stop exists
    below the 300s safety cap.
    - Brew area: single tap only starts; stopping needs a deliberate
    double-tap (onDoubleClicked). Added tap/double-tap hint under timer.
    - stopBrew(): gate duration logging on a new _brewing flag so a stop
    after the brew already ended no longer logs a bogus cumulative
    BREW_COMPLETE (logs showed 46s then 54s for one shot). STOP is still
    always sent to firmware.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
    [qml_backend.py]
2026-06-11 Brew stop: single tap on timer clock (replace unreliable double-tap)
    Double-tap on the brew area was fiddly on the touchscreen. Instead:
    - Big central area is now start-only and DISABLED while brewing, so a
    stray tap anywhere can't end a shot.
    - Stopping is a single tap on a focused MouseArea over the timer clock,
    enabled only while BREWING. Clock glows amber while brewing as the
    stop affordance; hint reads "tap clock to stop".
2026-06-11 Add UI screenshot harness + rendered screens for design iteration
    _render_screens.py renders every screen/state from the real QML offscreen
    (mock serial, no Teensy) to 1920x1080 PNGs. Disables Shape FBO layers so the
    gauge arcs paint under the software renderer. 10 screens captured under
    ui/screenshots/ with an index README — portable assets for a UX redesign pass.
    [_render_screens.py]
2026-06-11 Screenshots: brew screen with a real recorded brew; trim to screens 1-6
    Screen 06 now renders an actual historical shot (brew_2026-06-09_19-16-20:
    46s, 9-bar, 42g) injected into the live charts — proof-of-concept for a
    replay/brew-preview feature. Harness stops the mock feed after connect so
    staged state sticks, and loads brew_logs JSON into coffee/pressure charts.
    Dropped screens 7-10 (only 1-6 needed for design).
2026-06-16 Default steam temp -> 250F (121.11C); restore setpoints to firmware on boot
    Voice-to-code (id 4e1b9ef5): make the default steam boiler temp 250F on
    startup. Changed DEFAULT_STEAM_TEMP (config.h), settings_manager + main.qml
    defaults.
    Also push persisted brew/steam setpoints to the firmware on connect via a new
    _restore_temperatures() (mirrors the scale-cal / PID restore). Temps were the
    only saved setting not restored on boot, so the firmware kept its config.h
    defaults until the setpoint popup was opened (UI/firmware divergence). Now the
    saved setpoints are authoritative on every boot, so the new default takes
    effect without a reflash. Verified: OK:STEAM_TEMP_SET on reboot.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
    [_render_screens.py, config.h, qml_backend.py, settings_manager.py]
2026-06-17 Heaters OFF by default on startup (no auto-heat on reboot)
    Firmware heatersEnabled default flipped back to false (was a leftover
    TEST MODE override; the comment already documented OFF as intended).
    Since the Teensy keeps state across Pi reboots, the UI also pushes
    SET_HEATERS_ENABLE 0 on connect so heaters are off on every restart
    without needing a reflash. User taps HEAT to enable when brewing.
    Verified: OK:HEATERS_DISABLED + telemetry heatersEnabled=0 on reboot.
    [qml_backend.py, silvia_lever_main.ino]
2026-06-17 Precision Instrument redesign — all 5 screens (review build)
    New parallel UI (main_precision.qml + precision/ component library) reusing
    the CoffeeController backend. Implements the full "Precision Instrument" spec:
    true-black, monochrome + single red accent, Archivo + JetBrains Mono (bundled
    + FontLoader). Screens: Home (ColumnMeters + hero numerals), Set-temp modal,
    Brew (live white-mass/red-pressure glow charts), Profile picker (firmware-
    accurate phase data + PhaseChart + table), Shot history/replay.
    Components: Theme singleton (design tokens), Overline, PButton, StatusBar,
    ColumnMeter, ChartCard, StatItem, InstrumentCol, Sparkline, PhaseChart,
    BackChip. Glow via Canvas shadowBlur (re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
    [_render_precision.py]
2026-06-17 Redesign: wire shot history + replay, activate profiles, go live
    - Backend requestShots()/shotsChanged reads brew_logs/ into the history
    list; profile-row tap activates via setProfile(); brand tap opens history.
    - REPLAY animates the stored curves (ChartCard clipT cutoff).
    - run_silvia.py + main.py now load main_precision.qml — the redesign is the
    live UI. Old main.qml retained as fallback.
    Verified on the real panel via grim (HEAT OFF default, SET 250/203, PRIMED).
    [main.py, qml_backend.py, run_silvia.py]
2026-06-17 Brew screen: add tap-to-start (was missing) + tap-TIME-to-stop
    Redesign Brew screen had no start affordance — tapping did nothing.
    Added a 'TAP TO START' layer while HEATING_BREW (calls beginBrew),
    and tap the red TIME clock to stop while BREWING. Also surfaces the
    heaters-OFF state so it's clear why it isn't warming.
2026-06-17 Fix PRIME (endless pump), heaters ON by default, FLUSH/STEAM active text
    - PRIME is now 3-state: tap to fill → button shows 'OVERFLOW? TAP' (red) →
    tap confirms (primeDone) and STOPS the pump. Previously only sent
    PRIME_BOILER with no way to stop — pumped until the 2-min timeout / reboot.
    - Heaters ON by default again: removed the UI startup SET_HEATERS_ENABLE 0
    push and reverted the firmware default to true (per user). Verified
    heatersEnabled=1 on boot.
    - FLUSH and STEAM button labels turn white→red while active (PButton.active).
    [qml_backend.py, silvia_lever_main.ino]
2026-06-17 PRIMED = red outline + 'PRIME' (no fill/check); add visible SHOT HISTORY entry
    PButton variants reworked: 'outline' (red border only, white text) for the
    armed/primed state, 'alert' (red fill+glow+text) reserved for attention
    ('OVERFLOW? TAP'). Steam PRIME button uses outline when primed, label stays
    PRIME. Added a tappable '↻ SHOT HISTORY' in the Home header (was a hidden
    brand-tap).
2026-06-17 History: scrollable ListView + opaque status footer
    Shot list is now a flickable ListView (touch-scroll through all saved shots),
    clipped to its bounds. Status bar background made opaque (was the translucent
    statusFill) so scrolling rows no longer bleed through the footer. Harden the
    render harness against partial/empty brew_log files.
    [_render_precision.py]
2026-06-17 Functional shot replay + phase-table spacing + heaters-off (dev)
    REPLAY now re-runs a saved shot's recorded pressure curve on the machine
    (repeat a god shot):
    - Firmware: upload a pressure-vs-time curve (REPLAY_LOAD/REPLAY_PT), then
    BEGIN_REPLAY runs a brew whose setpoint follows the curve via the existing
    pump PI; pot takeover still works; auto-stops at curve end. Flashed.
    - Backend: loadReplay(index) downsamples the shot's pressure curve, uploads it,
    and heats; beginReplay() starts it.
    - UI: History REPLAY → loads curve + heats + goes to brew screen showing
    'TAP TO REPLAY · <shot>'; tap starts it. Cleared on exit/normal brew.
    Also: phase-table columns get breathing room (spacin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
2026-06-17 Heaters ON by default at boot (build done; remove dev heaters-off push)
    Removed the startup SET_HEATERS_ENABLE 0 push now that development reboots
    are over. Firmware default is ON, so the machine heats on boot again.
    Verified heatersEnabled=1, no 'heaters OFF' on startup.
    [qml_backend.py]
2026-06-18 Add Settings screen (dose + scale cal + autotune); fix RATIO; bigger stop target
    - RATIO now uses a real, persisted DOSE (default 20 g) instead of a hardcoded
    18 g. New Settings screen (gear on Home) with a dose stepper, scale TARE +
    CALIBRATE (known-weight modal), and PID AUTOTUNE (progress modal). Dose stored
    in settings.json via backend setDose()/doseChanged.
    - Brew stop: replaced the small TIME-cell tap with a large central 'TAP TIMER
    TO STOP' band so stop is easy to hit (without re-enabling whole-screen stop).
    [_render_precision.py, qml_backend.py, settings_manager.py]
2026-07-07 Correct pump: Fluid-o-Tech FG300 24V BLDC gear pump, not Ulka vibratory
    The pump is an FG300 gear pump. 24V is motor supply only; speed control is a
    separate 0-5V analog input (pot -> Teensy PWM -> 1k/470nF RC filter). The RC
    node is <=5V, so a 10V cap on that filter is sufficient. Doc previously
    mislabelled it vibratory/Ulka, which caused repeated wrong assumptions.
2026-07-07 Docs: fix remaining stale pump refs, catch up _status + CHANGELOG, repo hygiene
    - PLUMBING_NOTES: the debug note about 'cutting AC / pump solenoid' was the
    last vibratory-pump assumption; rewritten for the FG300 gear pump.
    - _status.md: updated milestone to the redesign+replay reality; added an audit
    entry. CHANGELOG: added the redesign/replay/settings build; cleared TODO
    items now done (Settings screen, autostart, profiles).
    - .gitignore: exclude 8.1 GB archive/ and stray ping-output junk (deleted).
2026-07-14 Scale 3x faster + smoothed readout; button debounce; simplify PRIMING label
    - Scale: NAU7802 20 SPS -> 80 SPS with an 8-sample trimmed-mean window. The
    window is still exactly 100 ms = 6 cycles of 60 Hz, so mains rejection is
    preserved, but a fresh weight is now published every 100 ms (was 300 ms) —
    matching TELEMETRY_INTERVAL. Verified: weight changes every packet, noise
    still ~±0.1 g. Fixes big mid-brew mass jumps.
    - UI: mass readout animates between samples (displayWeight/shownWeight) so the
    numeral glides instead of stepping. Display only; charts/logs use raw weight.
    - PButton: 450 ms debounce so a bouncy/accidental double-tap can't toggle a
    latching button (FLUSH on->off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
    [silvia_lever_main.ino]
2026-07-14 HEATING §8: document open brew-temp stability + water-output accuracy problem
    Post-flush overshoot/ringing: grounded hypothesis is the 5C warmup band running
    full 255 PWM through the block's thermal lag, with TL gains autotuned at steady
    state (not against a cold-water disturbance). Separately, the PT1000 reads the
    BLOCK, not the water — the setpoint->water-out offset (flow dependent) has never
    been characterised. Written up with an experiment protocol; explicitly NOT
    blind-tuning the gains.
2026-07-15 Scale readout: lighter 90ms linear ease (was 260ms) so it tracks live, not laggy
    The 260ms display animation lagged behind the now-100ms weight updates, making
    the numeral feel floaty/iffy. Shortened to ~90ms linear (≈ the update interval)
    so it softens the 0.1-0.4g steps while tracking the live value.
    NOTE: deployed to Pi but live-verify pending — Pi dropped off-network after the
    post-deploy reboot (known undervoltage/brownout on restart).
2026-07-23 Scale ~1Hz latency: rolling trimmed-mean (firmware) + kill Repeater churn (UI)
    Two independent throttles, both measured:
    - Firmware: the loop pulls ONE scale sample per iteration and only published
    weight after filling 8, so sys.weight refreshed at the (blocked ~2-5 Hz)
    loop rate, not 10 Hz. Now a ring buffer recomputes the trimmed mean on
    EVERY new sample, so weight refreshes at the sample rate; telemetry catches
    a fresh value each 100 ms packet. Same hi/lo-trim noise rejection retained.
    - UI: the brew stats were a Repeater whose model was an inline array bound to
    the animating weight -> all 4 delegates destroyed+recreated ~60x/s. Replaced
    with explicit bound StatCells so only t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
    [silvia_lever_main.ino]
2026-07-23 Fix brew-time UI jank: ChartCard glow via layered strokes, threaded raster
    User pinned it: scale readout lag ONLY happened during a brew — which is
    exactly when the live charts repaint. ctx.shadowBlur is a per-draw Gaussian
    blur; 2 charts x growing polyline x 4 Hz was expensive enough on the Pi to
    jank the GUI thread and coalesce the MASS numeral to ~1 Hz. Replaced with
    3-pass layered strokes (visually equivalent bloom, render confirmed) and
    renderStrategy: Canvas.Threaded so rasterization stays off the GUI thread.
    Data chain separately verified good: press event tracked packet-by-packet
    at 10 Hz in telemetry (77g -> 427g -> 74g over ~700 ms, fresh value each
    100 ms packet).
    Co-Authored-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
2026-08-19 Pump noise: cap FLUSH + both PRIMING fills at 65% (PUMP_PWM_QUIET=165)
    Gear-mesh whine scales steeply with RPM and these were the only open-loop
    full-speed states — extraction is closed-loop and slow. Costs a little
    fill/flush time, removes the scream. Backflush still reaches OPV-crack
    pressure (blind basket -> flow~0 -> pump builds 12+ bar even at low speed).
    Manual pot control and brew pressure loops keep their full range. Flashed.
    Claude-Session: https://claude.ai/code/session_01WCiHknjkgDV1CNo2LPRxSg
    [config.h, silvia_lever_main.ino]
2026-08-19 Manual mode: pot-zero deadband — pump truly stops at 0%
    Two stacked causes had the pump running with the pot at zero:
    (a) EXTRACT pwm = pot + handoverOffset, so after a mid-brew takeover the
    residual offset kept pumping at pot-zero;
    (b) a few counts of pot/ADC offset put 0.2-0.3V on SPEED_IN — where the
    Fluid-o-Tech driver runs its 300 rpm floor instead of stopping.
    POT_ZERO_DEADBAND (10 counts ~4%) now forces PWM 0 at/below it, overriding
    the offset, at all three manual-drive sites. Flashed.
    Also confirmed by user: the 65% flush/prime cap massively reduced noise and
    eliminated the OPV chirp during boiler fill.
    Claude-Sessi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
    [config.h, silvia_lever_main.ino]
2026-08-19 PUMP_PWM_QUIET 65% -> 50%: keep fill/flush mesh below the ~650-1000Hz resonance
    Spectrogram order analysis of a recorded pot sweep showed gear-mesh orders
    (7-16x shaft) dominate by 6-11 dB over motor commutation (24x), amplified by
    a structural resonance at ~650-1000 Hz (same absolute peak at 982 Hz across
    different speeds/orders). At 65% the mesh band still clipped the resonance's
    lower edge; 50% puts it below. Measured true max speed ~4200 rpm. Motor swap
    ruled out by data (~1 dB benefit). Flashed.
    EOF
    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
    [config.h]
2026-08-19 Status: pump-noise diagnosis session (mesh+resonance, 50% cap, pot-zero fix)
2026-08-19 Status: refresh stale milestone (merged to master 07-06; current pending list)
